NickPham01/ES100/FinalReport/FinalImages/FR_B_straight.pdf

Audio Precision | 03/22/19 18:35:58

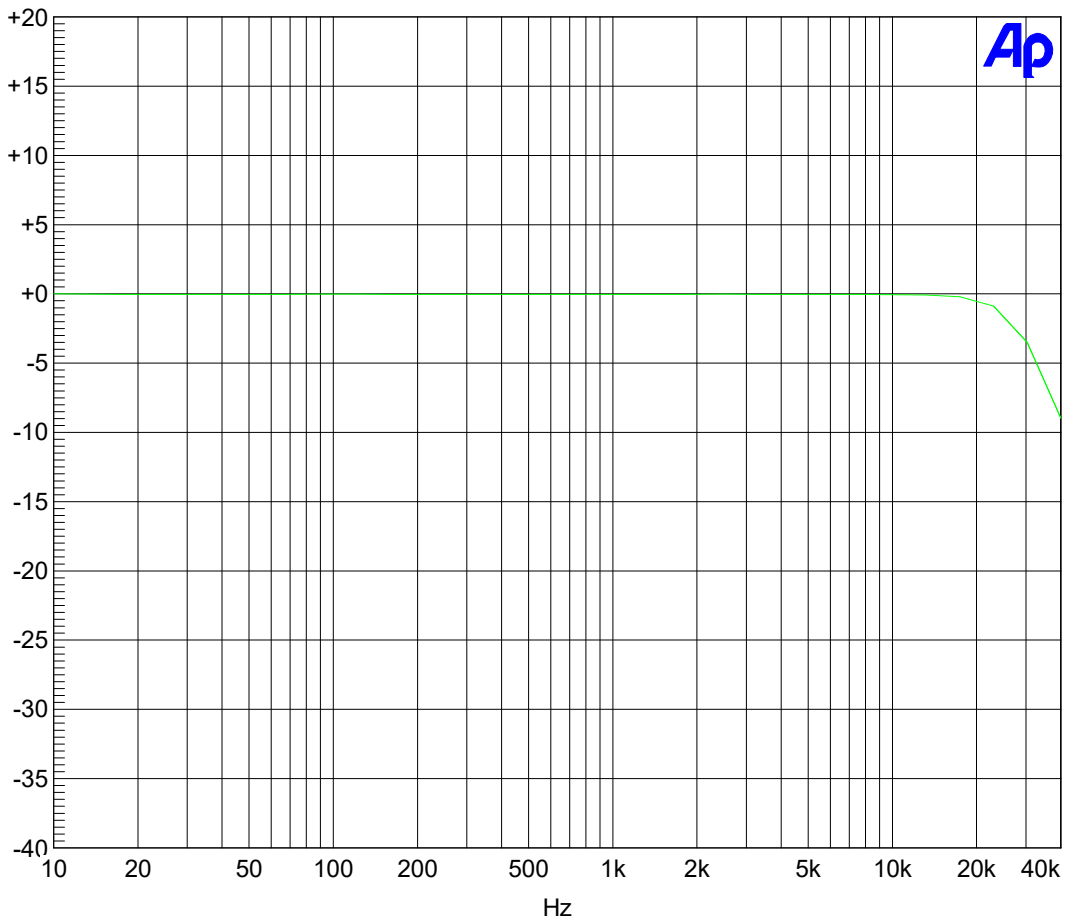
[picture p63: figure]

Pham THD_A.at1

Sweep Trace Color | Line Style Thick Data | Axis Comment
1 | 1 | Green Solid | 1 | Anlr.Ampl Left

d
B
u
