NickPham01/ES100/FinalReport/FinalImages/SummingAmpFR_A&B.pdf

Audio Precision | 03/22/19 18:29:06

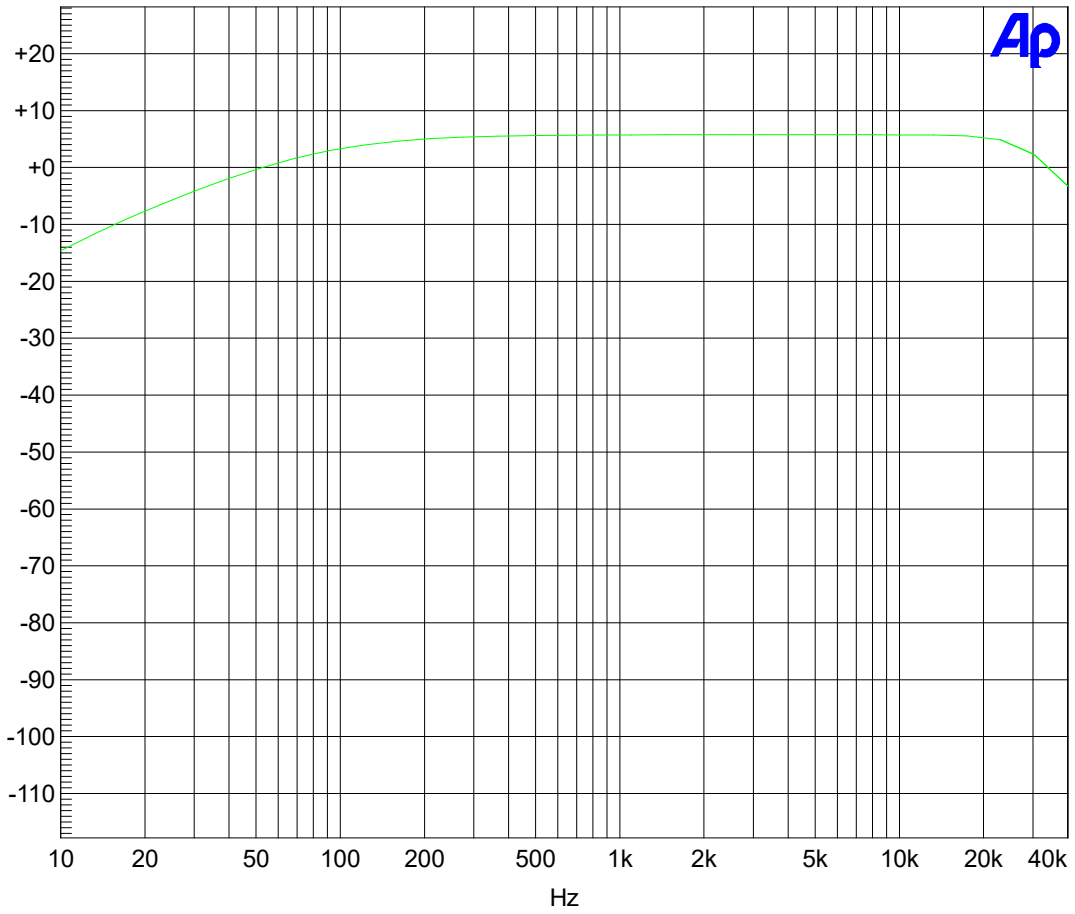
[picture p64: figure]

Pham THD_A.at1

Sweep Trace Color | Line Style Thick Data | Axis Comment
1 | 1 | Green Solid | 1 | Anlr.Ampl Left

d
B
u
