NickPham01/ES100/FinalReport/FinalImages/THDN_B_straight.pdf

Summing Amplifier THD+N | 03/22/19 17:54:46

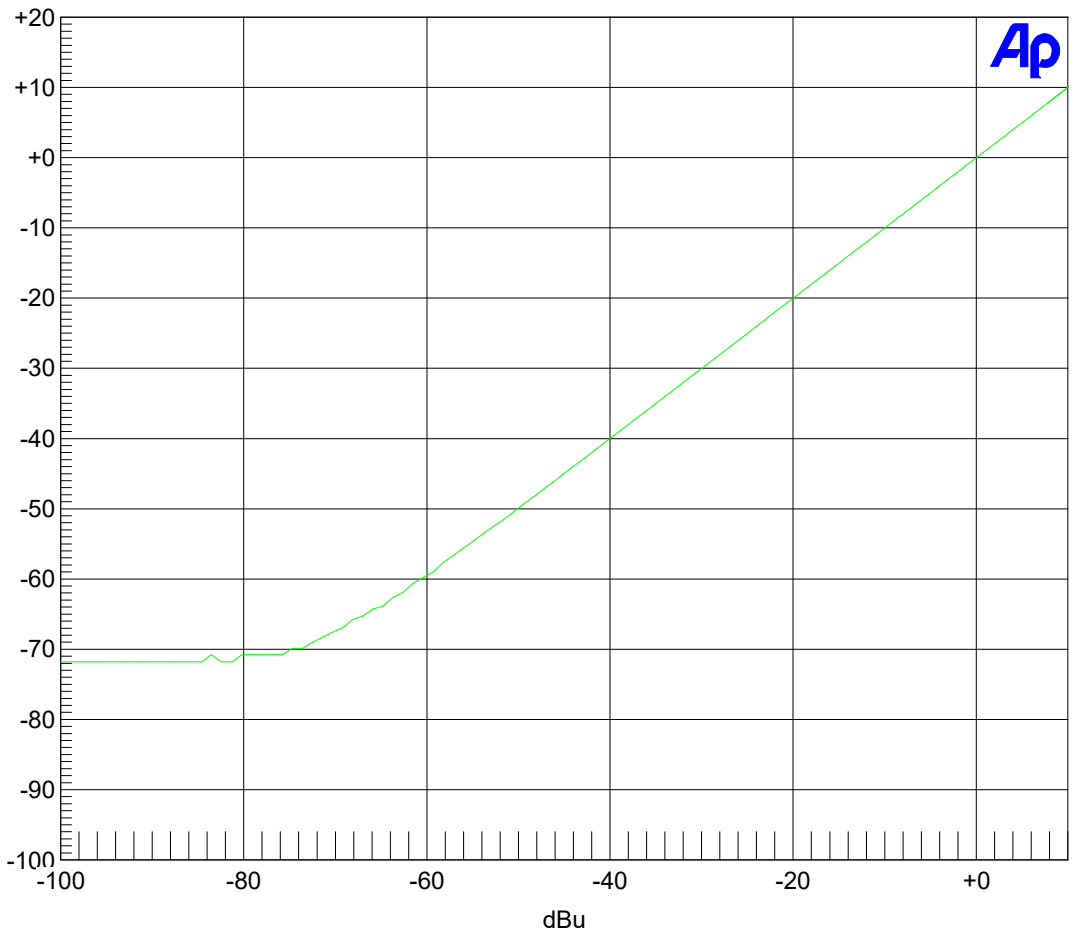
[picture p66: figure]
dBu

Pham THD_A.at1

Sweep Trace Color | Line Style Thick Data | Axis Comment
1 | 1 | Green Solid | 1 | Anlr.Level A Left

d
B
u
