NickPham01/ES100/FinalReport/titlepage.tex

\begin{titlepage}
	\begin{center}
		\vspace*{0.5in}
		\huge
		\textbf{Hot Swappable Guitar Effects Pedal Auditioning System}\\
		\vspace*{1in}
		\Large
		\textbf{Nicholas Pham} \\
		S.B. Candidate in Electrical Engineering \\
		\vspace*{0.5in}
		\textbf{Advisors: Jim MacAurthur, Scott Kuindersma}

		\vfill

		A senior design project submitted in partial fulfillment of the reqirements for the degree of Bachelor of Science at Harvard University. \\
		\vspace*{0.1in}

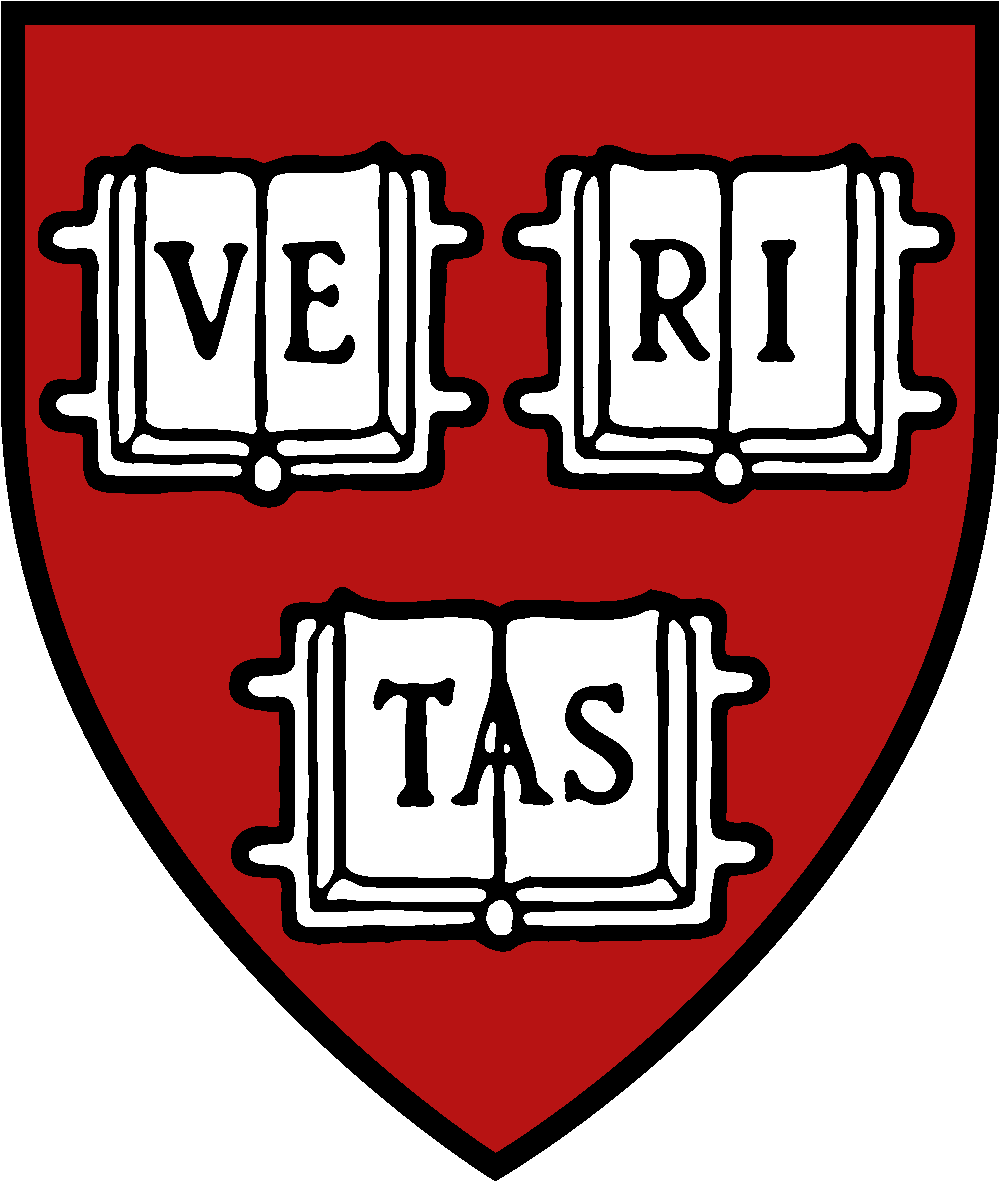
[picture p67: FinalReport/FinalImages/Harvard_shield-University.png]
		\\
		
		\vspace*{0.1in}
	    Harvard University School of Engineering and Applied Science \\
	    Cambridge, Massachusetts \\
	    April 5, 2019
	\end{center}
\end{titlepage}
