NickPham01/ES100/FinalPresentationReport/presentationLatex.pdf

r = % Reduction = tStandard − tSolution

tStandard

wk =

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
riwi = 65%

σ = 8.0%

Let
n = noise floor
m = maximum signal level

max signal = 18Vpp = 18.3 dBu
ndirect = −96.4 dBu (σ = 0.30 for n = 20) nsum = −72.2 dBu (σ = 0.11 for n = 20)

1

SNR =

m(V )
n(V )

= m(dBu) − n (dBu)

SNRdirect = 114.7 dBu
SNRsum = 90.5 dBu

2
