NickPham01/ES100/DesignReview/BlackPedalConnections.png

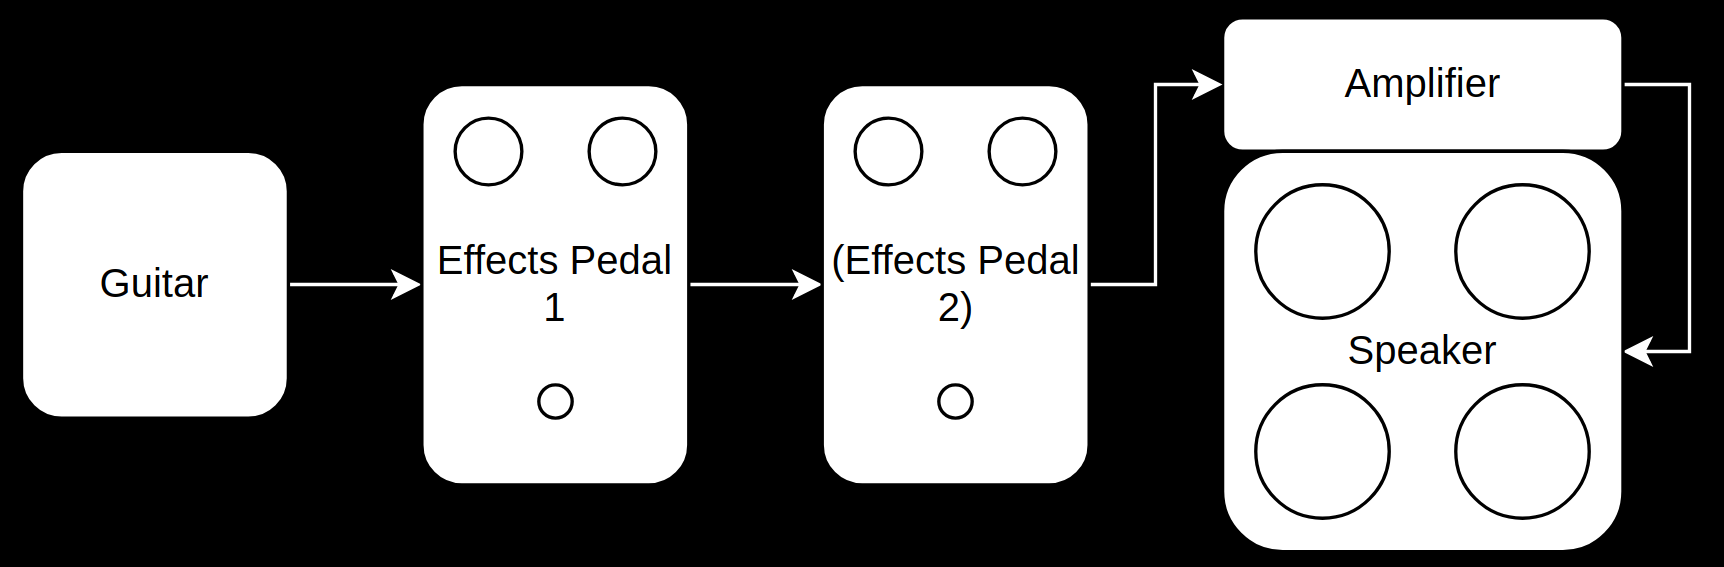
DesignReview/BlackPedalConnections.png
