NickPham01/ES100/DesignReview/GuitarPedalConnections.png

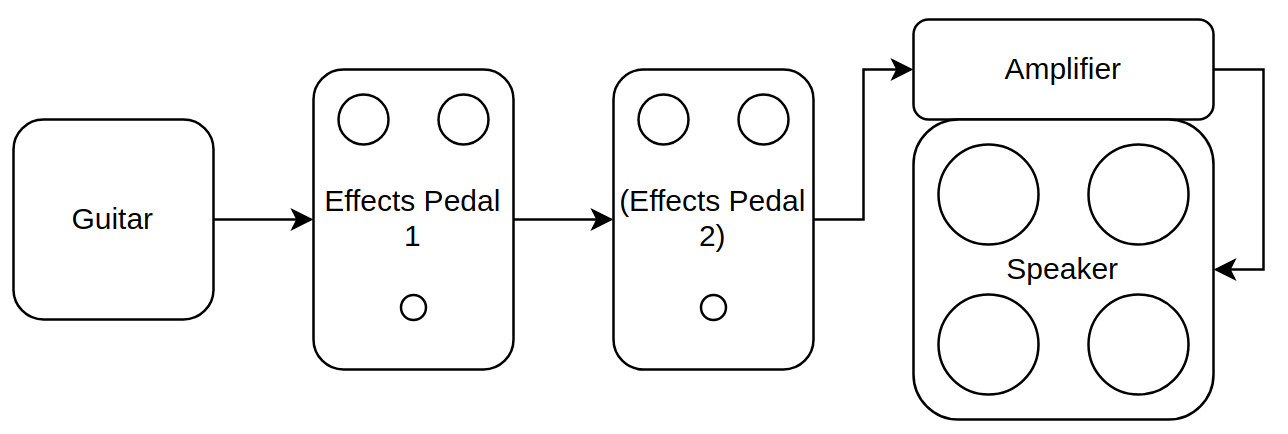
DesignReview/GuitarPedalConnections.png
