NickPham01/ES100/DesignReview/ReceiverAsm.PNG

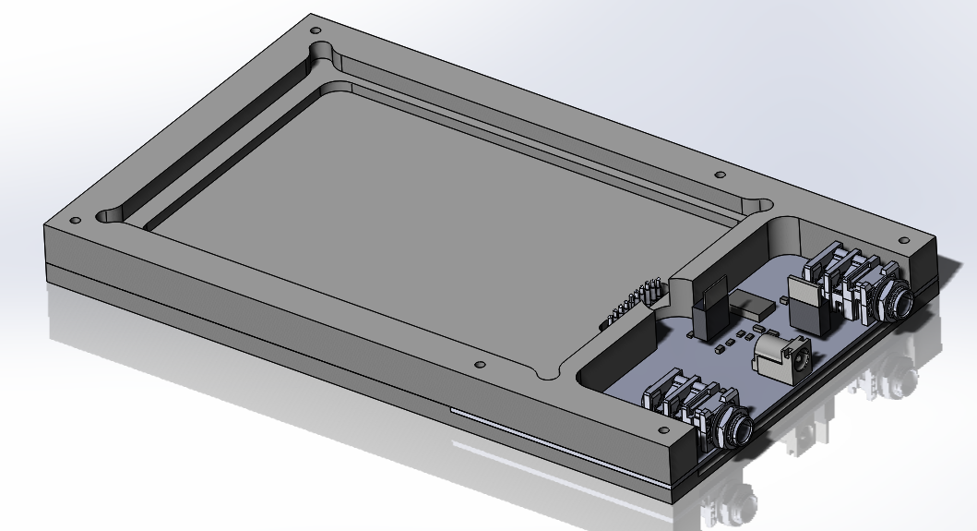
DesignReview/ReceiverAsm.PNG
