NickPham01/ES100/DesignReview/ReceiverPlateWPedal.PNG

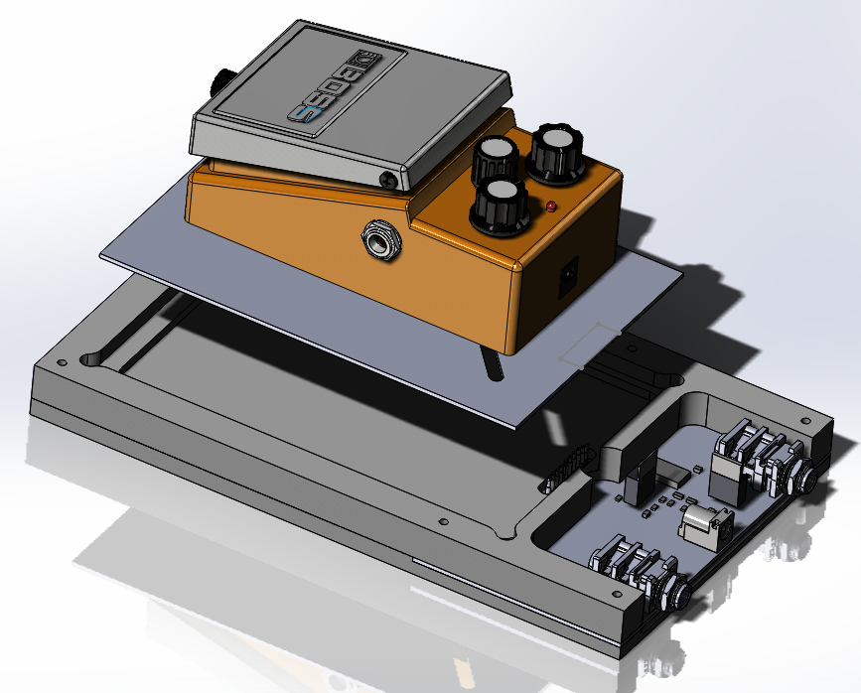
DesignReview/ReceiverPlateWPedal.PNG
