NickPham01/ES100/DesignReview/SystemDiagram.png

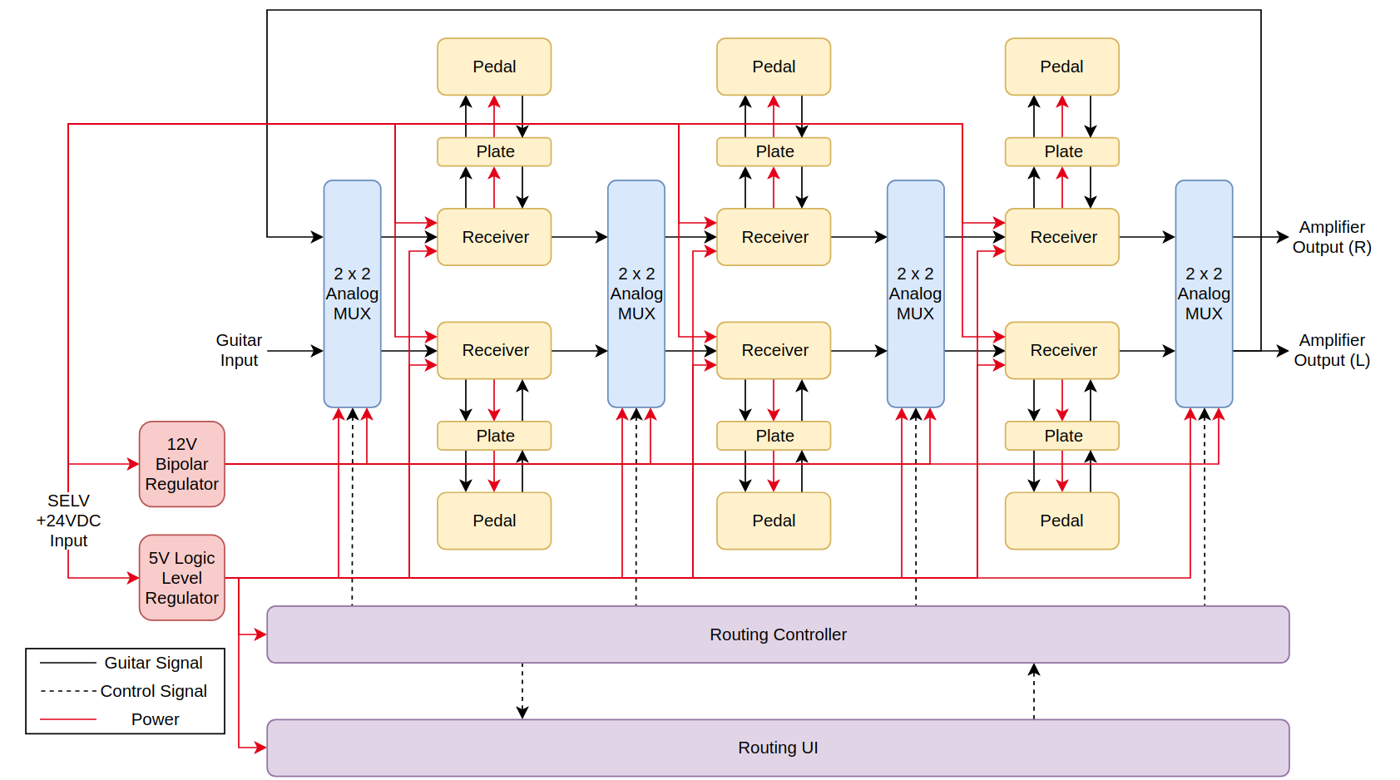
DesignReview/SystemDiagram.png
