NickPham01/ES100/DesignReview/Timeline.png

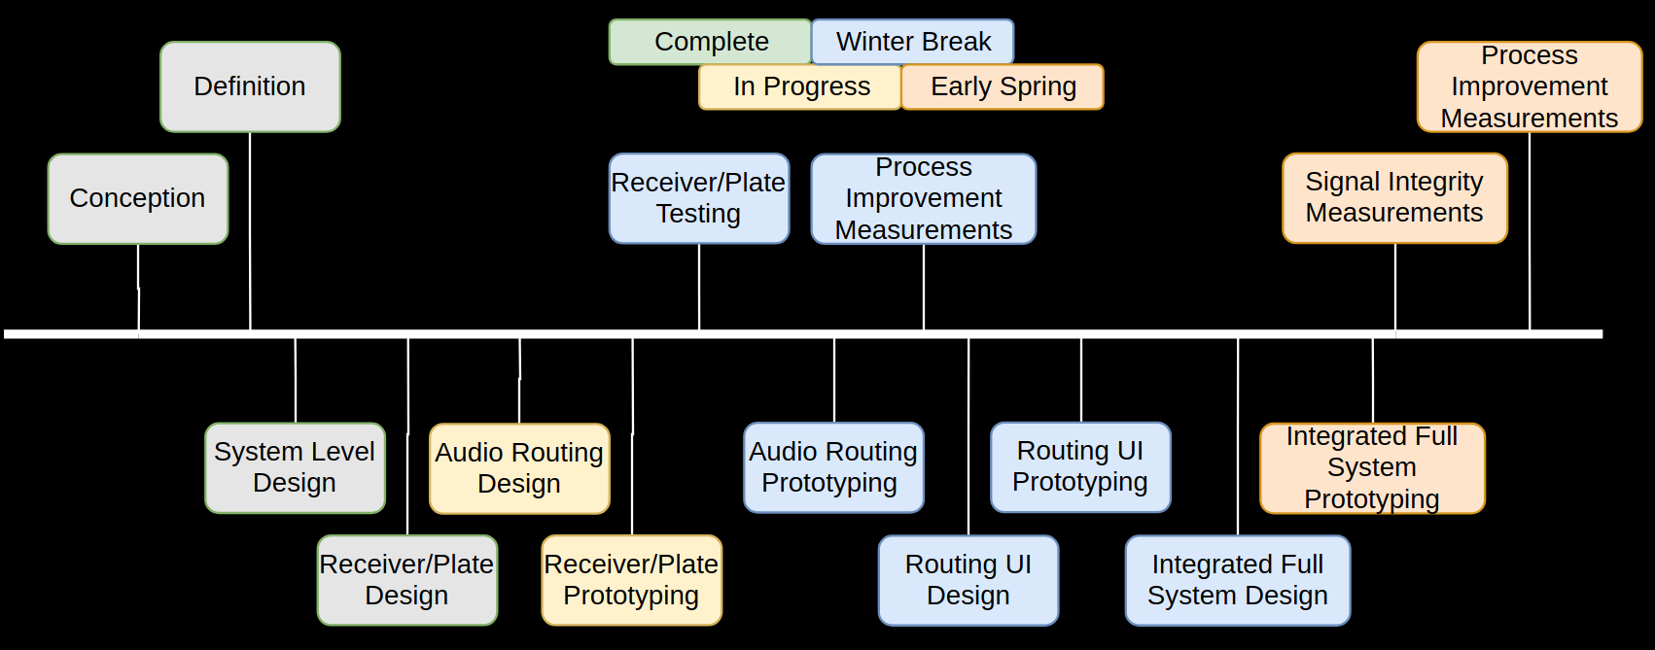
DesignReview/Timeline.png
