NickPham01/ES100/FinalPresentationReport/average_savings_formula.png

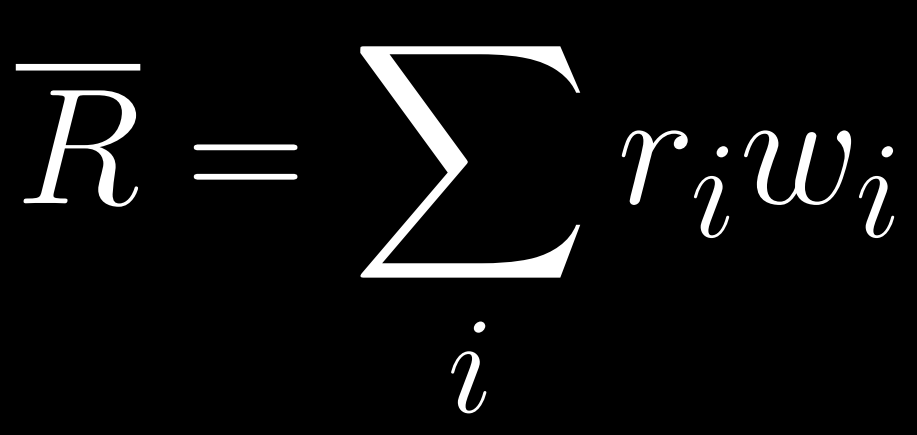
FinalPresentationReport/average_savings_formula.png
