NickPham01/ES100/FinalPresentationReport/DirectFrequencyResponse_black.jpg

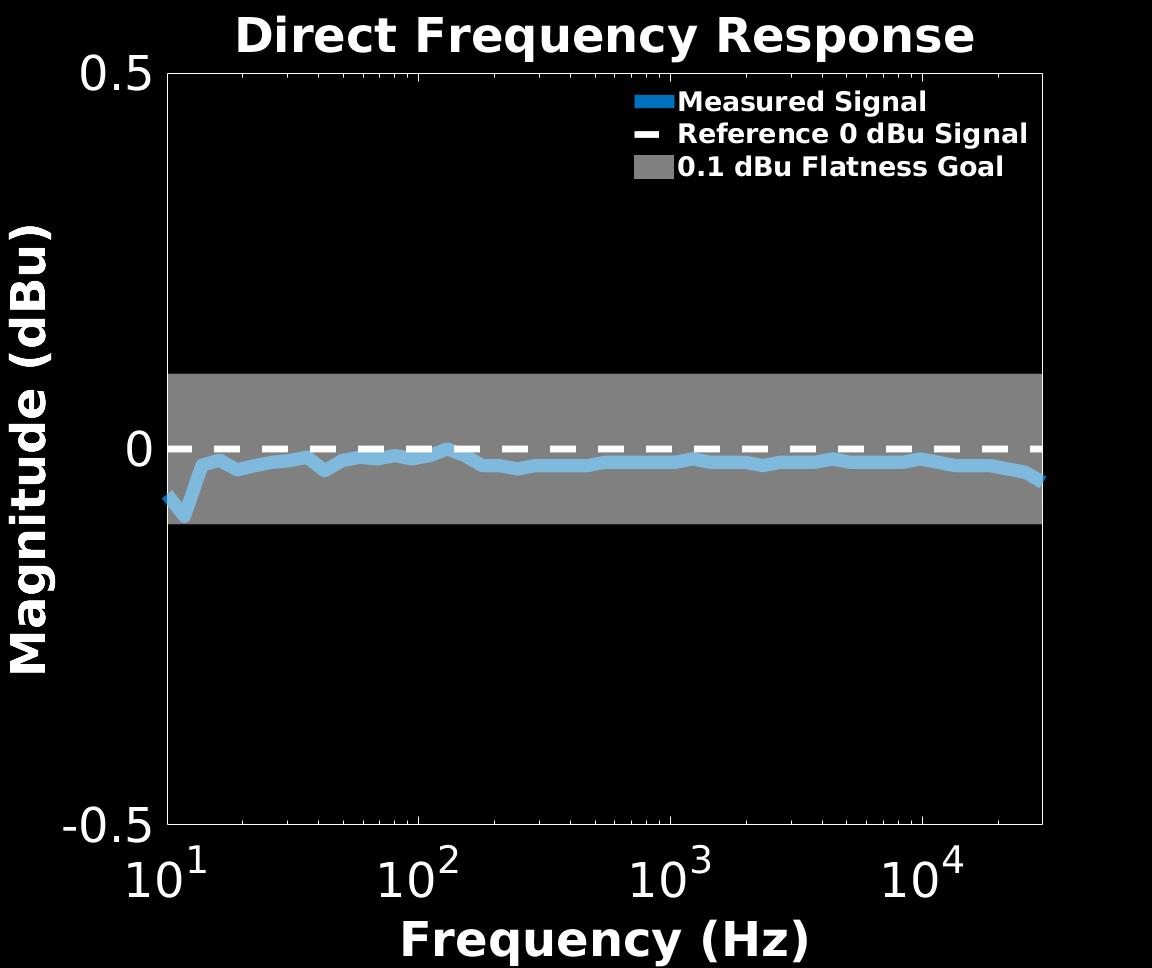
FinalPresentationReport/DirectFrequencyResponse_black.jpg
