NickPham01/ES100/FinalPresentationReport/inverse_variance_weights_formula.png

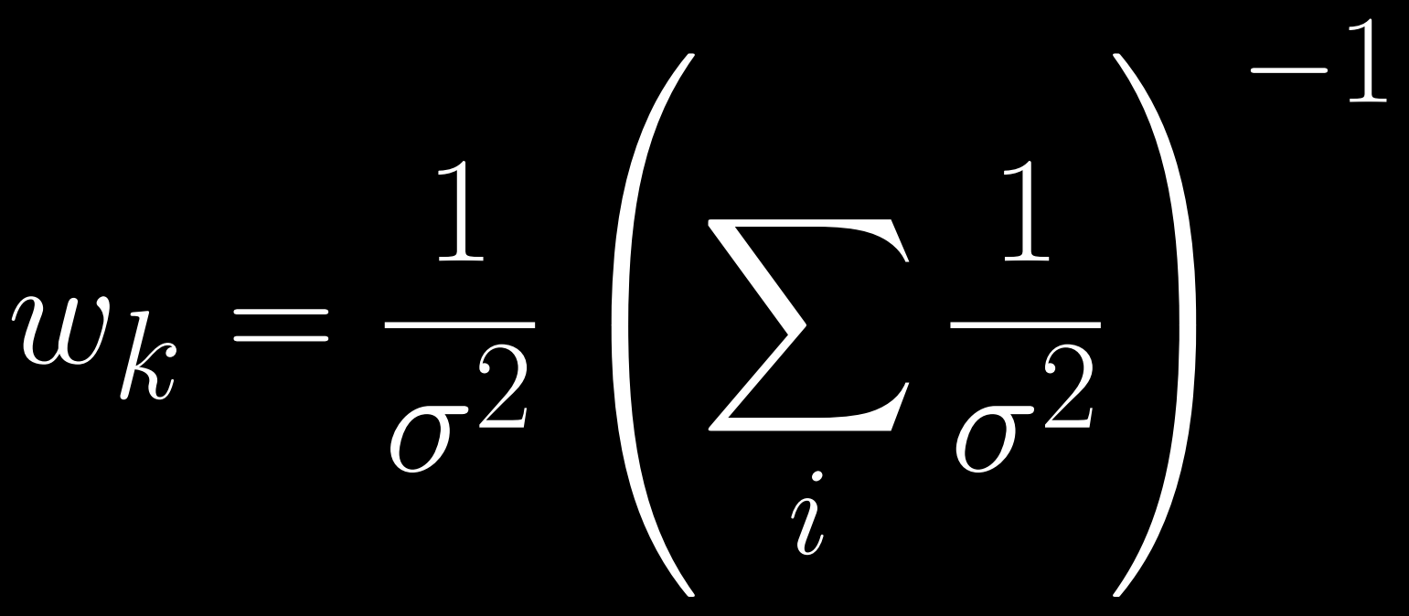
FinalPresentationReport/inverse_variance_weights_formula.png
