NickPham01/ES100/FinalPresentationReport/PedalAdaptorPlateBlock.png

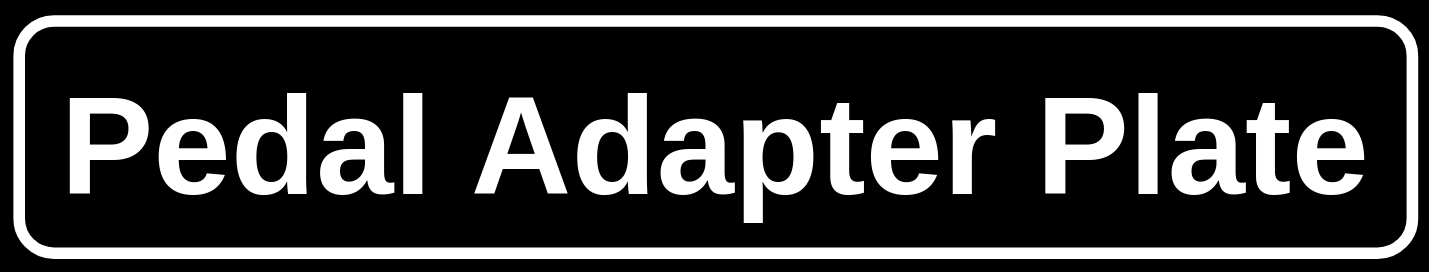
FinalPresentationReport/PedalAdaptorPlateBlock.png
