NickPham01/ES100/FinalPresentationReport/percent_reduction_formula.png

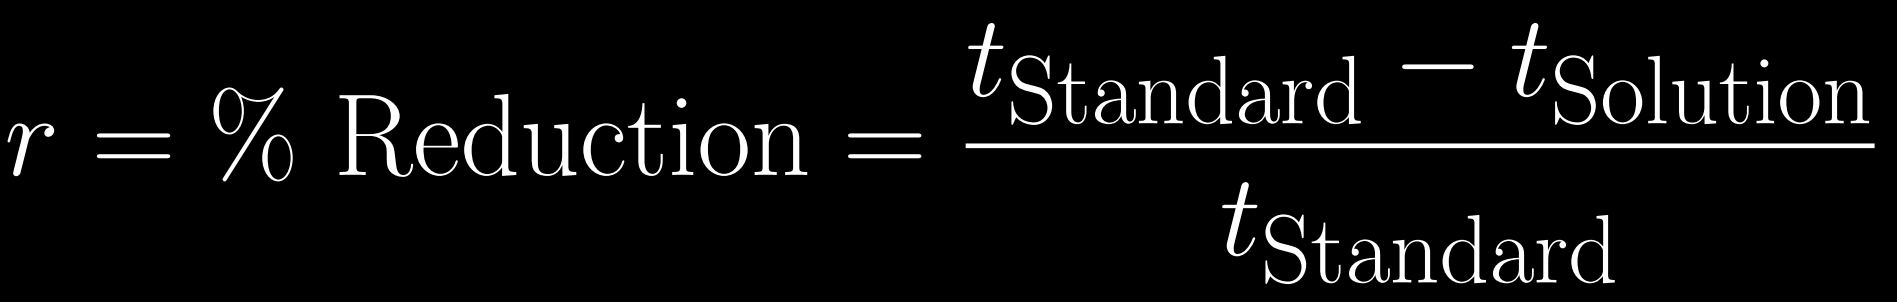
FinalPresentationReport/percent_reduction_formula.png
