NickPham01/ES100/FinalPresentationReport/PlateSizeCompatibilityPlot_black.jpg

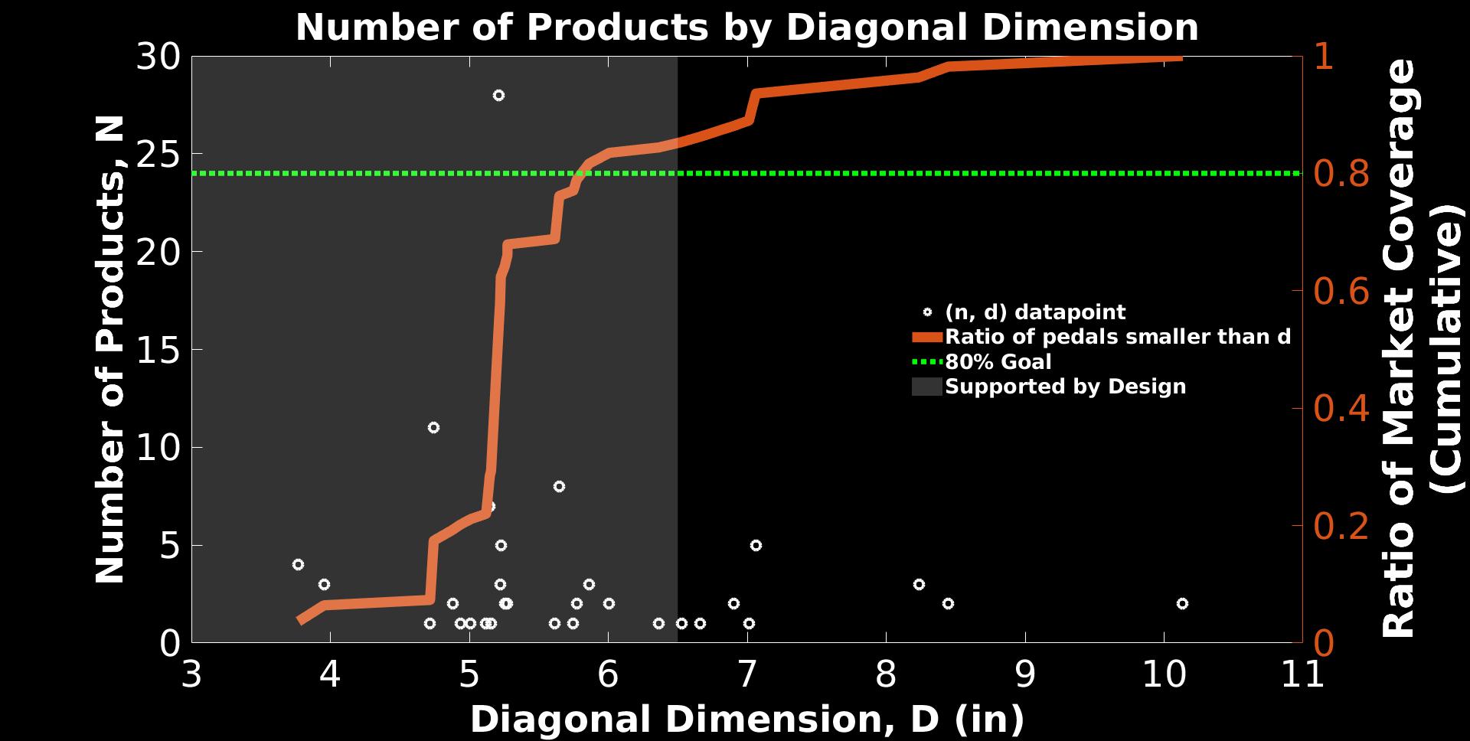
FinalPresentationReport/PlateSizeCompatibilityPlot_black.jpg
