NickPham01/ES100/FinalPresentationReport/SNR_calc_definition.png

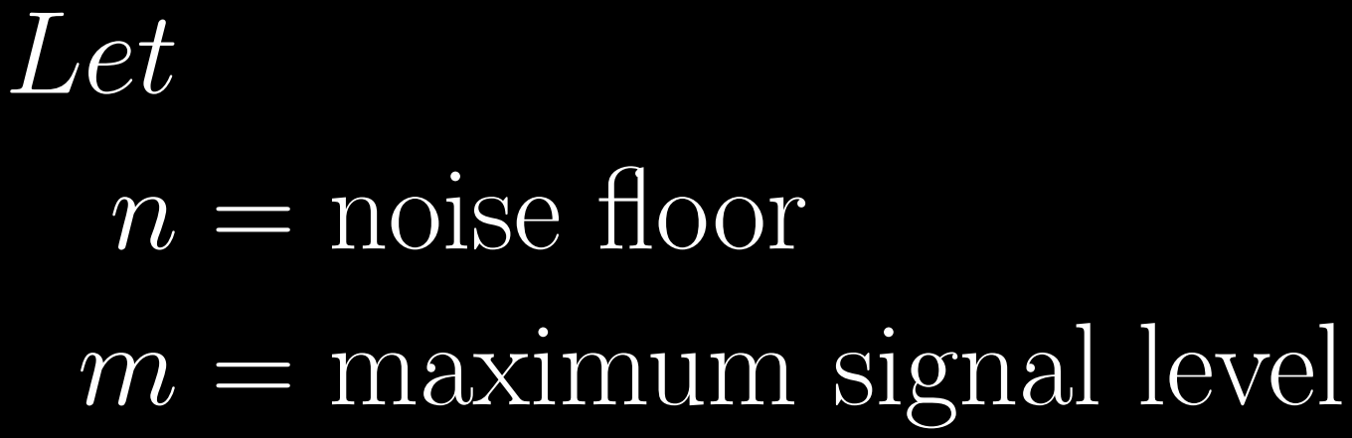
FinalPresentationReport/SNR_calc_definition.png
