NickPham01/ES100/FinalPresentationReport/SNR_calc_numbers.png

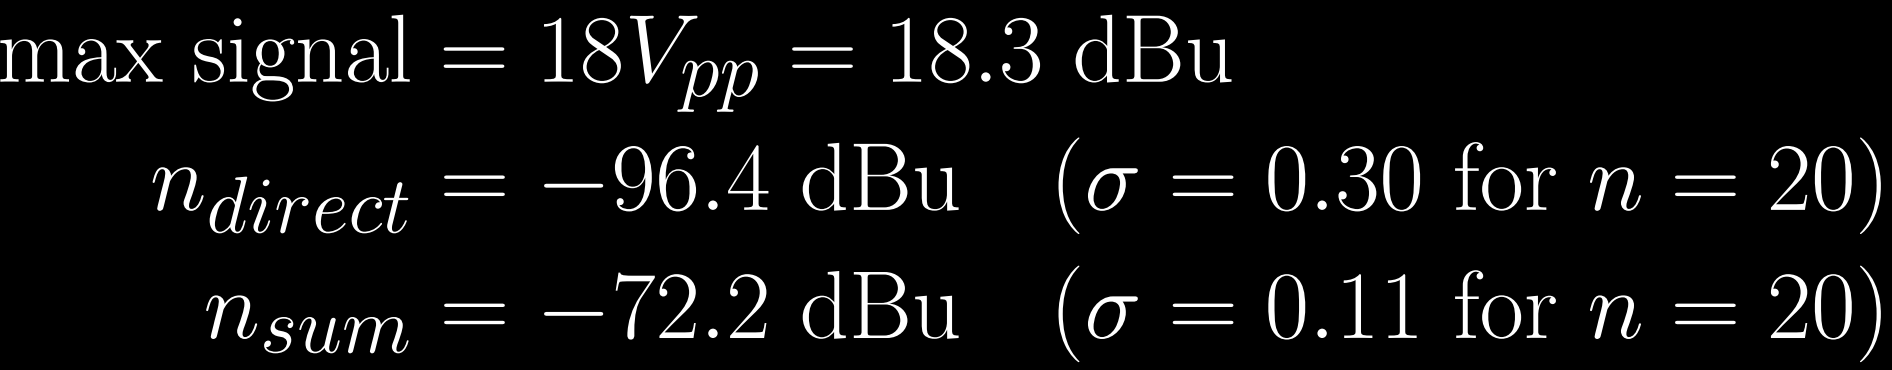
FinalPresentationReport/SNR_calc_numbers.png
