NickPham01/ES100/FinalPresentationReport/stats_formulas.png

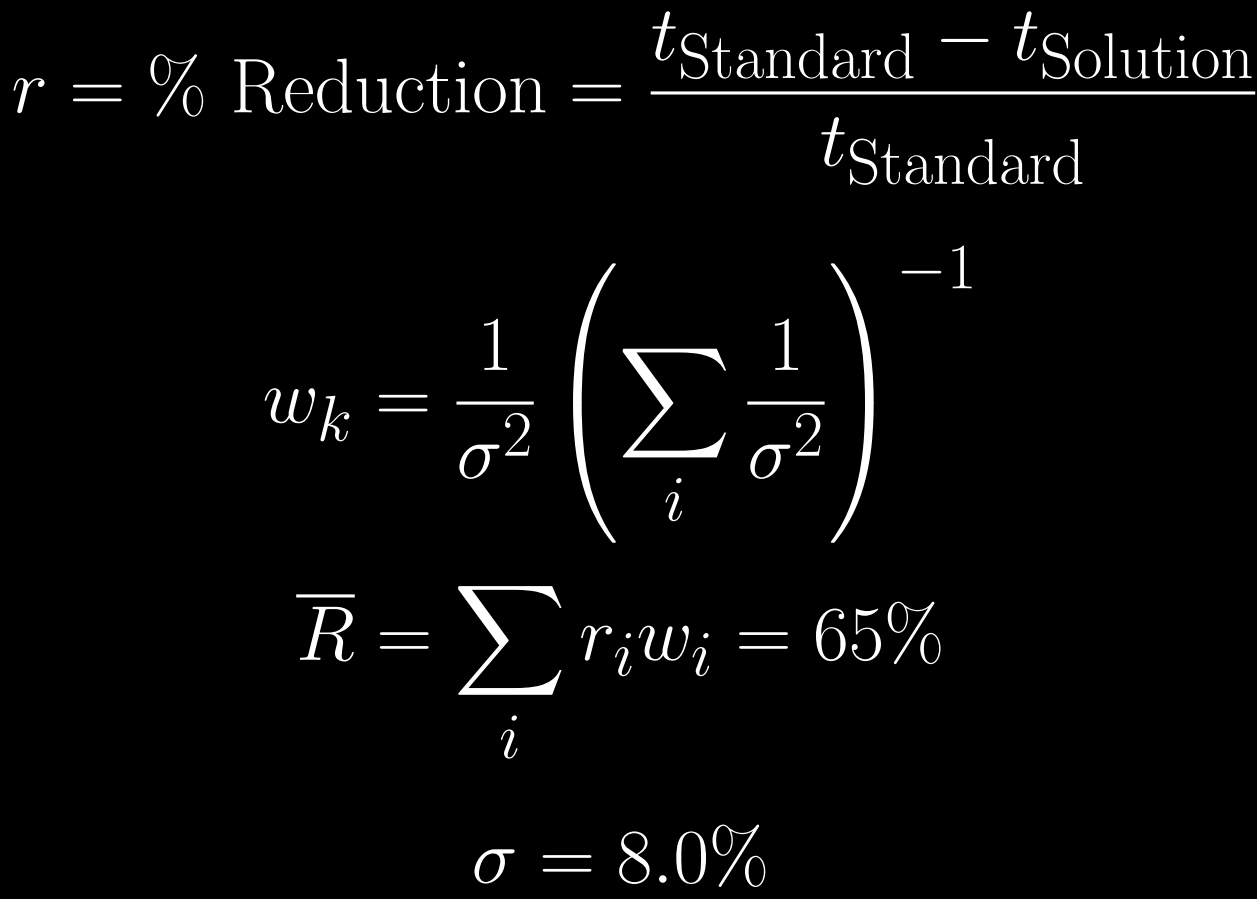
FinalPresentationReport/stats_formulas.png
