NickPham01/ES100/FinalPresentationReport/SwapTimebyParticipant_black.jpg

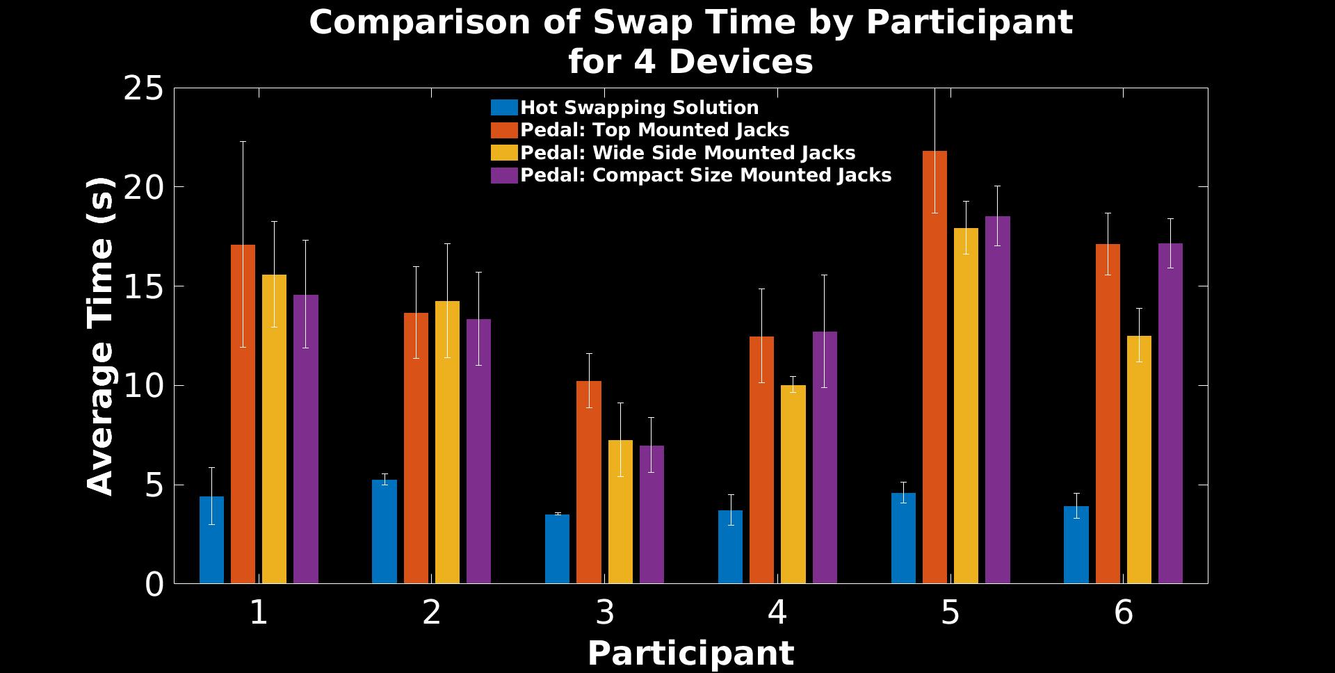
FinalPresentationReport/SwapTimebyParticipant_black.jpg
