NickPham01/ES100/FinalReport/FinalImages/ModuleBlock_black.png

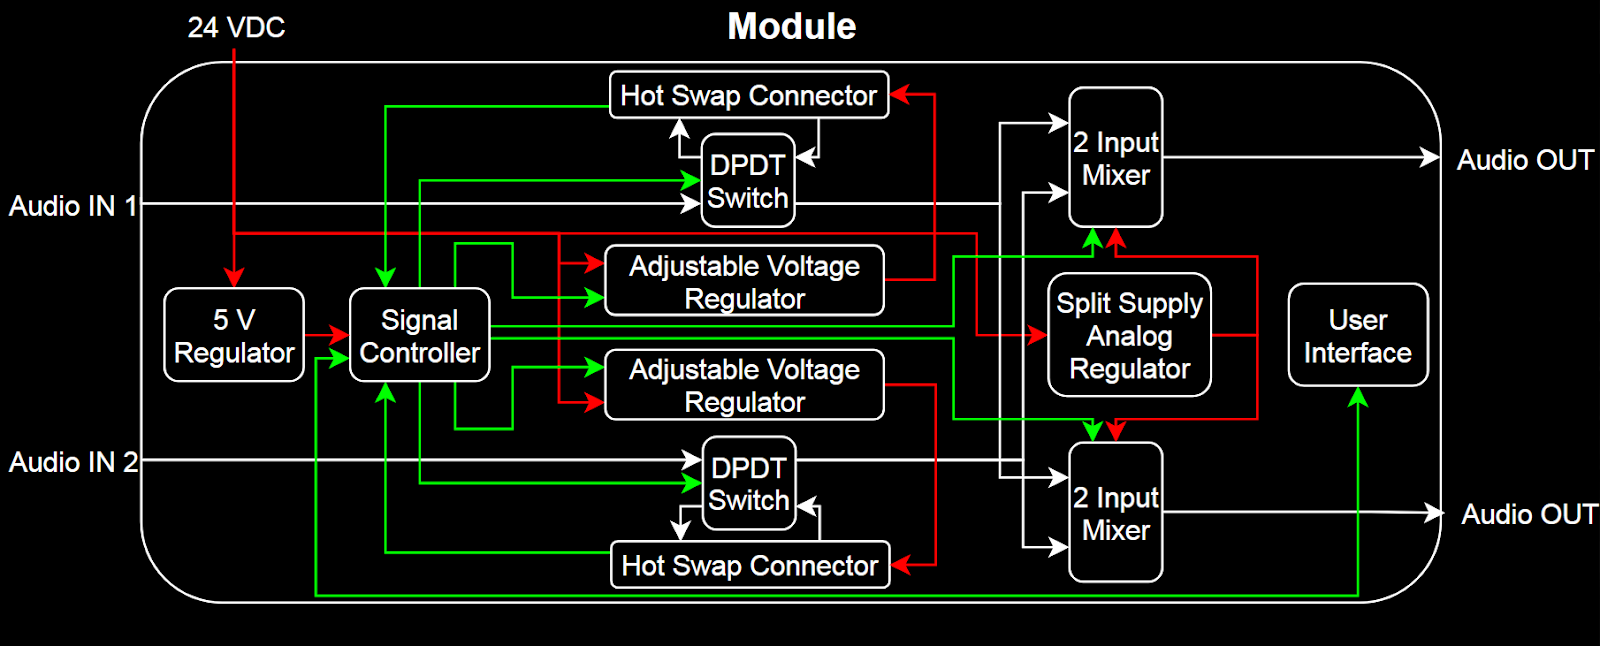
FinalReport/FinalImages/ModuleBlock_black.png
