NickPham01/ES100/FinalReport/FinalImages/ModuleBlock_inv.png

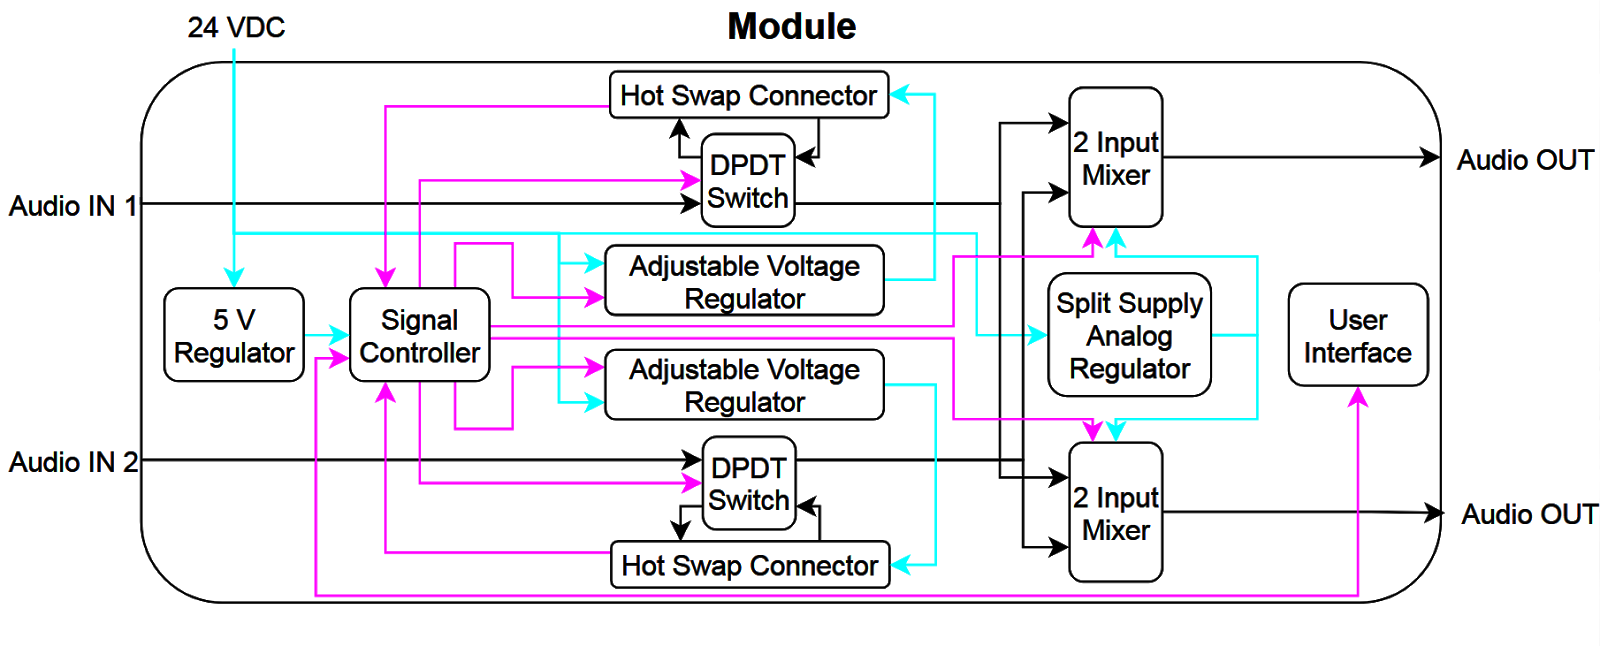
FinalReport/FinalImages/ModuleBlock_inv.png
