NickPham01/ES100/FinalReport/FinalImages/ModuleBlock_white.jpg

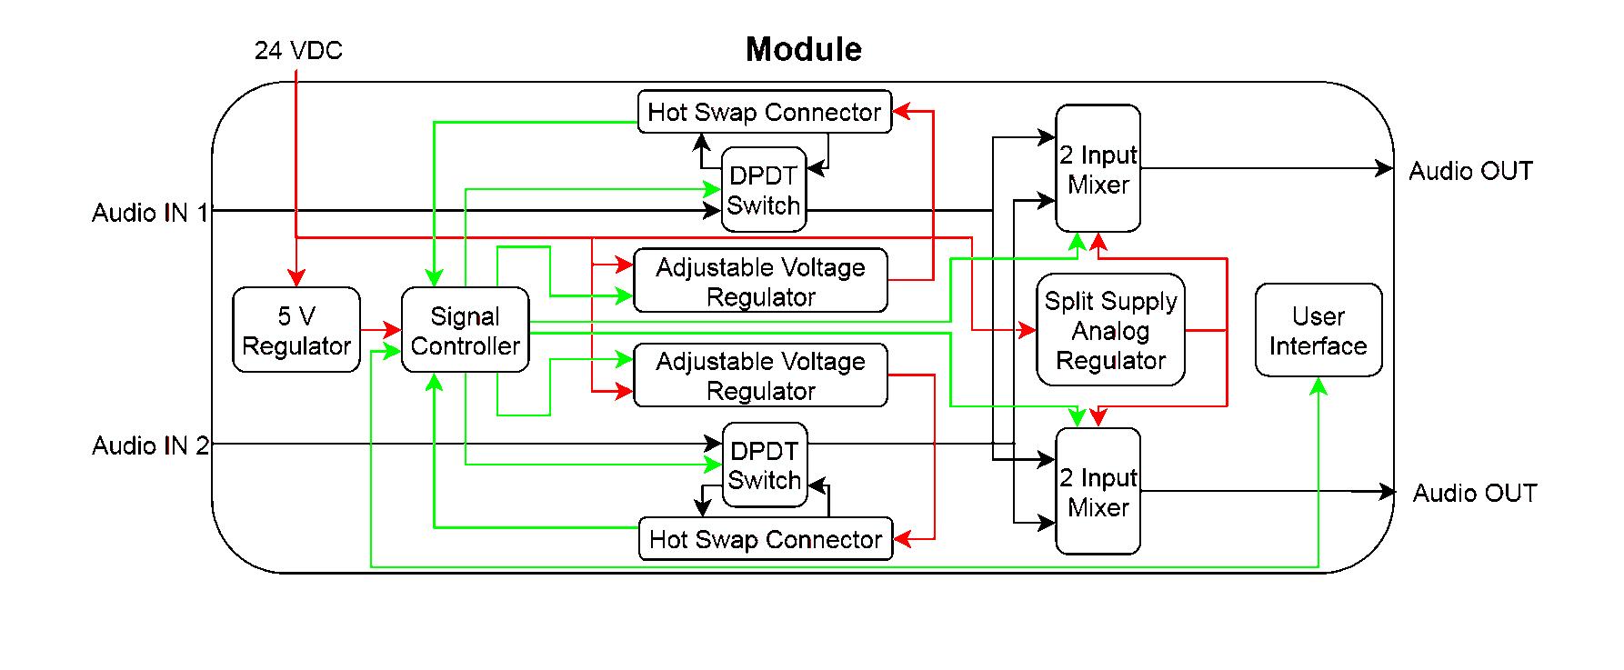
FinalReport/FinalImages/ModuleBlock_white.jpg
