NickPham01/ES100/FinalReport/FinalImages/PedalCompatibilityPlot.jpg

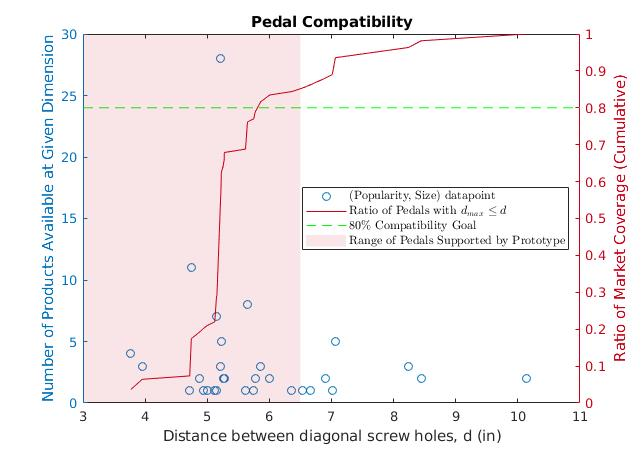
FinalReport/FinalImages/PedalCompatibilityPlot.jpg
