NickPham01/ES100/FinalReport/FinalImages/SNR_bargraph.png

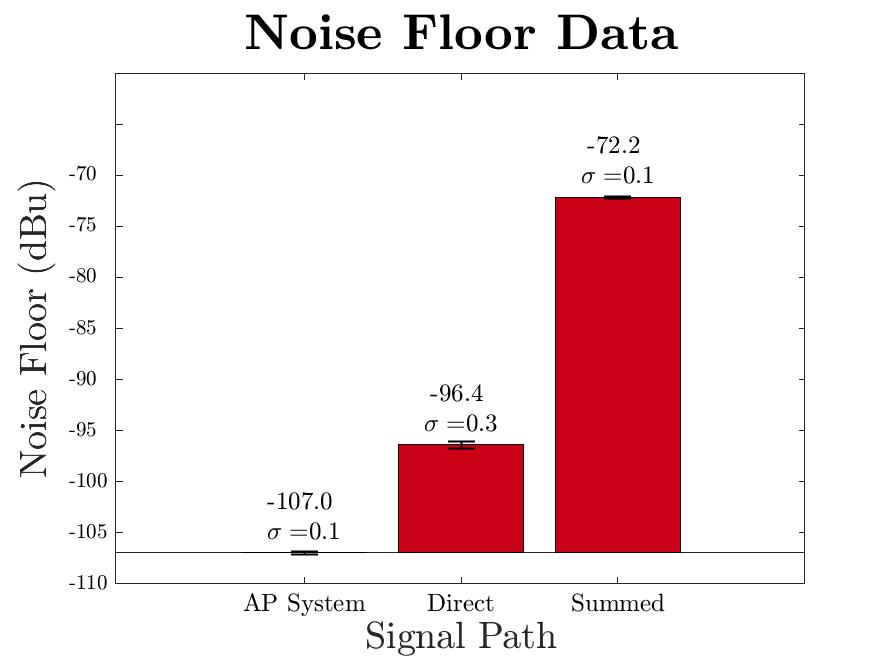
FinalReport/FinalImages/SNR_bargraph.png
