NickPham01/ES100/FinalReport/FinalImages/SwapTime_data.png

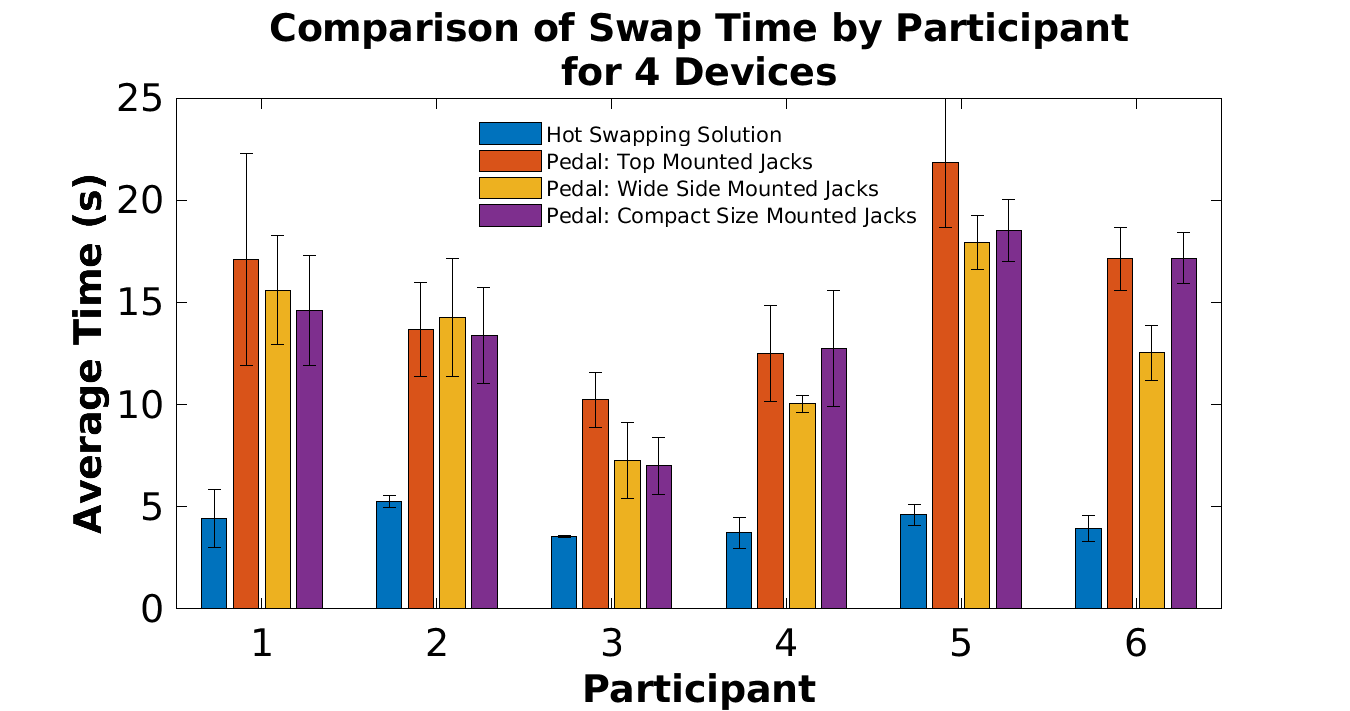
FinalReport/FinalImages/SwapTime_data.png
