NickPham01/ES100/FinalReport/FinalImages/switch2sum.png

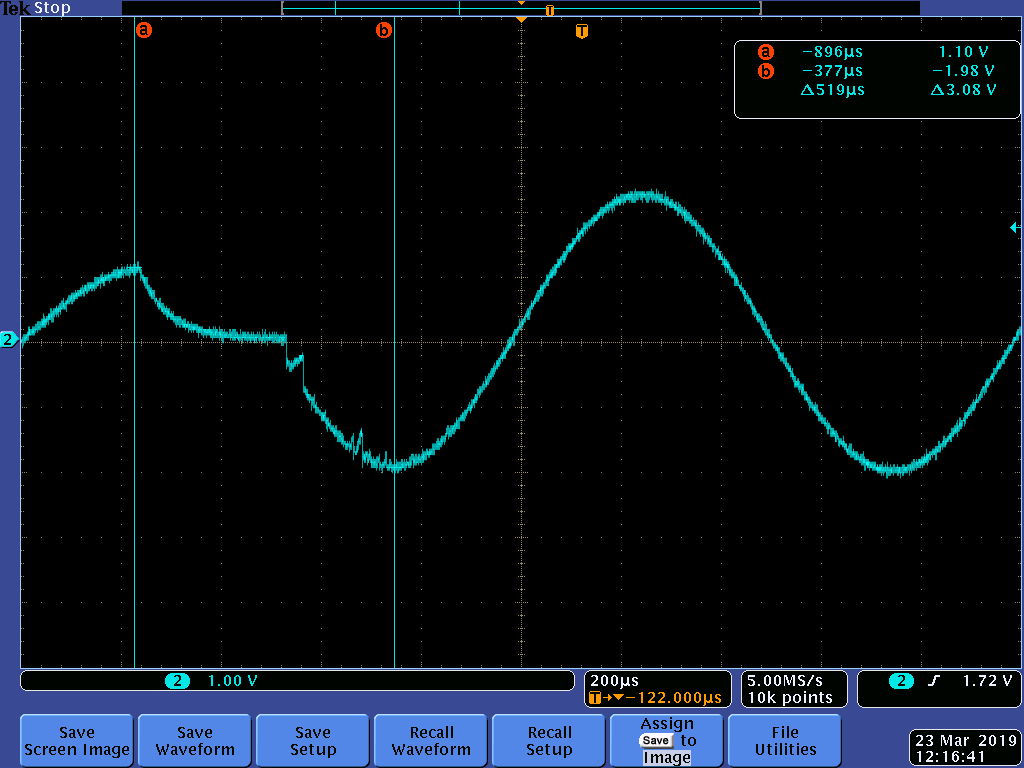
FinalReport/FinalImages/switch2sum.png
