NickPham01/ES100/FinalReport/FinalImages/Switch_bargraph.png

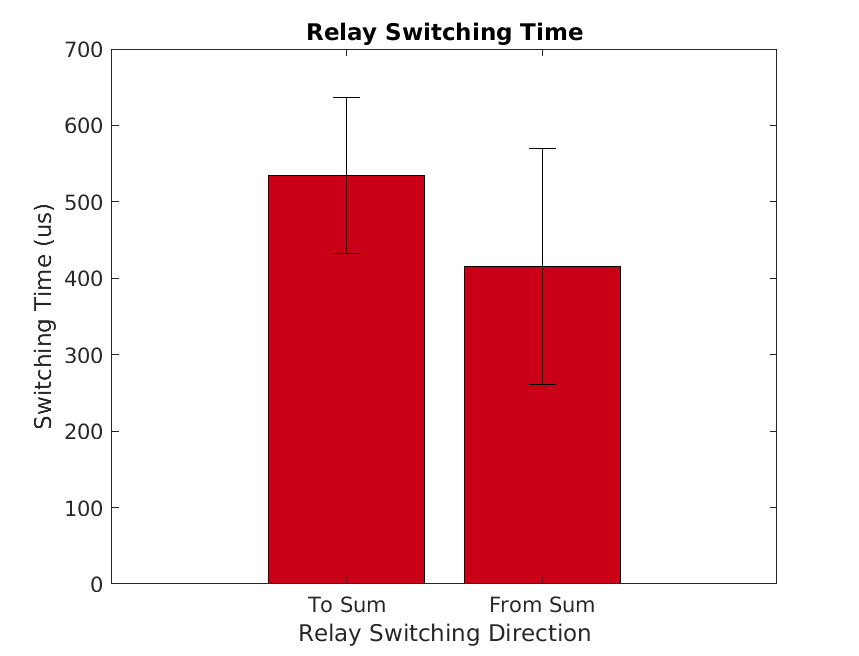
FinalReport/FinalImages/Switch_bargraph.png
