NickPham01/ES100/FinalReport/FinalImages/SystemBlock_black.png

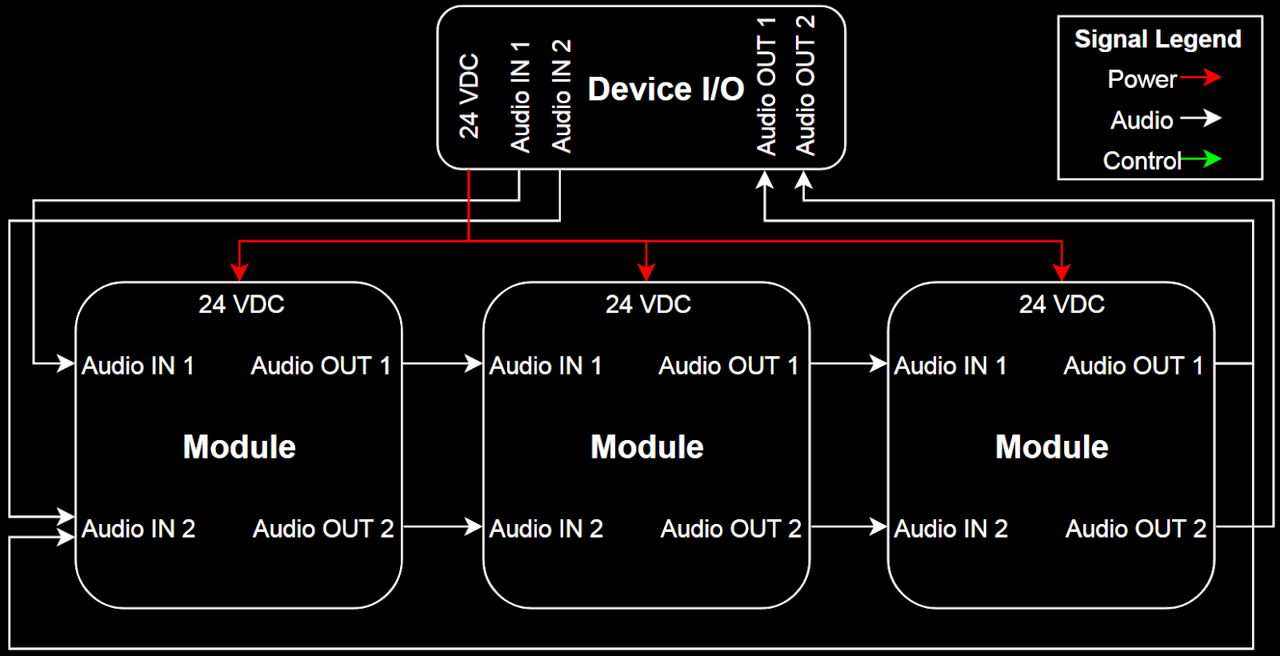
FinalReport/FinalImages/SystemBlock_black.png
