NickPham01/ES100/FinalReport/FinalImages/SystemBlock_inv.png

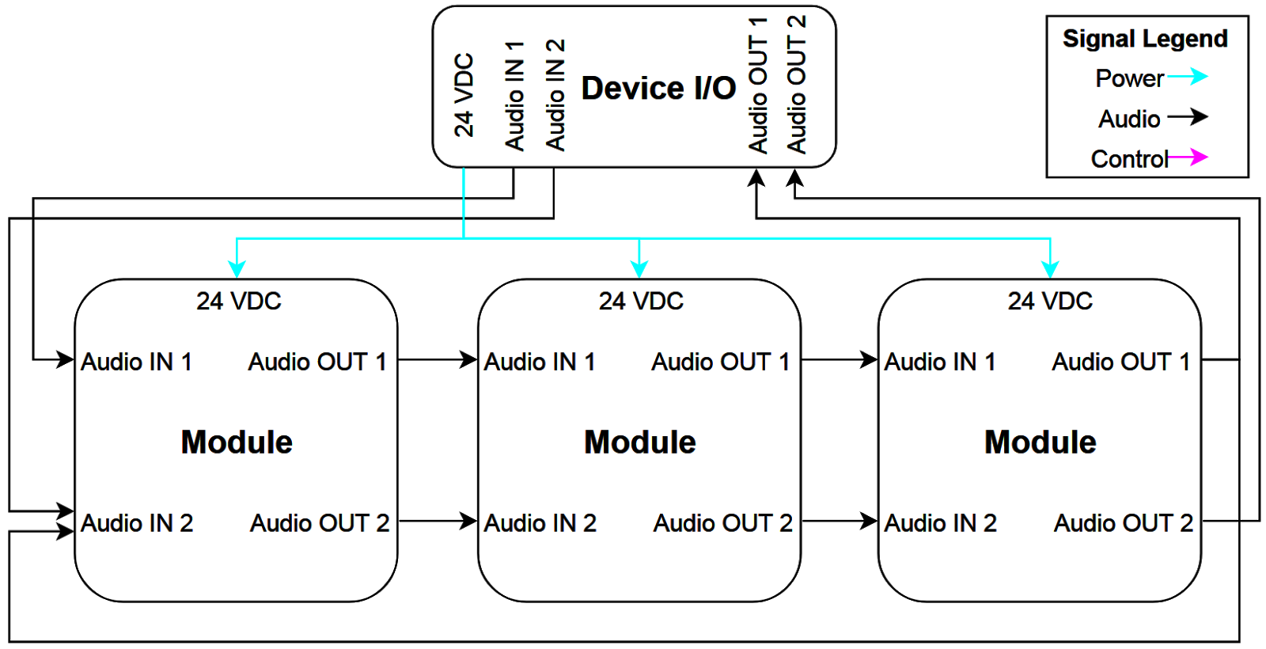
FinalReport/FinalImages/SystemBlock_inv.png
