NickPham01/ES100/FinalReport/FinalImages/SystemBlock_white.jpg

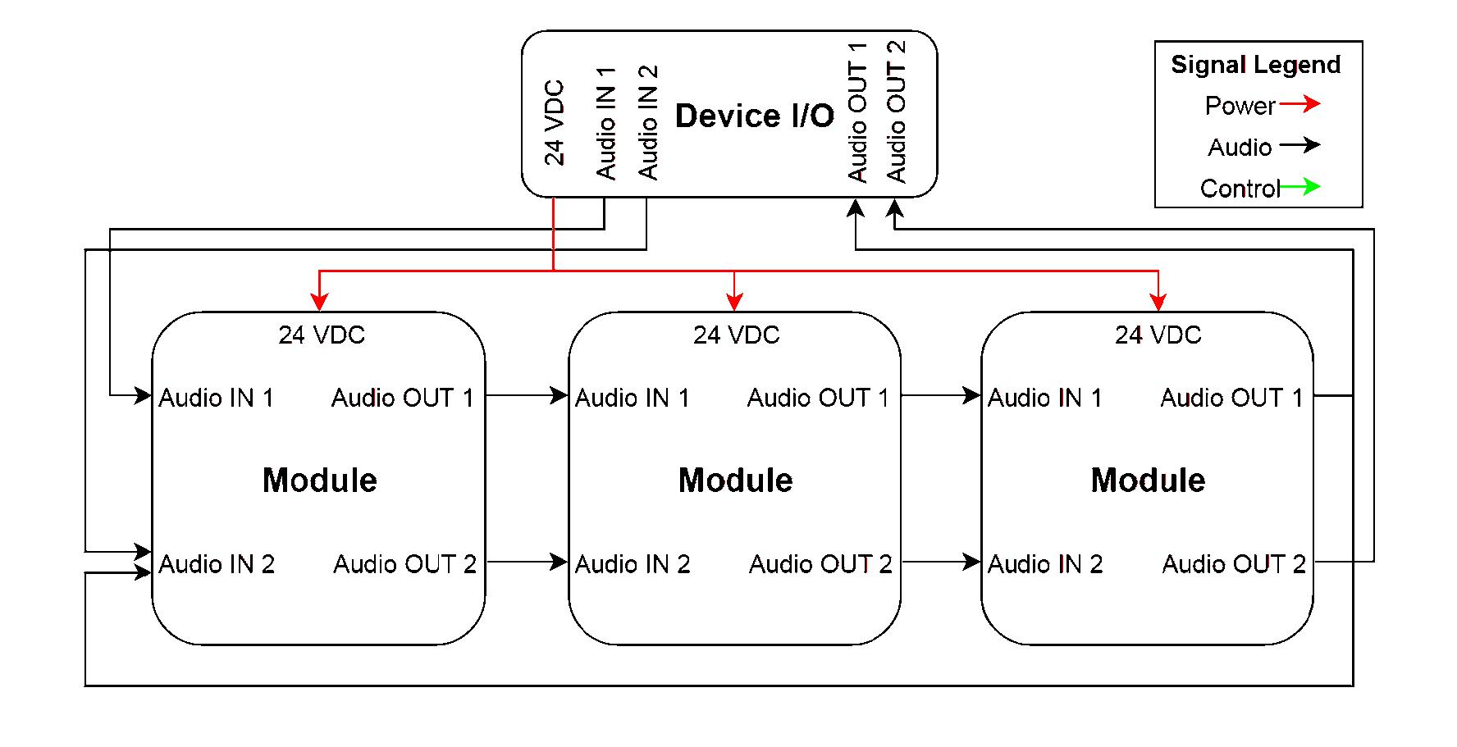
FinalReport/FinalImages/SystemBlock_white.jpg
