NickPham01/ES100/FinalReport/PR2Images/2_1mmPwrJack.jpg

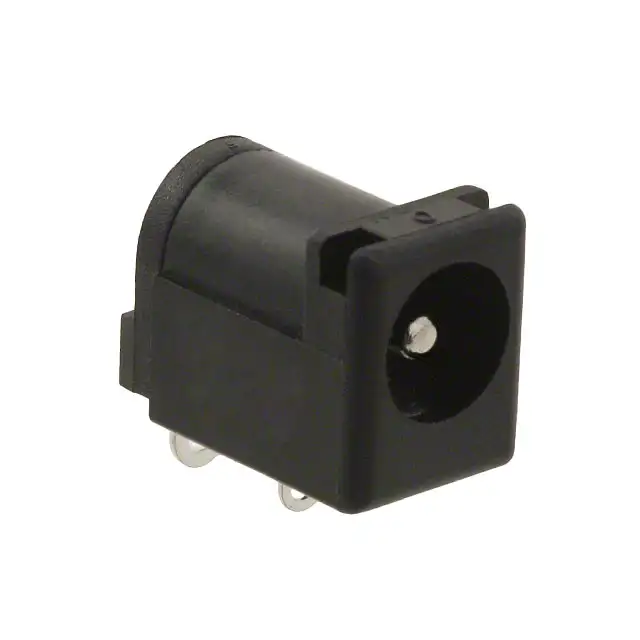
FinalReport/PR2Images/2_1mmPwrJack.jpg
