NickPham01/ES100/FinalReport/PR2Images/0914_3D_PCB_footprint.PNG

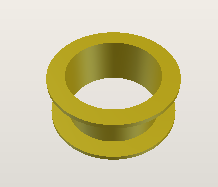
FinalReport/PR2Images/0914_3D_PCB_footprint.PNG
