NickPham01/ES100/FinalReport/PR2Images/CornerBracket3rdAngle.png

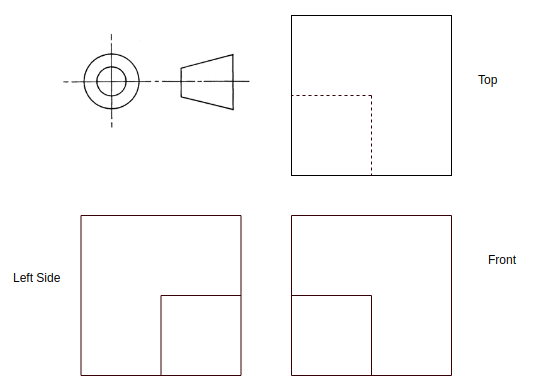
FinalReport/PR2Images/CornerBracket3rdAngle.png
