NickPham01/ES100/FinalReport/PR2Images/GuitarPickupPotModel.PNG

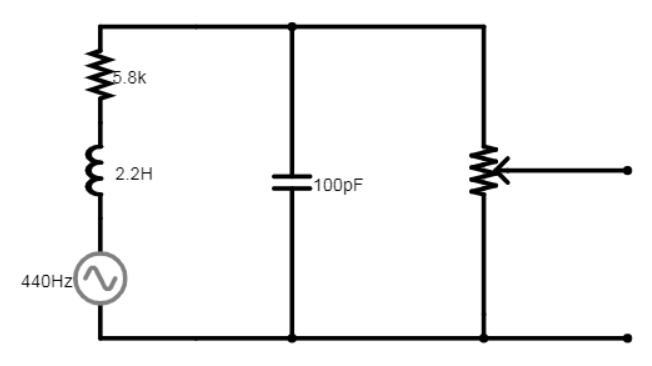
FinalReport/PR2Images/GuitarPickupPotModel.PNG
