NickPham01/ES100/FinalReport/PR2Images/PedalDimensionsPlot.png

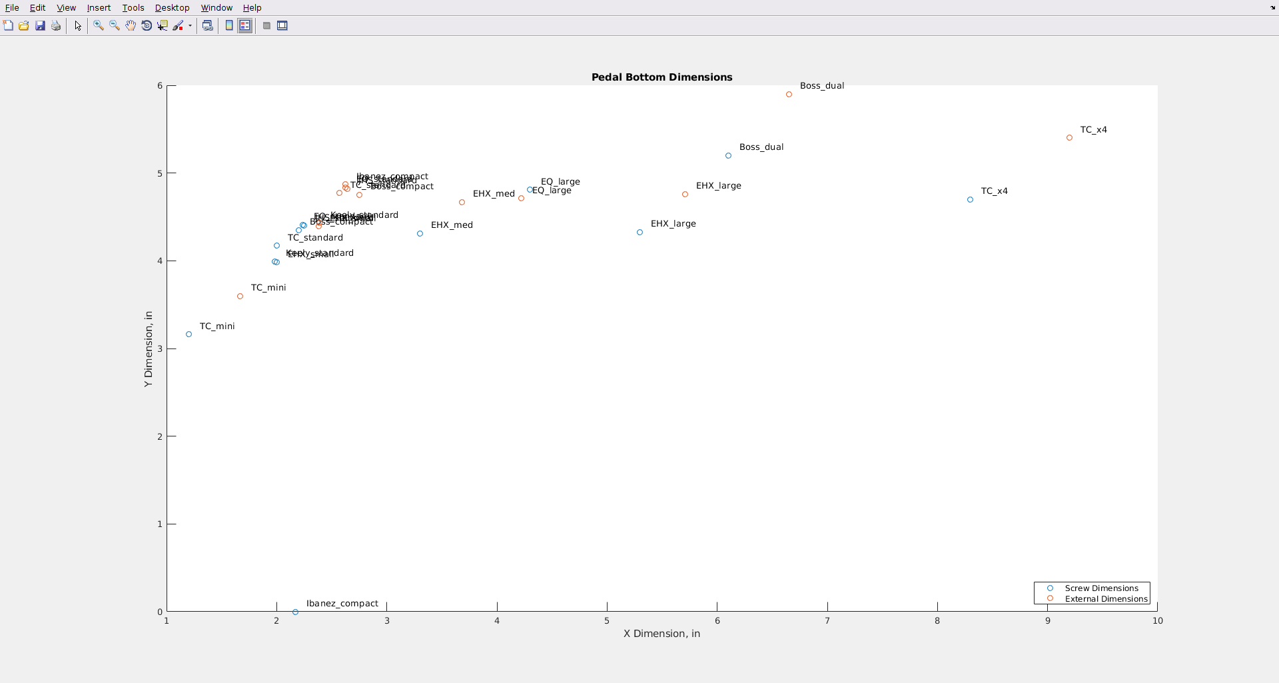
FinalReport/PR2Images/PedalDimensionsPlot.png
