NickPham01/ES100/FinalReport/PR2Images/PlatePCBstart.PNG

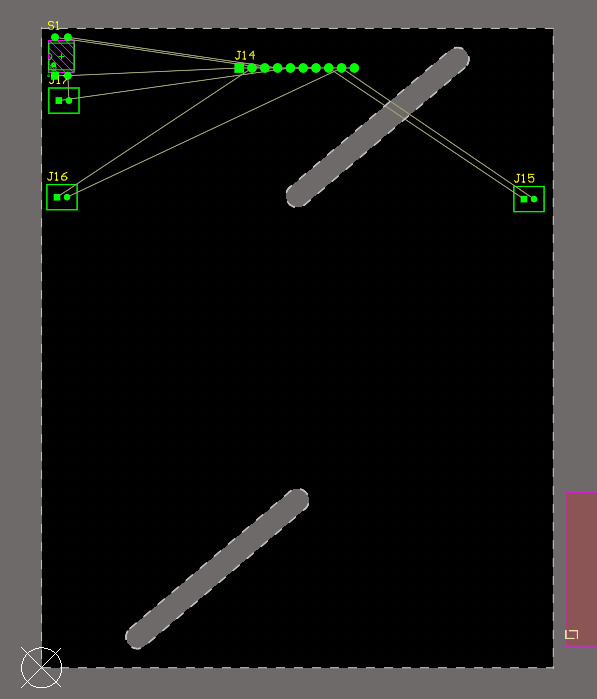
FinalReport/PR2Images/PlatePCBstart.PNG
