NickPham01/ES100/FinalReport/PR2Images/PlateSchematic.PNG

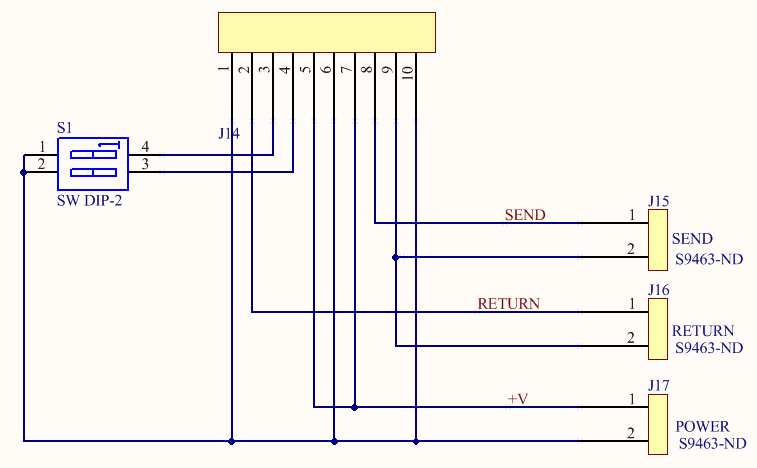
FinalReport/PR2Images/PlateSchematic.PNG
