NickPham01/ES100/FinalReport/PR2Images/PogoPinsAsm.PNG

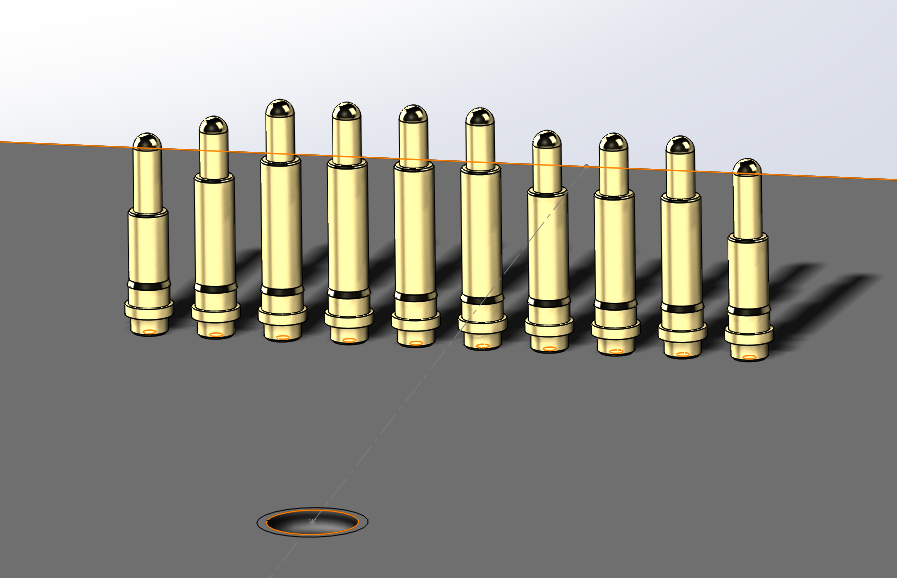
FinalReport/PR2Images/PogoPinsAsm.PNG
