NickPham01/ES100/FinalReport/PR2Images/ReceiverBlockDiagram.PNG

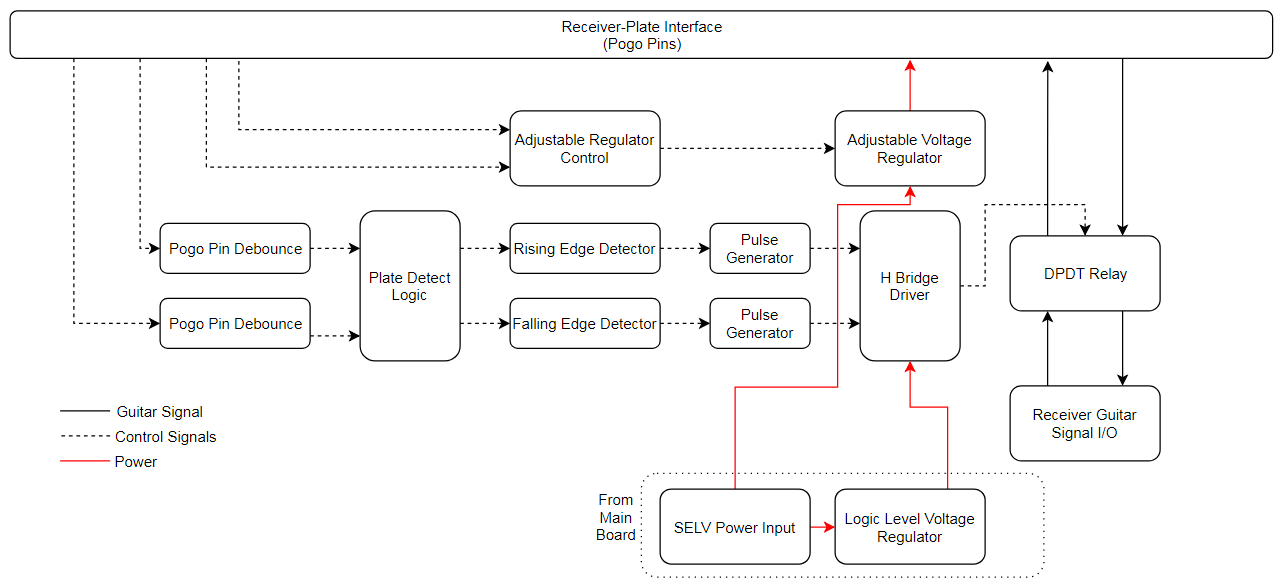
FinalReport/PR2Images/ReceiverBlockDiagram.PNG
