NickPham01/ES100/FinalReport/PR2Images/RevAScheme.png

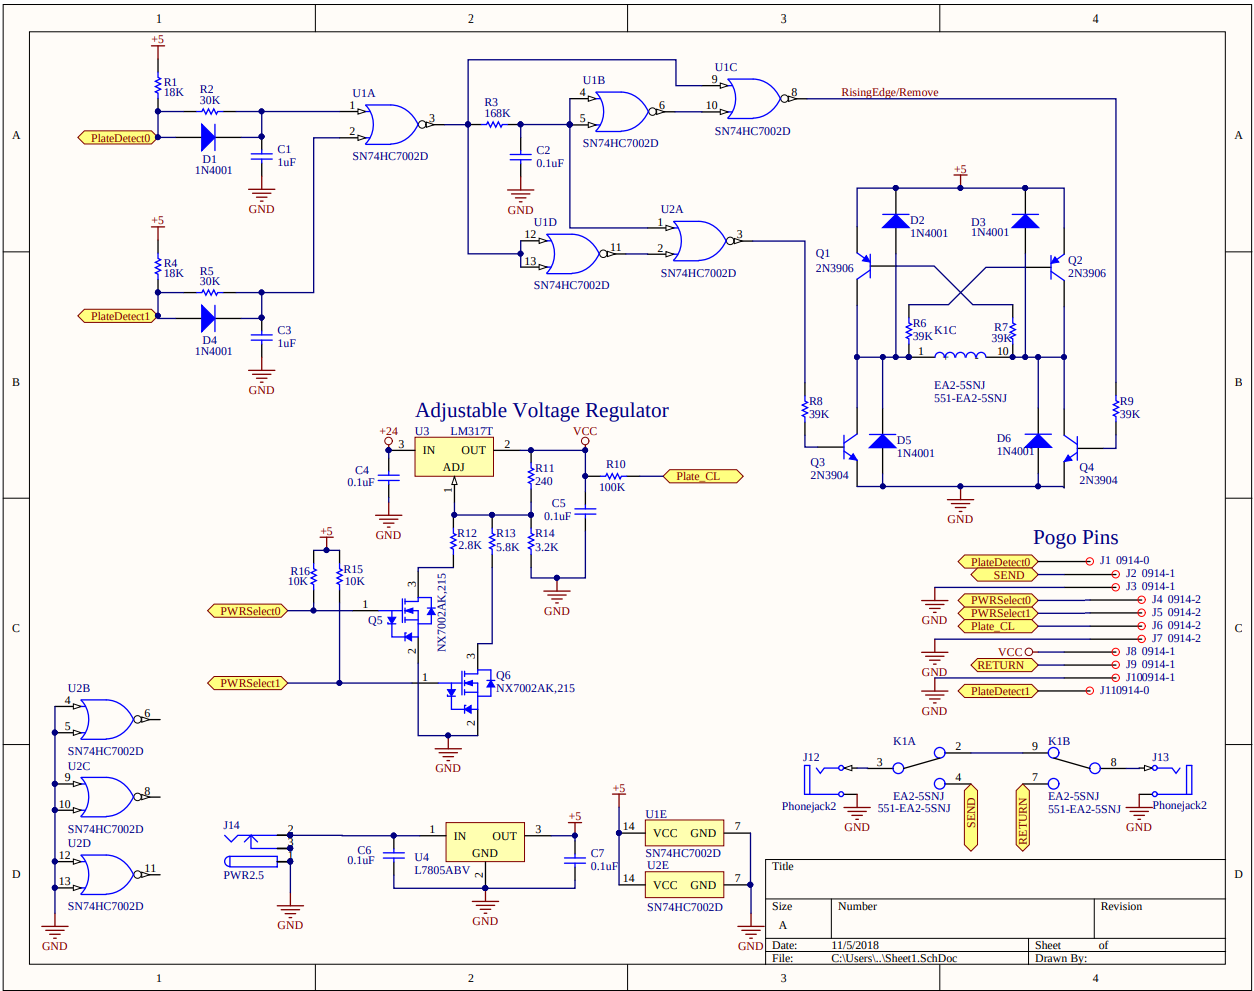
FinalReport/PR2Images/RevAScheme.png
