NickPham01/ES100/FinalReport/PR2Images/RevBSchematic.png

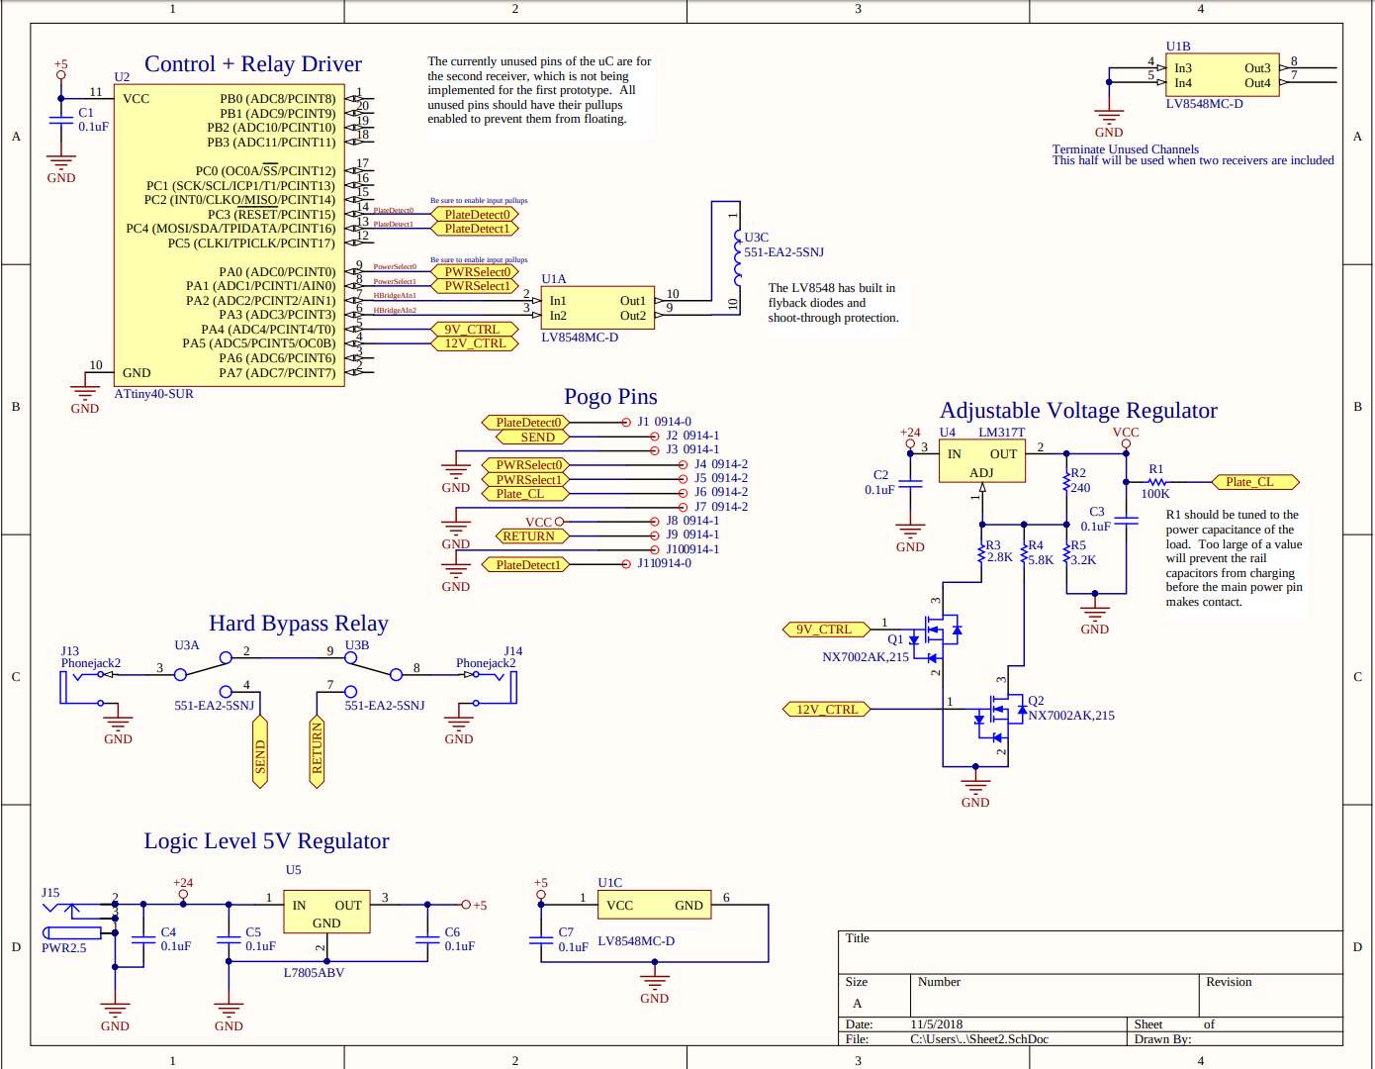
FinalReport/PR2Images/RevBSchematic.png
