NickPham01/ES100/FinalReport/PR2Images/SOIC10_footprint.PNG

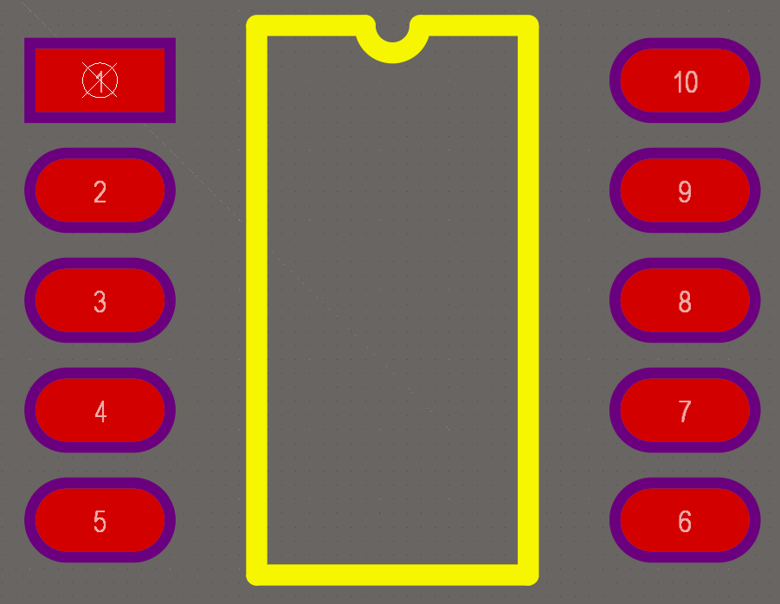
FinalReport/PR2Images/SOIC10_footprint.PNG
