NickPham01/ES100/FinalReport/PR2Images/SpringLoadedPogoPins_MM.jpg

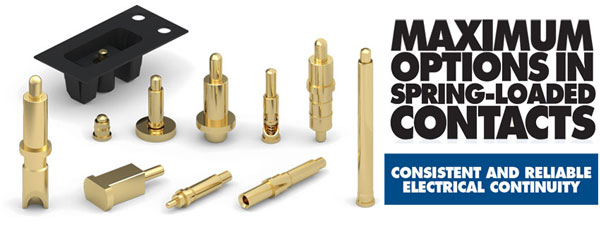
FinalReport/PR2Images/SpringLoadedPogoPins_MM.jpg
