NickPham01/ES100/FinalReport/PR4Images/HBridgeDriversRouting.PNG

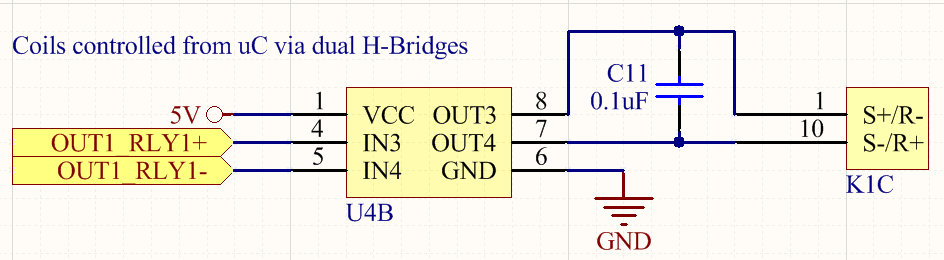
FinalReport/PR4Images/HBridgeDriversRouting.PNG
