NickPham01/ES100/FinalReport/PR4Images/MainSchem.PNG

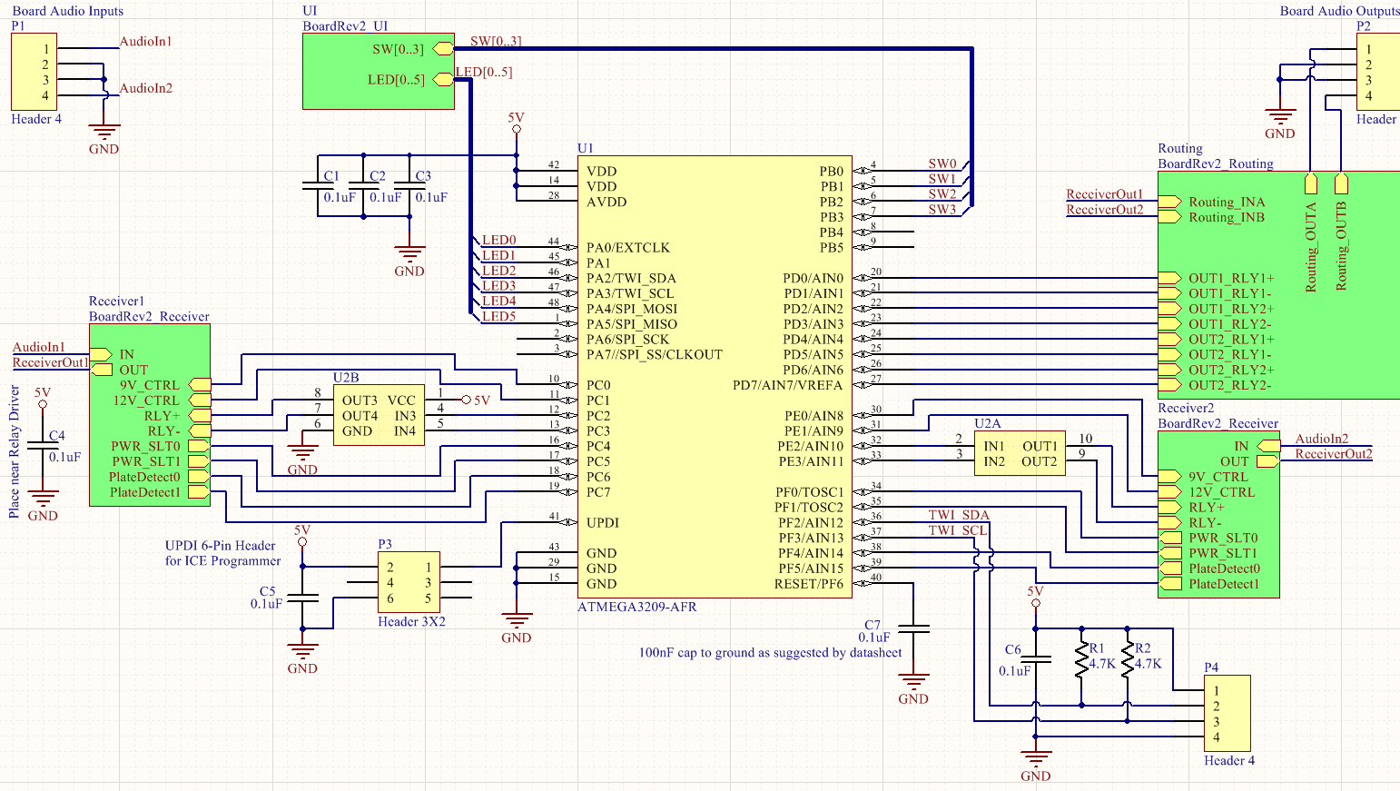
FinalReport/PR4Images/MainSchem.PNG
