NickPham01/ES100/FinalReport/PR5Images/MainBoard3D.png

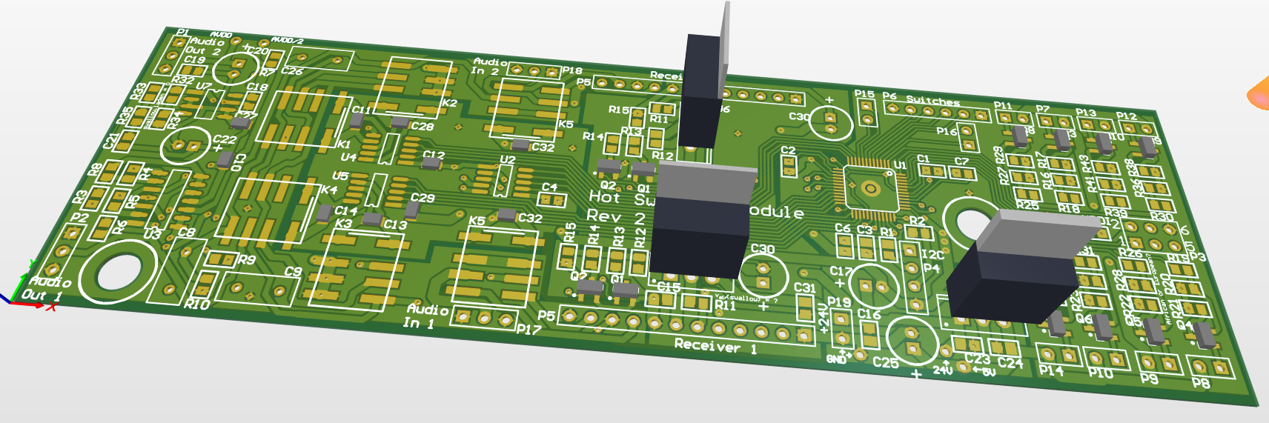
FinalReport/PR5Images/MainBoard3D.png
