NickPham01/ES100/FinalReport/PR5Images/OffBoard_UImain_PCB_3D.png

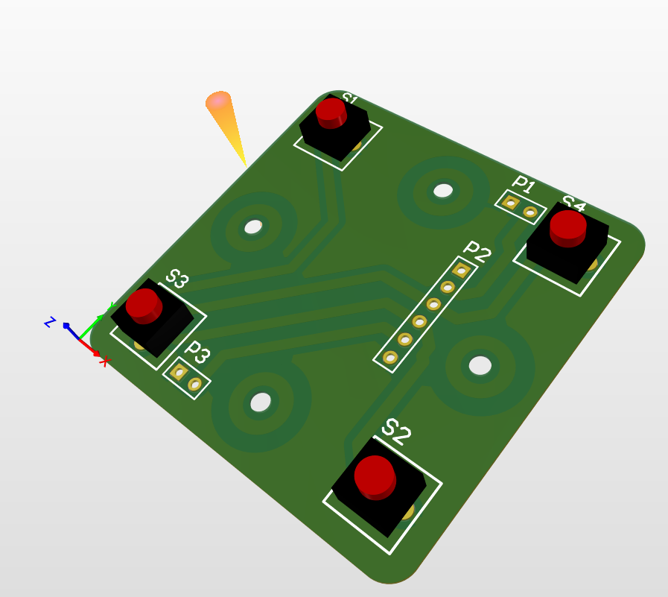
FinalReport/PR5Images/OffBoard_UImain_PCB_3D.png
