NickPham01/ES100/FinalReport/PR5Images/ReceiverBaseAsmCAD.png

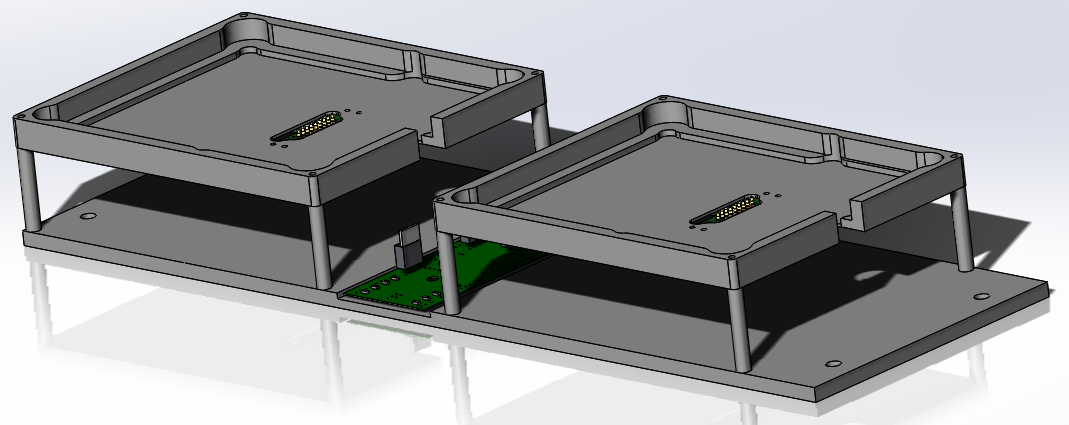
FinalReport/PR5Images/ReceiverBaseAsmCAD.png
