NickPham01/ES100/FinalReport/PR5Images/ReceiverBodyCAD.png

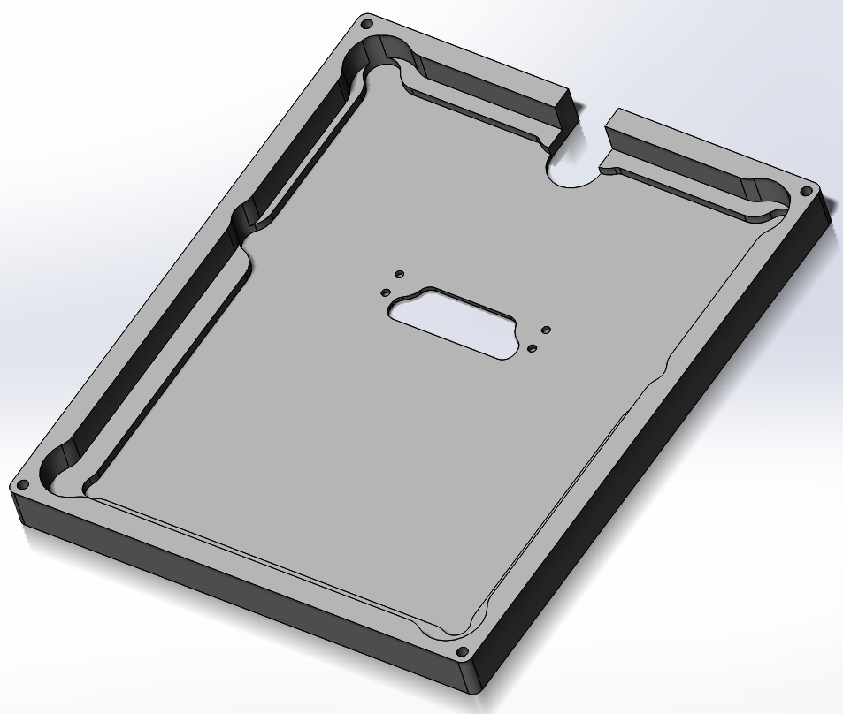
FinalReport/PR5Images/ReceiverBodyCAD.png
