NickPham01/ES100/FinalReport/PR5Images/UISWBoard.png

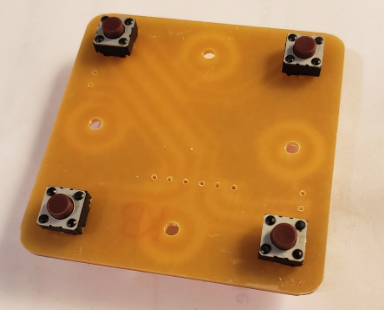
FinalReport/PR5Images/UISWBoard.png
