NickPham01/ES100/FirstPrototypeImages/PCB_3Dmodel.PNG

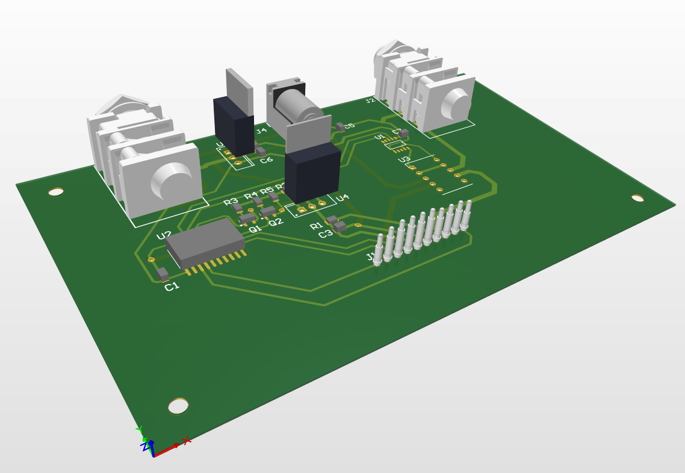
FirstPrototypeImages/PCB_3Dmodel.PNG
