NickPham01/ES100/FirstPrototypeImages/PCB_3Dmodel_20181127.PNG

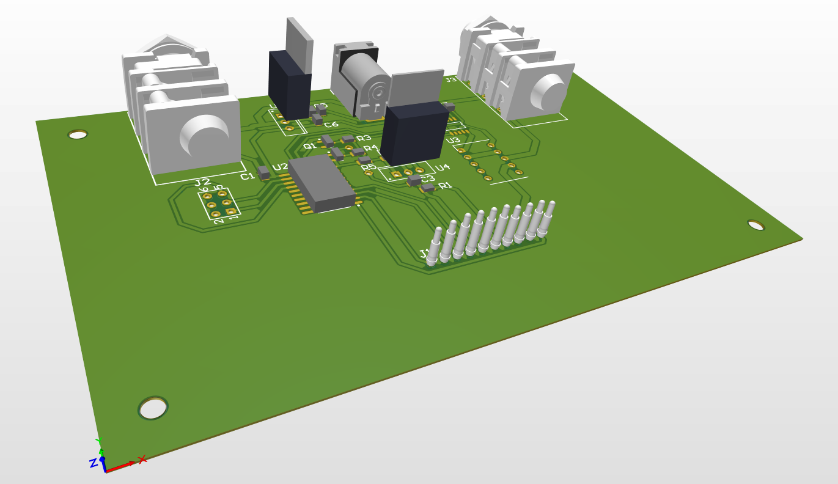
FirstPrototypeImages/PCB_3Dmodel_20181127.PNG
