NickPham01/ES100/FirstPrototypeImages/ReceiverSchematic_20181127.PNG

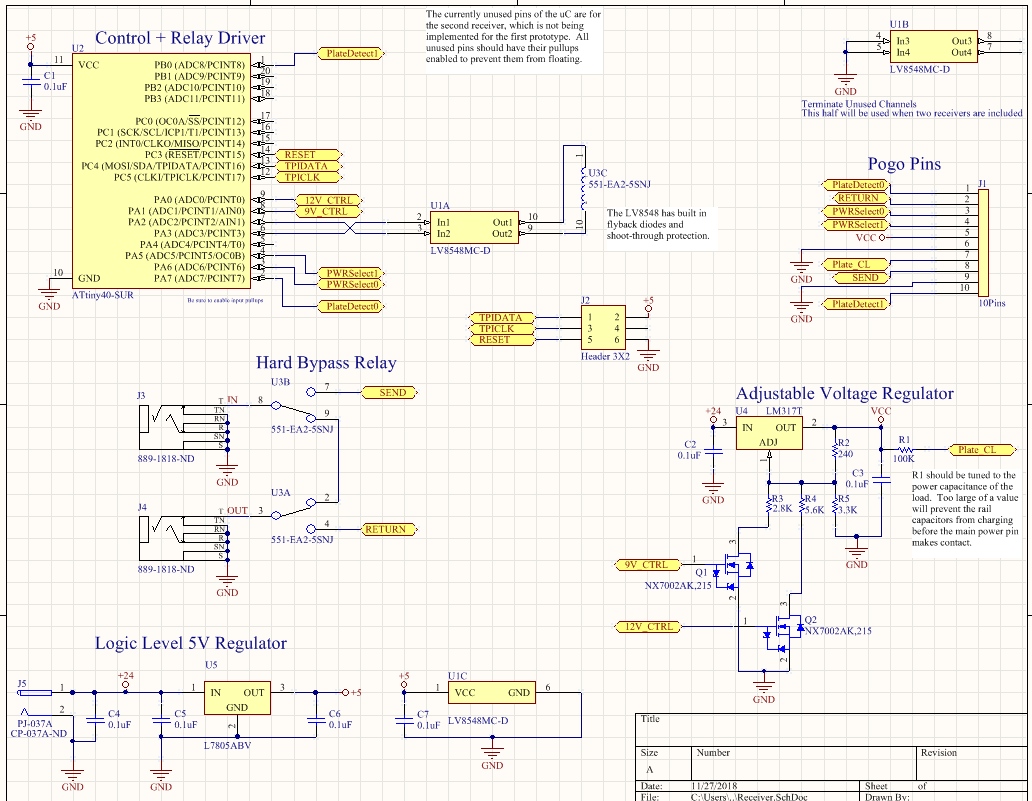
FirstPrototypeImages/ReceiverSchematic_20181127.PNG
