NickPham01/ES100/SectionPresentation11142018/PlatePCB.PNG

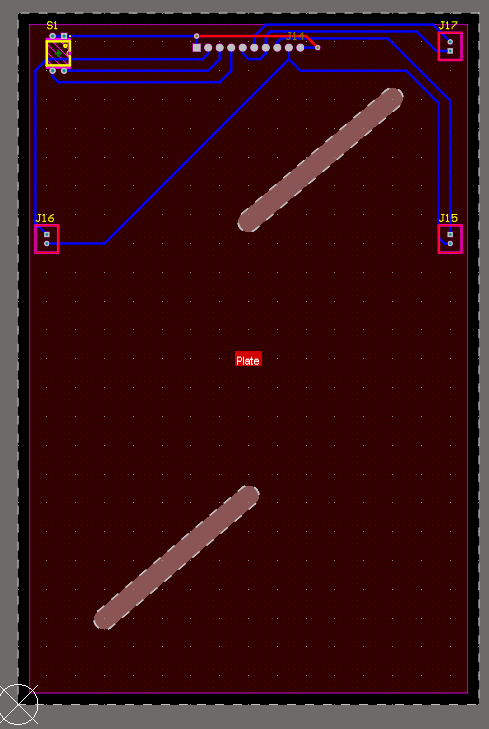
SectionPresentation11142018/PlatePCB.PNG
