NickPham01/ES100/SectionPresentation11142018/PlateSchem.PNG

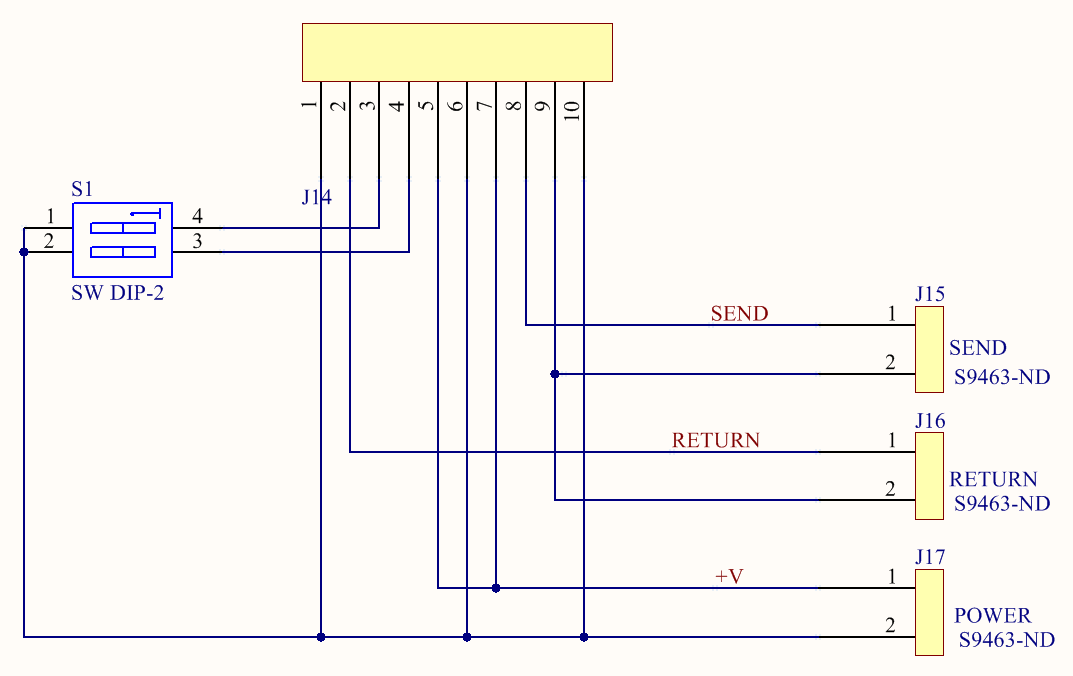
SectionPresentation11142018/PlateSchem.PNG
