NickPham01/ES100/SectionPresentation11142018/ReceiverPCB.PNG

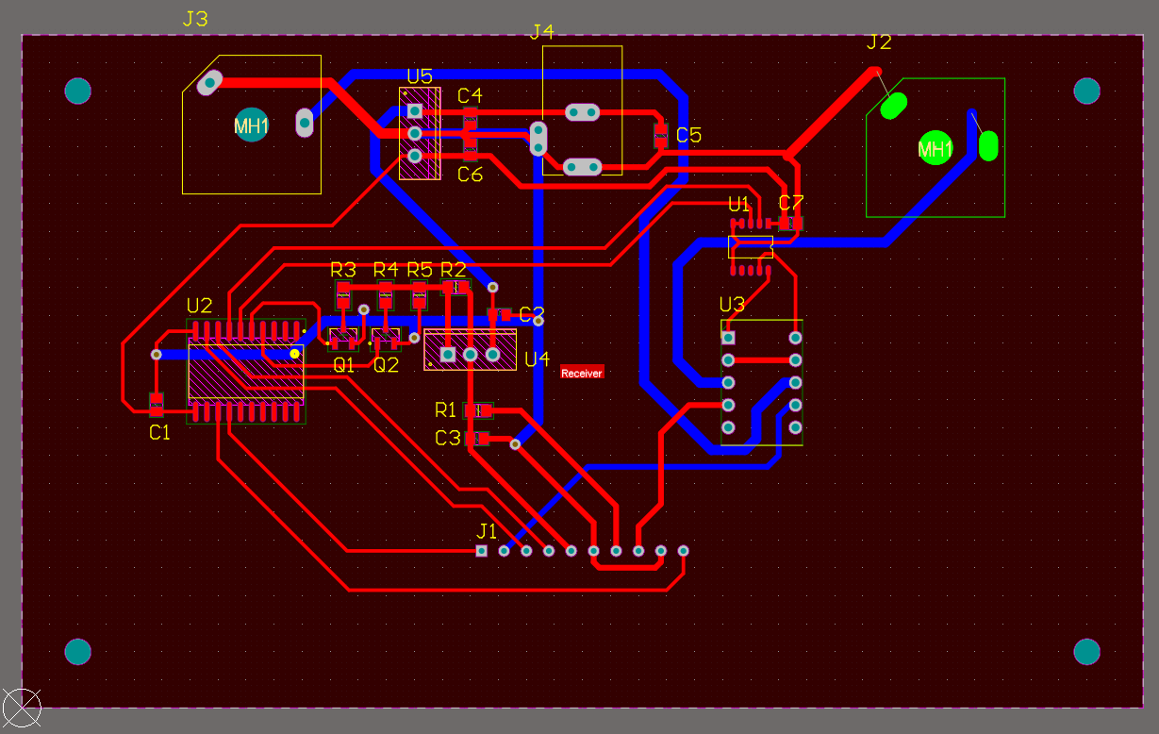
SectionPresentation11142018/ReceiverPCB.PNG
