NickPham01/ES100/SectionPresentation11142018/ReceiverSchem.PNG

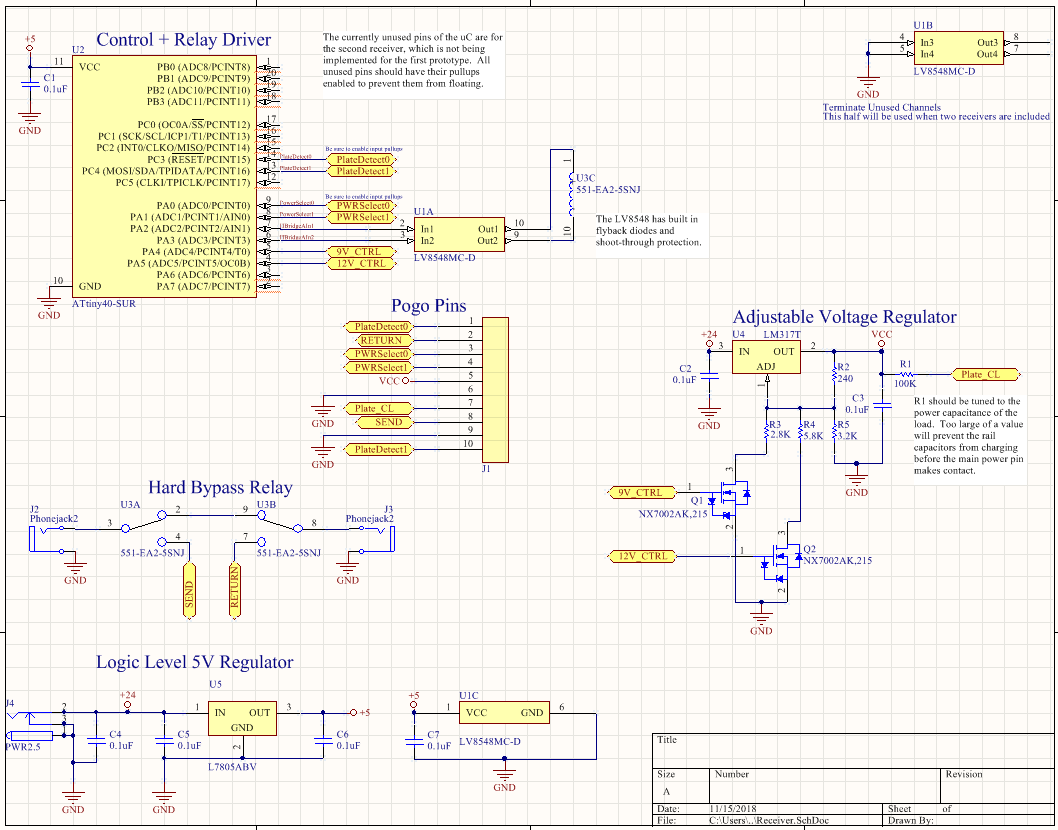
SectionPresentation11142018/ReceiverSchem.PNG
