NickPham01/ES100/StatsHW/html/StatsHW_01.png

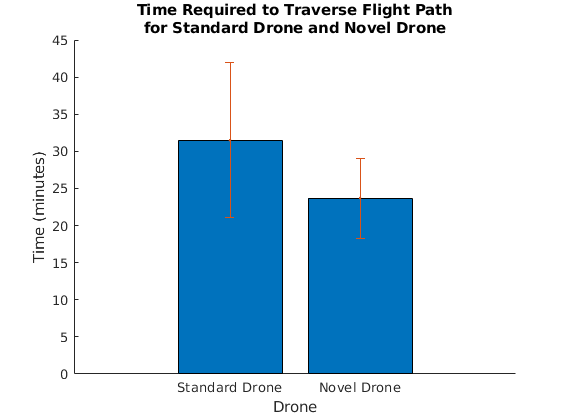
StatsHW/html/StatsHW_01.png
