NickPham01/ES100/ThesisRepresentativeImage.jpg

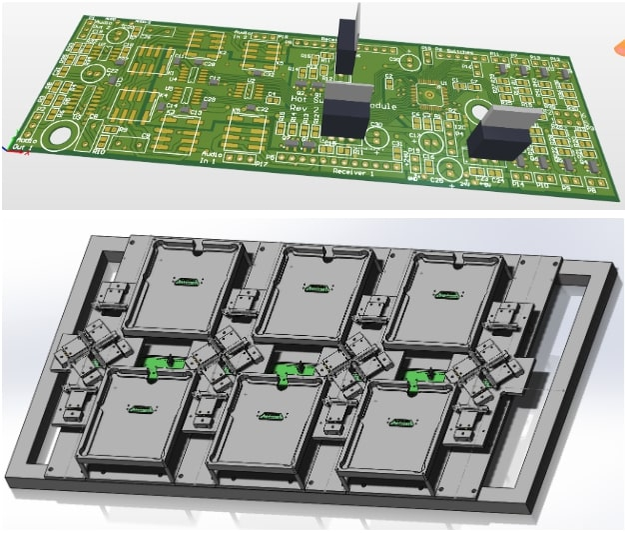
ThesisRepresentativeImage.jpg
