NickPham01/ES100/Update02042019/BoardV2_blockdiagram_wModuleHighlight.PNG

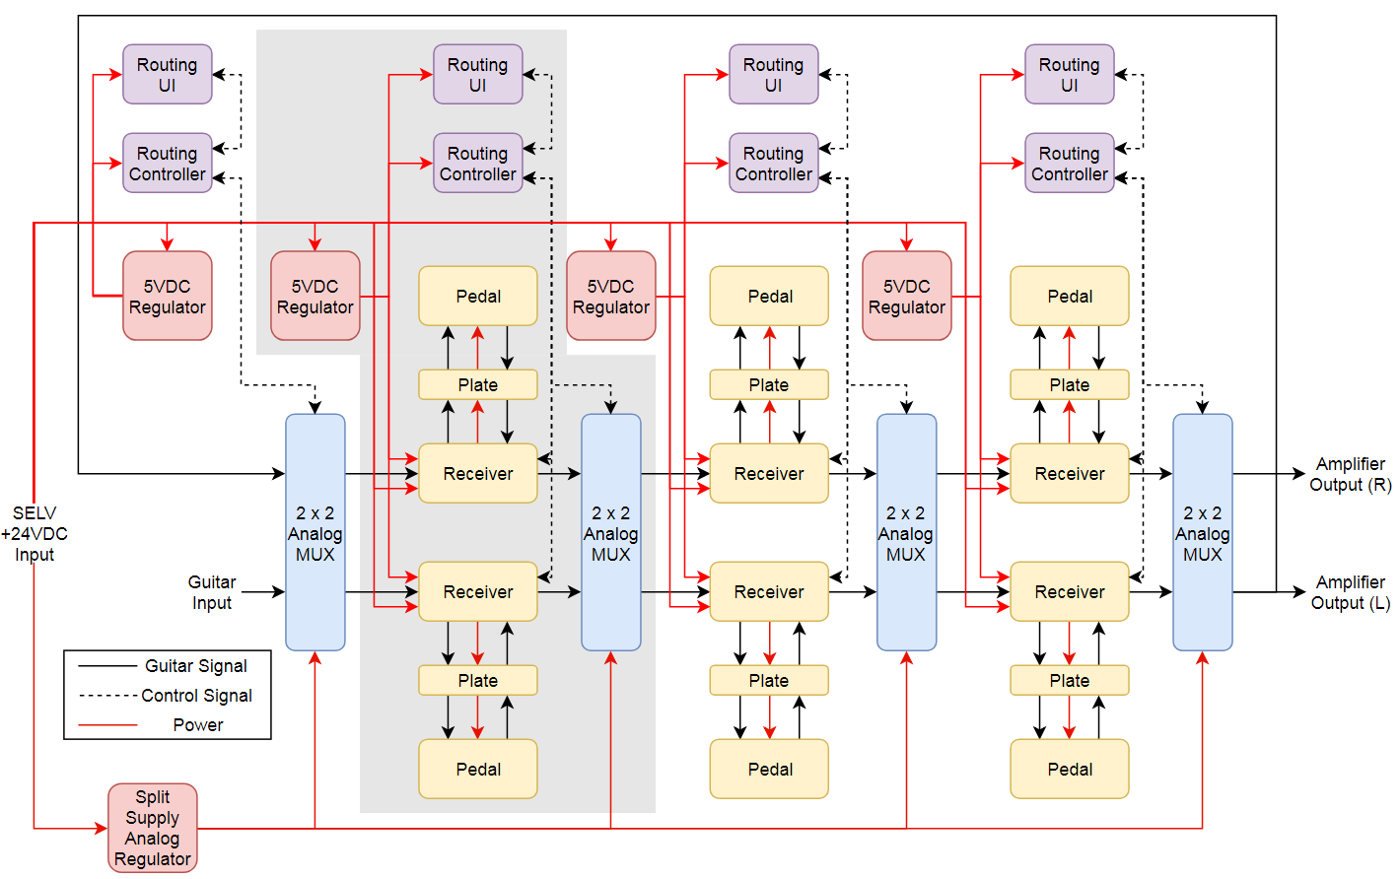
Update02042019/BoardV2_blockdiagram_wModuleHighlight.PNG
