NickPham01/ES100/Update02042019/BoardV2_preliminary layout.PNG

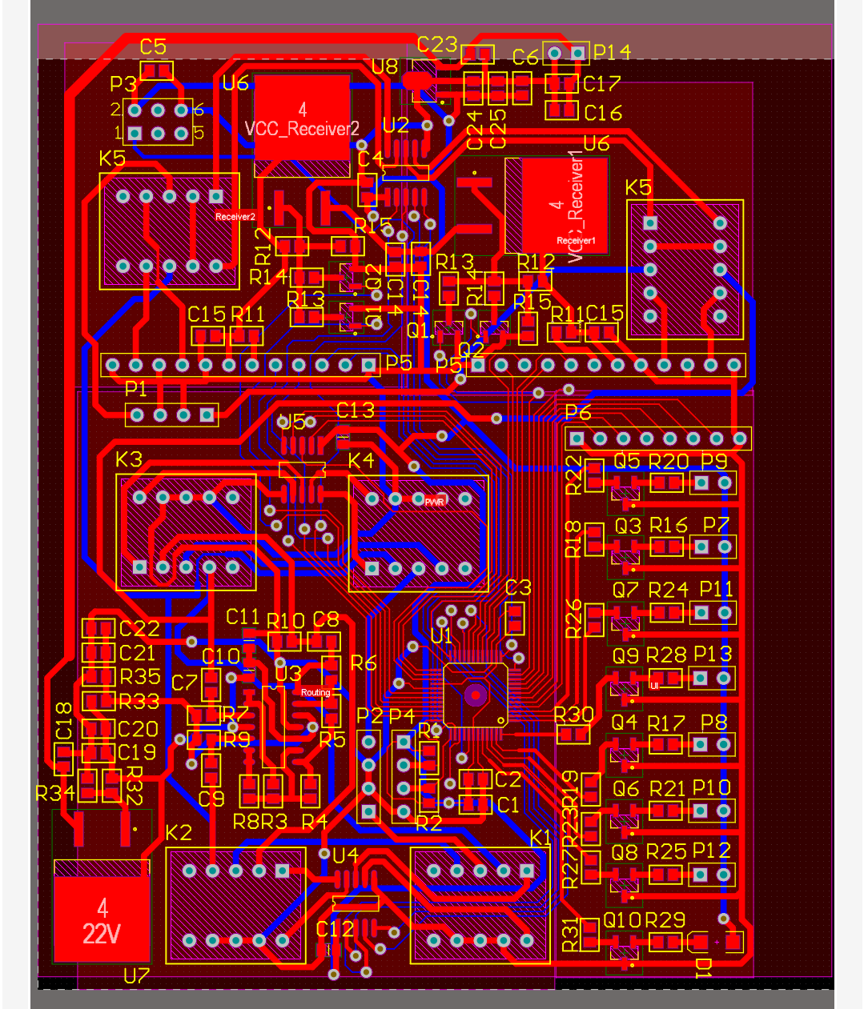
Update02042019/BoardV2_preliminary layout.PNG
