NickPham01/ES100/Update02042019/PlateFBD.PNG

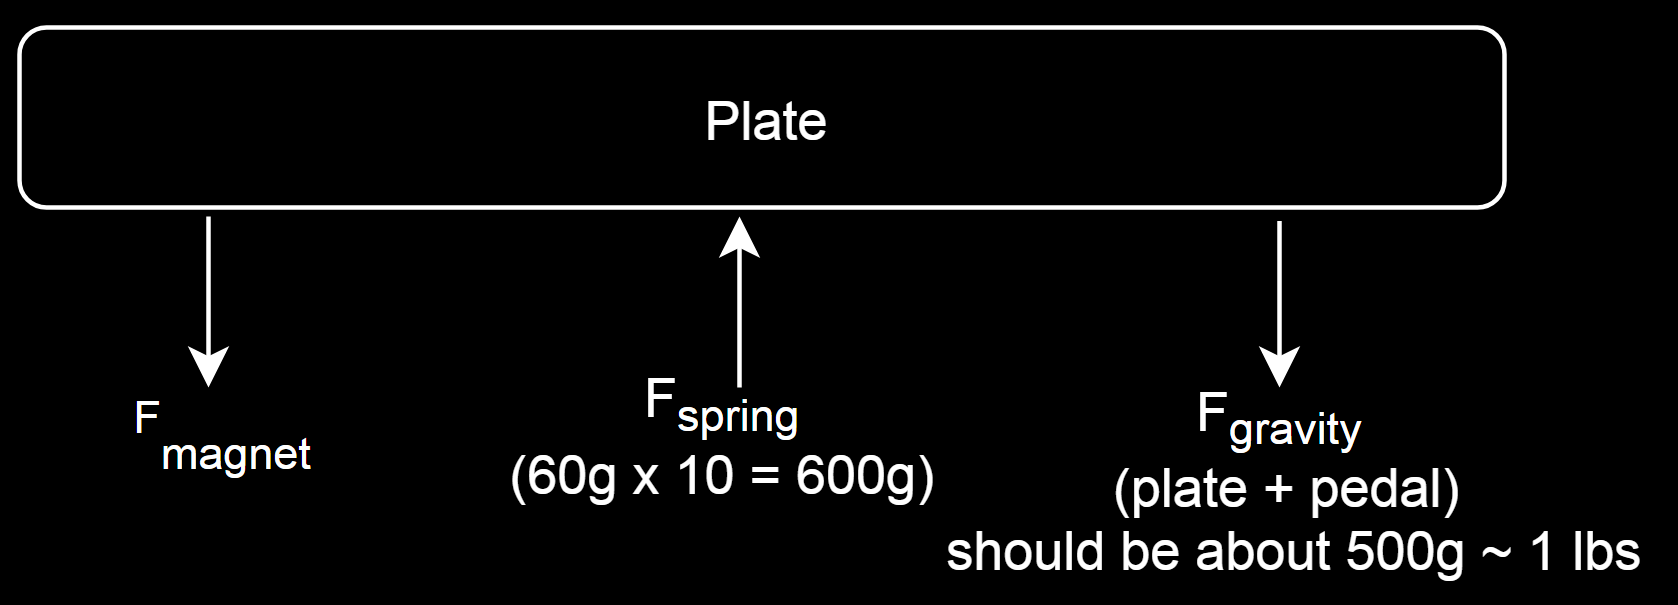
Update02042019/PlateFBD.PNG
