NickPham01/ES100/Update02042019/RoutingSchematic.PNG

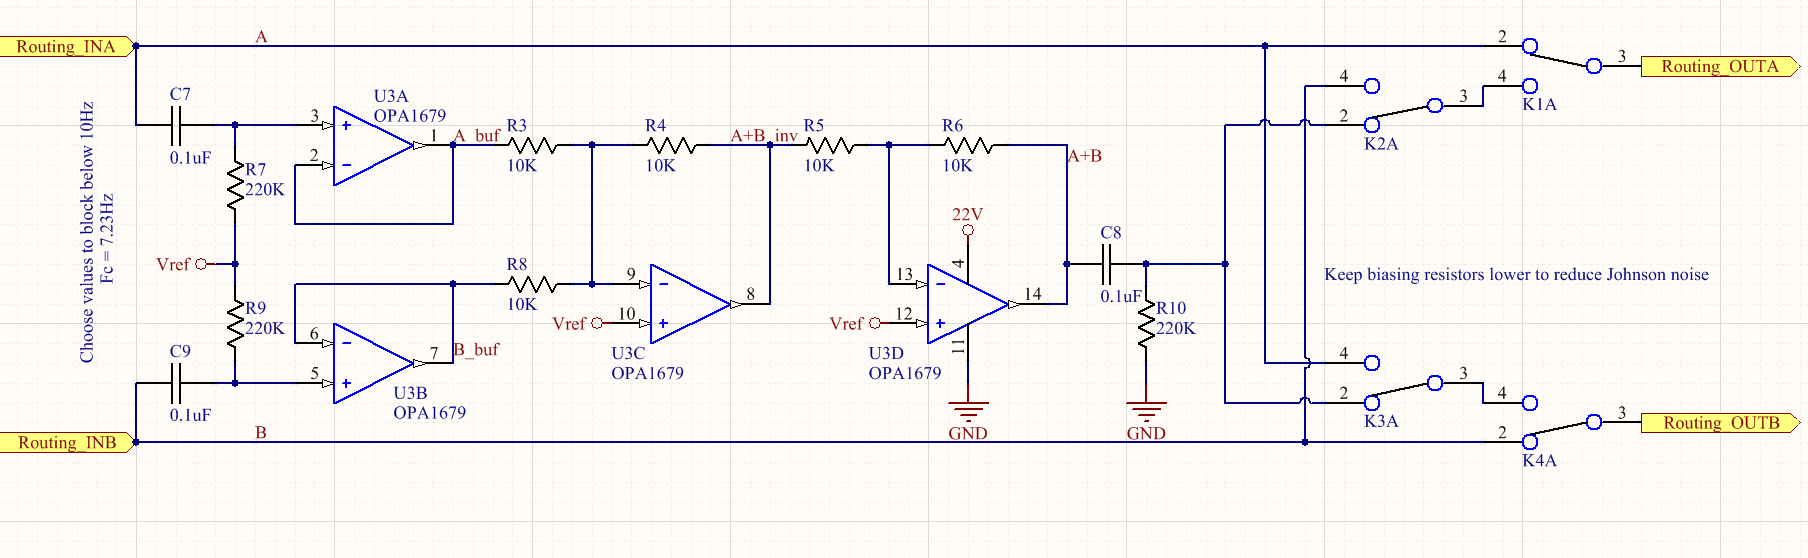
Update02042019/RoutingSchematic.PNG
