NickPham01/ES100/Update02042019/UpdatedSchedule.PNG

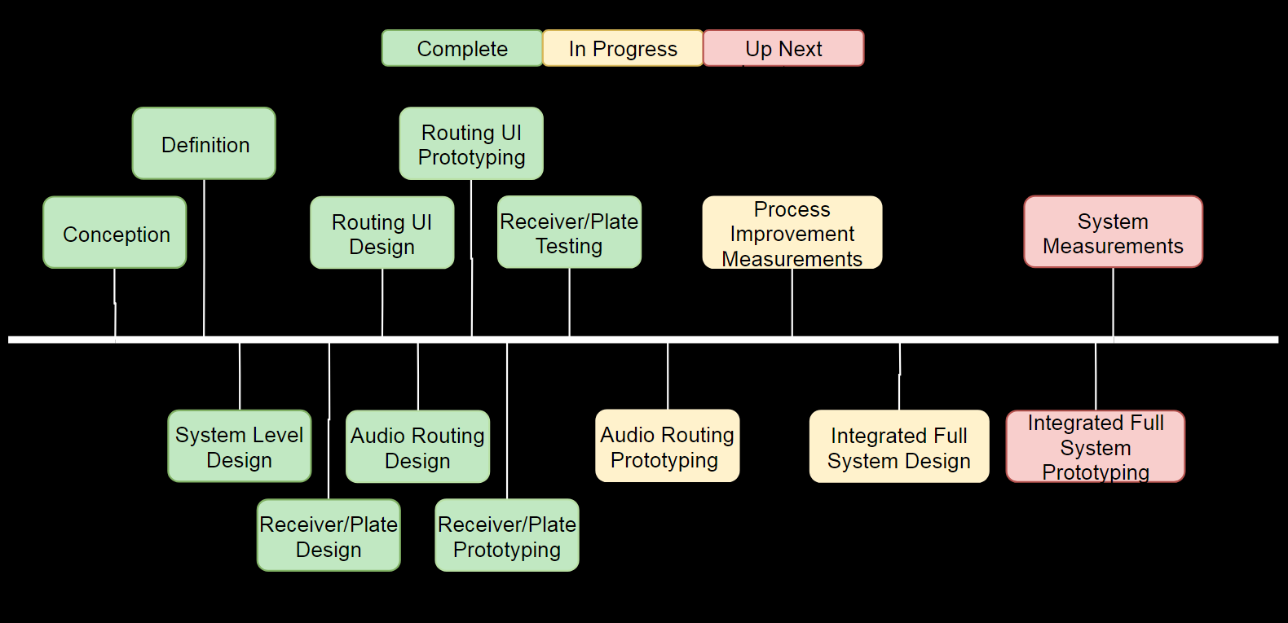
Update02042019/UpdatedSchedule.PNG
