NickPham01/ES100/Popular Guitar Pedals_ Characteristics.xlsx

Sheet: OnlineOfferings
Company | Product | Enclosure Size | Dimensions | Power Supply | Power Location | I/O | I/O Location
TC Electronic | Ditto Looper | 1590a |  | 9V 100ma standard | Right | Mono | Sides
TC Electronic | Hall of Fame Reverb |  | 72 x 122 x 50 mm – 2.8 x 4.8 x 2.0” |  | Top | Stereo | Sides
MXR | Carbon Copy
Note: It may be better to look at the most popular guitar pedal company in addition to the most popular effects (and see where these overlap)
One company will usually make pedals in only one or a handful of sizes
Company | Company Rank Reverb 2016/2017 | Size Name | Number of Products in Size | Example
Boss | 1 | "Compact" | 52 | DS-1
Boss | 1 | "Dual" | 4 | RC-30
Boss | 1 | "Trriple" | 3 | DD-500
EHX | 2 | "Medium" | 35 | B9
EHX | 2 | "Small" | 49 | Canyon
EHX | 2 | "Large" | 36 | POG2
TC | 3 | "Folded" | 26 | 3rd Dimension Chorus
TC | 3 | "Mini" | 13 | Ditto Looper
TC | 3 | "Standard" | 24 | Corona Chorus
TC | 3 | "x4" | 4 | Ditto x4 Looper
TC | 3 | "x2" | 2 | Ditto x2 Looper
MXR | 4 | "Standard" | 51 | Carbon Copy
MXR | 4 | "Large" | 20 | 10 Band EQ
Digitech | 2018-05-06 | "DOD Standard" | 10 | Phasor 201
Digitech | 2018-05-06 | "Folded" | 12 | Luxe

Sheet: DimensionData
Company | Category | Example_Name | X_external | Y_external | X_screw | Y_screw | Z_Jack | Y_Jack
Name |  | Name | inch, horizontal, L | inch, vertical, H | inch, horizontal, L | inch, horizontal, H | inch from bottom | inch from top
Boss | Boss_dual | RC30 | 6.65 | 5.9 | 6.1 | 5.2
Boss | Boss_compact | V0-1 | 2.75 | 4.75 | 2.2 | 4.35 | 1.15 | -2
TC | TC_mini | Polytune2 | 1.67 | 3.6 | 1.2 | 3.16 | 0.65 | -2.35
TC | TC_x4 | FlashbackX4 | 9.2 | 5.4 | 4.7 | 8.3 | 0.55 | TOP
TC | TC_standard | Flashback | 2.57 | 4.77 | 2 | 4.17 | 0.62 | -2.4, -3.1
Ibanez | Ibanez_compact | TS9 | 2.625 | 4.87 | 2.17 | NO LOWER | 1.275 | -2.15
Keely | Keely_standard | SuperPhatMod | 2.39 | 4.43 | 2.98 | 3.99 | 0.63 | -2.3
JHS | JHS_standard | PulpNPeel | 2.64 | 4.82 | 2.25 | 4.4 | 0.97 | -3.2
EarthQuaker | EQ_standard | DispatchMaster | 2.625 | 4.835 | 2.235 | 4.41 | 0.7 | TOP
EarthQuaker | EQ_large | AvalancheRun | 4.22 | 4.71 | 4.81 | 4.3 | 0.74 | TOP+SIDE
EHX | EHX_med | C9 | 3.68 | 4.6685 | 3.3 | 4.31 | 0.525 | -2.3, -3.02
EHX | EHX_small | HolyGrailNano | 2.38 | 4.39 | 2 | 3.98 | 0.4 | -2.2
EHX | EHX_large | StereoHazari | 5.71 | 4.76 | 5.3 | 4.325 | 0.62 | -2.37, -3.14

Sheet: GuitarCenterStock
Company | Product | Pedal Type
Seymour Duncan | Vapor Trail
Seymour Duncan | Palladium
Seymour Duncan | 805 Overdrive
Seymour Duncan | Andromeda
BBE | Soul Vibe
J Rockett | Blue Note
J Rockett | Archer
Tech 21 | FlyRig
Ampeg | SCR DI
MXR | Prime Distortion
MXR | Dyna Comp
MXR | Reverb
MXR | 10 Band EQ
MXR | Bass Overdrive
MXR | Phase 90
MXR | EVH Phase 90
MXR | Carbon Copy Deluxe
MXR | 5150 Overdrive
MXR | Super Badass Distortion
MXR | Analog Chrous
MXR | Custom Badass '78 Distortion
MXR | Il Diavolo Overdrive
MXR | Carbon Copy
MXR | Univibe
MXR | Bass Envelope Filter
MXR | Mini Phase 95
MXR | Mini Sugar Drive
Ampeg | Classic Analog Bass Preamp
Tech 21 | Sansamp
Korg | Pitchblack Tuner
Fulltone | Fulldrive 2
Fulltone | Fulldrive 3
ProCo | Rat
Fulltone | Supatone
Fulltone | Octafuzz
Fulltone | Plimsoul
Danelectro | Texas Trouble
Danelectro | CEO
Danelectro | Money Laundry
Fulltone | 2B
Digitech | Trio+
Digitech | Polara
Digitech | Obscura
Digitech | Whammy Ricochet
Digitech | Freqout
Digitech | JamMan Express
Digitech | Whammy
Boss | DD-500
Boss | RV-500
Boss | MD-500
Boss | RE-20
Boss | RC-30
Eventide | H9
Way Huge | Swollen Pickle
Way Huge | Green Rhino
Egnater | Goldsmith
Line6 | M5
Fender | Marine Layer Reverb
Fender | Mirror Image Delay
Fender | Pugilist Distortion
Voodoo Lab | Sparkle Drive Mod
EHX | Superego
EHX | Pitchfork
EHX | Nano Small Stone
EHX | Neo Clone
EHX | Oceans 11
EHX | Bassballs
EHX | Soul Food
EHX | Holy Grail Nano
EHX | Canyon
EHX | Nano Bass Big Muff Pi
EHX | Memory Toy
EHX | Big Muff Pi with Tone Wicker
EHX | Freeze
EHX | Holy Grail Max
EHX | Micro POG
EHX | Bass Big Muff
EHX | C9
EHX | Mel9
EHX | Synth9
EHX | Big Muff
EHX | Cathedral
EHX | Stereo Memory Man with Hazarai
EHX | Ravish Sitar
EHX | Bass Microsynth
EHX | Deluxe Bass Big Muff
EHX | 45000 Looper
Ibanez | Analog Delay Mini
Ibanez | Chorus Mini
Ibanez | Tube Screamer Mini
Ibanez | TS9
Maxon | OD808
Ibanez | TS808
Boss | Angry Driver
Boss | SD-1
Boss | VB-2
Boss | BD-2
Boss | CE-2
Boss | DM-2
Boss | RC-1
Boss | RC-3
Boss | OC-3
Boss | HR-2
Boss | DD-3
Boss | DD-7
Boss | CE-5
Boss | CH-1
Boss | NS-2
Boss | PH-3
Boss | RV-6
Boss | BD-2
Boss | VO-1
Boss | OS-2
Boss | MT-2
Boss | DS-1
Boss | SD-1
Boss | AW-3
Boss | AC-3
Boss | CS-3
Boss | TU-3
Boss | BB-1X
EarthQuaker | Pallisades
EarthQuaker | Pyramids
EarthQuaker | Bit Commander
EarthQuaker | Dispatch Master
EarthQuaker | Avalanche Run
EarthQuaker | Spatial Delivery
EarthQuaker | Afterneath
EarthQuaker | Hoof
JHS | Pulp 'N Peel
JHS | Angry Charlie
JHS | VCR
JHS | Morning Glory
Keeley | Super Phat Mod
Keeley | 30ms Automatic Double Tracker
Keeley | Darkside
Keeley | Tone Workstation
Keeley | Mag Echo
TC | Sentry
TC | Corona
TC | Viscous Vibe
TC | Hall of Fame 2
TC | Helix
TC | Flashback
TC | Polytune 2
TC | Body Rez
TC | Flashback X4
TC | Polytune 3
TC | Ditto
TC | Ditto X4
TC | Wiretap
