NickPham01/ES100/PlatePrototype/10PogoPinsPart.SLDASM

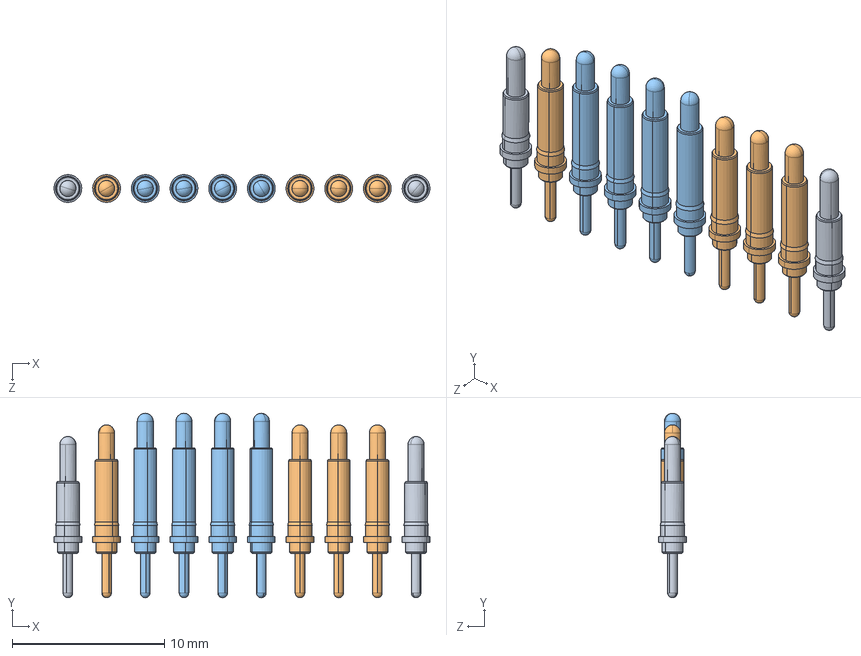
[picture p131: CAD file, 2019-01-25]
PlatePrototype/10PogoPinsPart.SLDASM
24.7 x 12.1 x 1.83 mm
mill-max-0914-0-15-20-77-14-11-0_MillMaxsldprt20180914.27420uGoldoverNickelPage25on.STEP x 2
mill-max-0914-1-15-20-77-14-11-0_MillMaxsldprt20180914.30420uGoldoverNickelPage25on.STEP x 4
mill-max-0914-2-15-20-77-14-11-0_MillMaxsldprt20180914.33420uGoldoverNickelPage25on.STEP x 4
