NickPham01/ES100/PlatePrototype/ReceiverPlate_asm.SLDASM

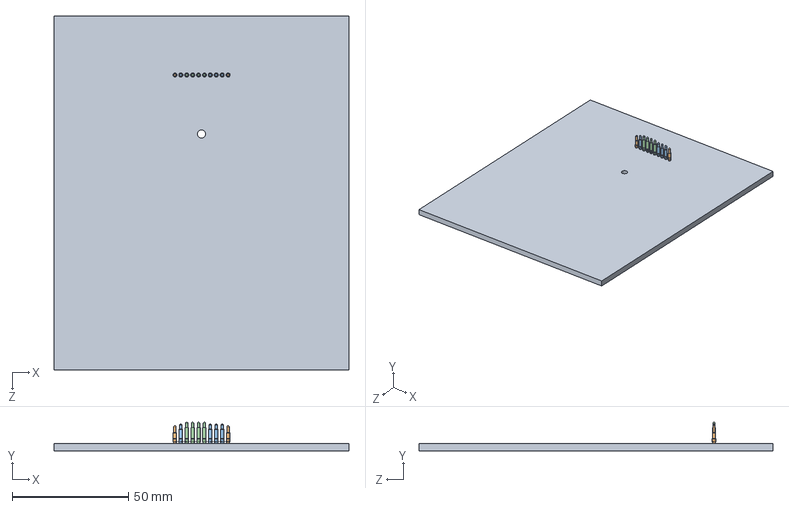
[picture p132: CAD file, 2019-01-25]
PlatePrototype/ReceiverPlate_asm.SLDASM
127.0 x 12.4 x 152.4 mm
ReceiverPCB
mill-max-0914-0-15-20-77-14-11-0 x 2
mill-max-0914-1-15-20-77-14-11-0 x 4
mill-max-0914-2-15-20-77-14-11-0 x 4
