NickPham01/ES100/PlatePrototype/PlatePrototype_small2_asm.SLDASM

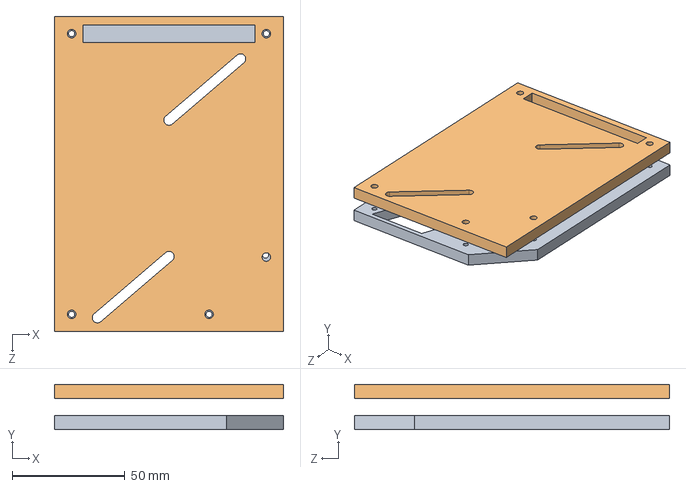
[picture p133: CAD file, 2018-11-03]
PlatePrototype/PlatePrototype_small2_asm.SLDASM
101.6 x 20.0 x 139.7 mm
PlatePrototype_small2bottom
PlatePrototype_small2top
