NickPham01/ES100/PlatePrototype/PedalFootprints/TCx4.SLDPRT

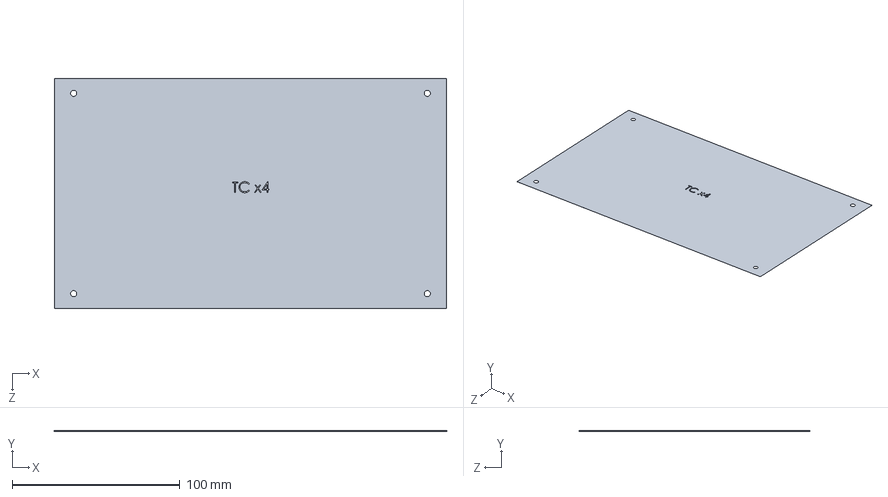
[picture p134: CAD file, 2018-11-03]
PlatePrototype/PedalFootprints/TCx4.SLDPRT
233.7 x 0.00254 x 137.2 mm
