NickPham01/ES100/RC22CS-N.SLDPRT

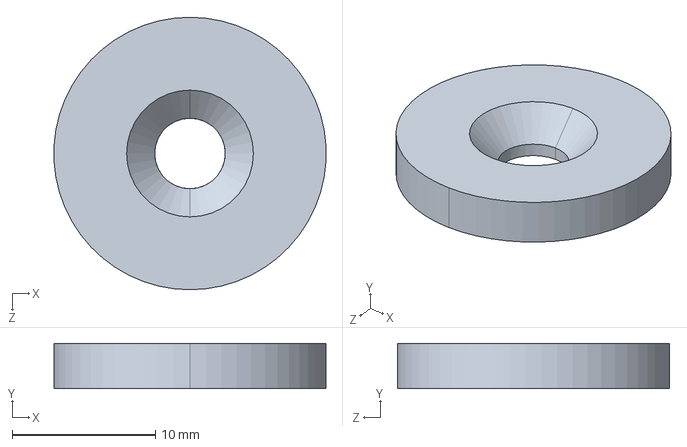
[picture p135: CAD file, 2019-01-25]
RC22CS-N.SLDPRT
19.0 x 3.17 x 19.1 mm
