NickPham01/ES100/PlatePrototype/PedalFootprints/JHSStandard.SLDPRT

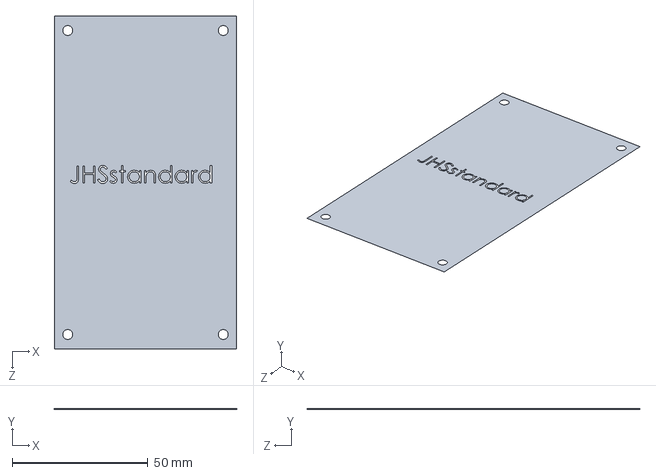
[picture p136: CAD file, 2018-11-03]
PlatePrototype/PedalFootprints/JHSStandard.SLDPRT
67.1 x 0.00254 x 122.4 mm
