NickPham01/ES100/TCMini.SLDPRT

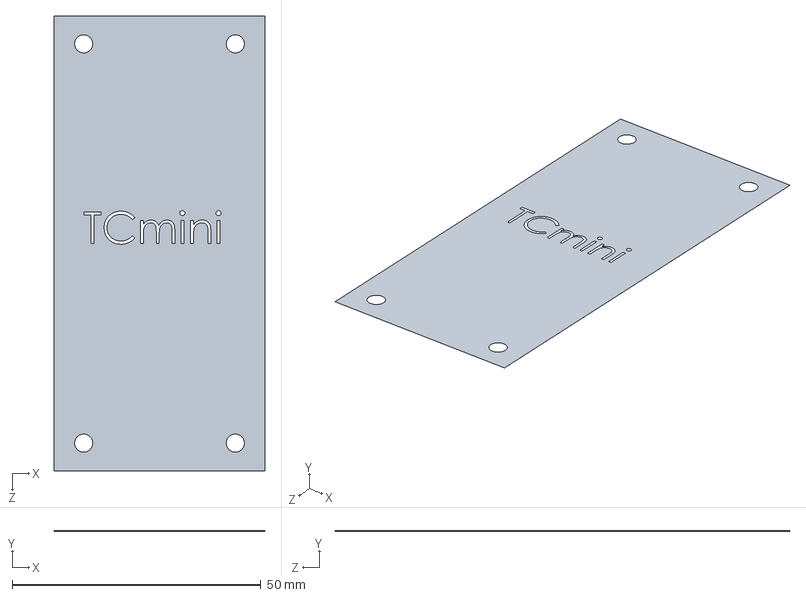
[picture p137: CAD file, 2018-11-03]
TCMini.SLDPRT
42.4 x 0.00254 x 91.4 mm
