NickPham01/ES100/PlatePrototype/PedalFootprints/EHXMed.SLDPRT

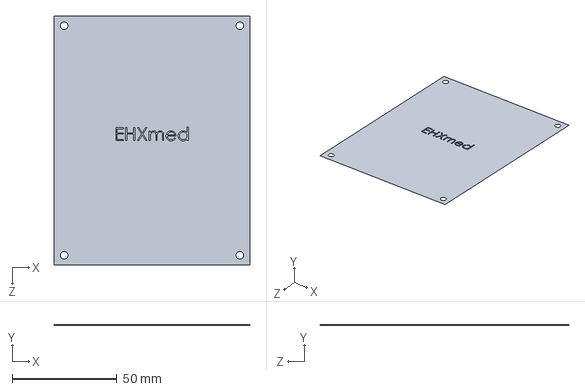
[picture p138: CAD file, 2018-11-03]
PlatePrototype/PedalFootprints/EHXMed.SLDPRT
93.5 x 0.00254 x 118.6 mm
