NickPham01/ES100/PlatePrototype/PlatePrototype_PCBshape_rev01.STEP

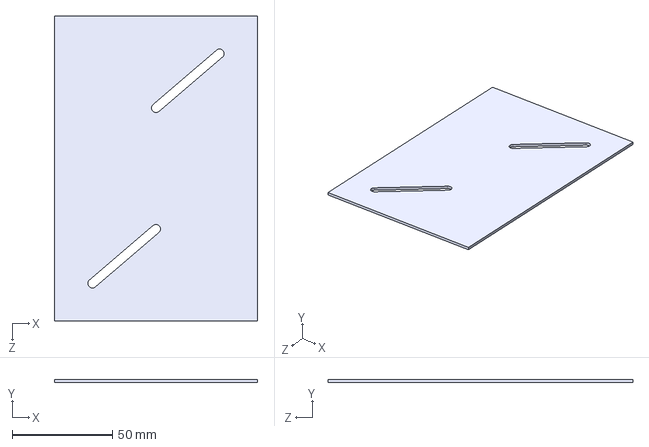
[picture p139: CAD file, 2019-01-25]
PlatePrototype/PlatePrototype_PCBshape_rev01.STEP
101.6 x 1.59 x 152.4 mm
