NickPham01/ES100/TCStandard.SLDPRT

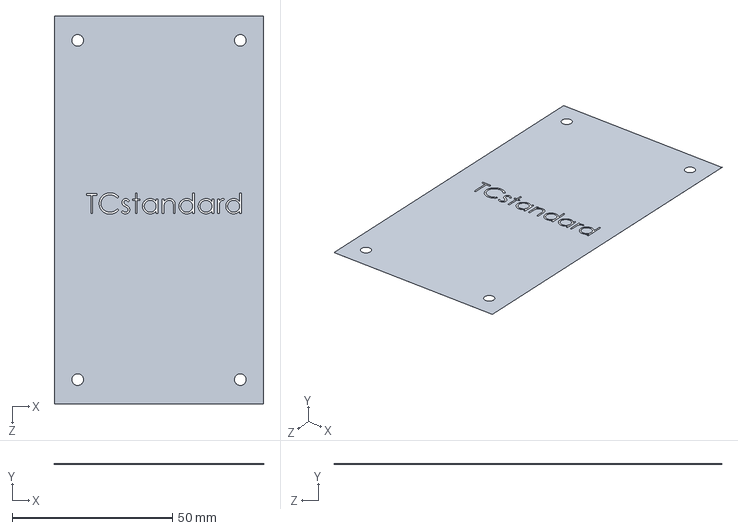
[picture p140: CAD file, 2018-11-03]
TCStandard.SLDPRT
65.3 x 0.00254 x 121.2 mm
