NickPham01/ES100/PlatePrototype/ACJS-MHOM.stp

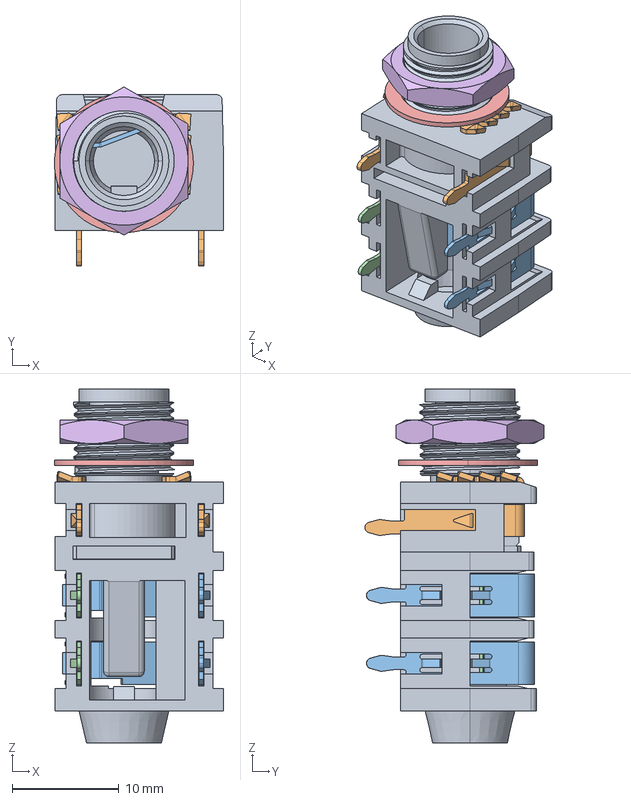
[picture p141: CAD file, 2019-01-25]
PlatePrototype/ACJS-MHOM.stp
15.8 x 16.7 x 33.1 mm
House
DONG x 2
JING x 2
sleeve
PJ-629 FLAT WASHER
PJ-629 BIG NUT
