NickPham01/ES100/PlatePrototype/PedalFootprints/EHXLarge.SLDPRT

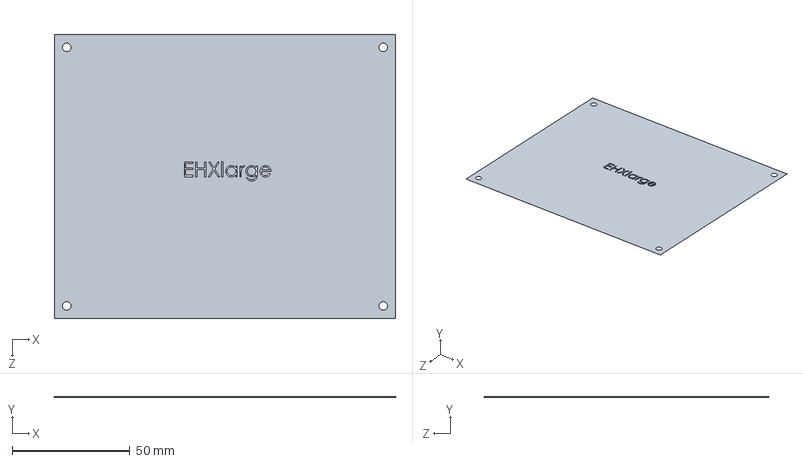
[picture p142: CAD file, 2018-11-03]
PlatePrototype/PedalFootprints/EHXLarge.SLDPRT
145.0 x 0.00254 x 120.9 mm
