NickPham01/ES100/PlatePrototype/PedalFootprints/BossDual.SLDPRT

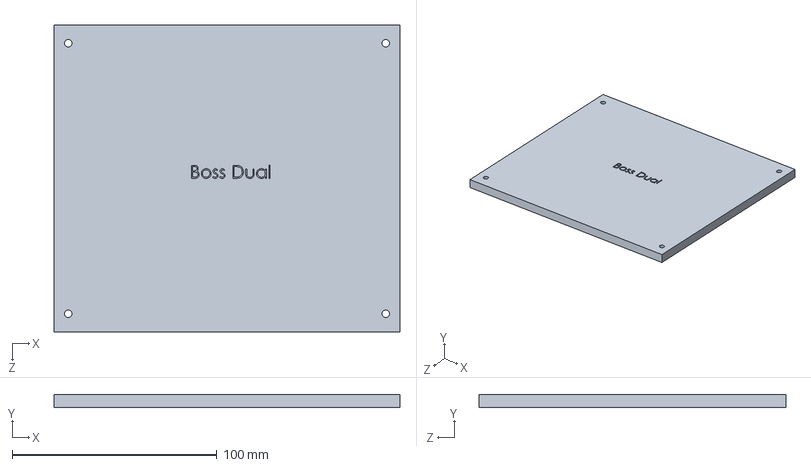
[picture p143: CAD file, 2018-11-03]
PlatePrototype/PedalFootprints/BossDual.SLDPRT
168.9 x 6.35 x 149.9 mm
