NickPham01/ES100/PlatePrototype/ReceiverBottomWall.SLDPRT

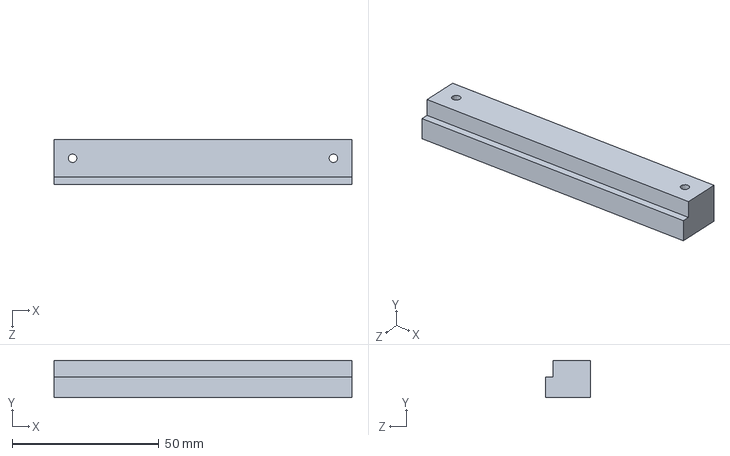
[picture p144: CAD file, 2019-01-25]
PlatePrototype/ReceiverBottomWall.SLDPRT
101.6 x 12.7 x 15.2 mm
