NickPham01/ES100/PlatePrototype/PedalFootprints/KeeleyStandard.SLDPRT

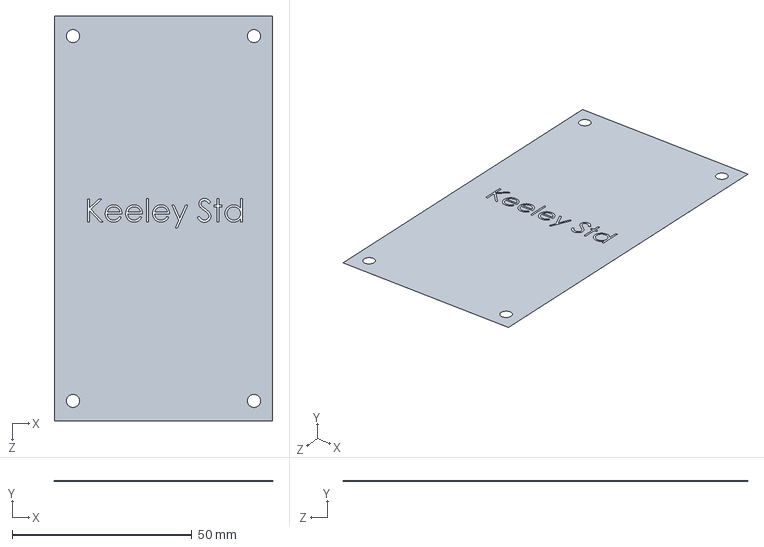
[picture p145: CAD file, 2018-11-03]
PlatePrototype/PedalFootprints/KeeleyStandard.SLDPRT
60.7 x 0.00254 x 112.5 mm
