NickPham01/ES100/PlatePrototype/ReceiverPCBPlateSeat.SLDPRT

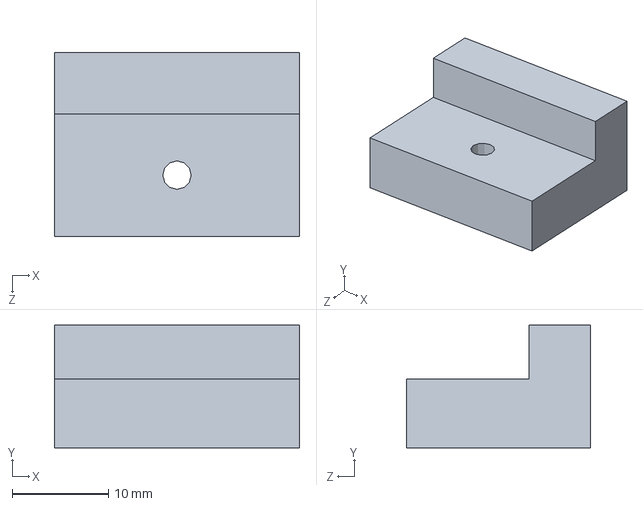
[picture p146: CAD file, 2019-01-25]
PlatePrototype/ReceiverPCBPlateSeat.SLDPRT
25.4 x 12.7 x 19.1 mm
