NickPham01/ES100/PlatePrototype/PedalFootprints/BossCompact.SLDPRT

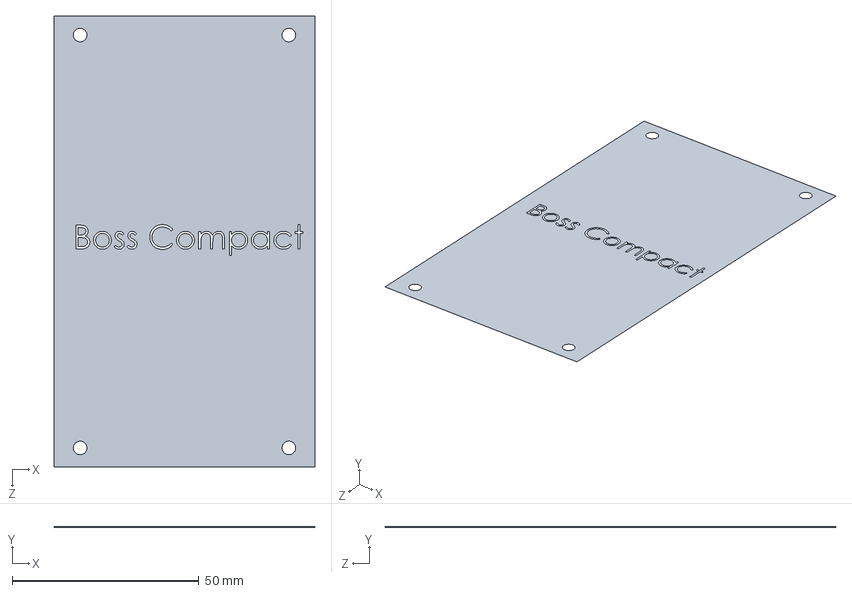
[picture p147: CAD file, 2018-11-03]
PlatePrototype/PedalFootprints/BossCompact.SLDPRT
69.8 x 0.00254 x 120.7 mm
