NickPham01/ES100/PlatePrototype/RecieverBase.SLDPRT

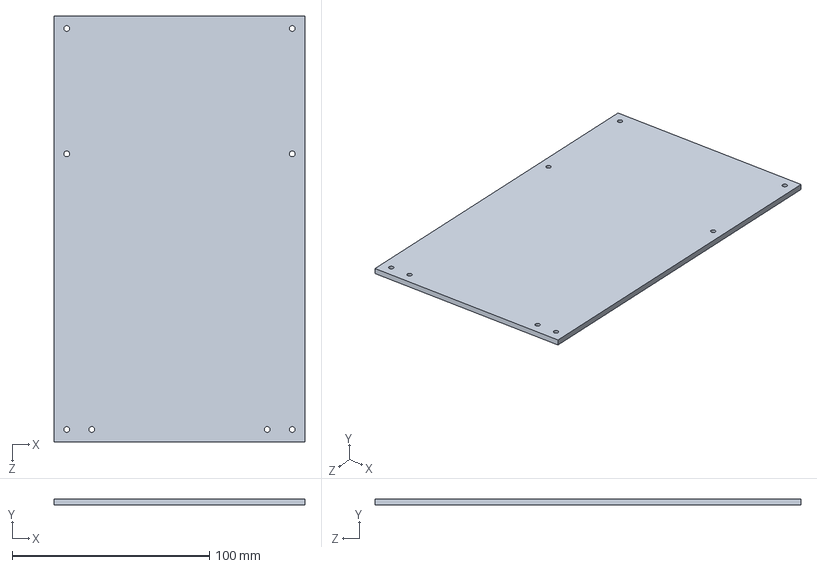
[picture p148: CAD file, 2019-01-25]
PlatePrototype/RecieverBase.SLDPRT
127.0 x 3.17 x 215.9 mm
