NickPham01/ES100/PlatePrototype/ReceiverPCB_rev01.STEP

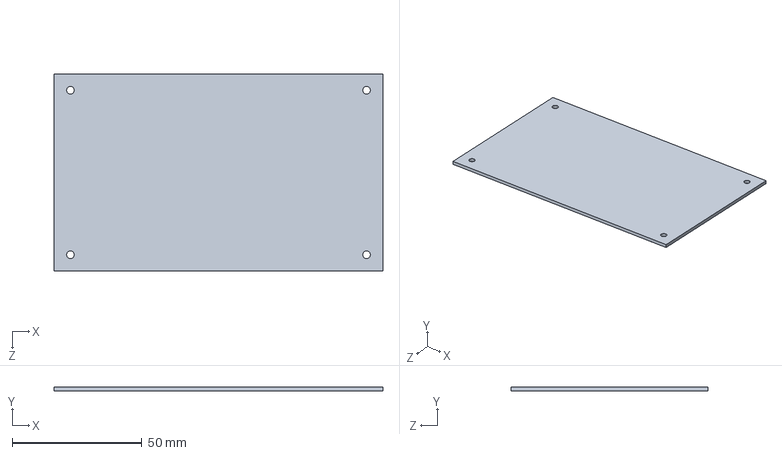
[picture p149: CAD file, 2019-01-25]
PlatePrototype/ReceiverPCB_rev01.STEP
127.0 x 1.59 x 76.2 mm
