NickPham01/ES100/PlatePrototype/ReceiverSideWalls.SLDPRT

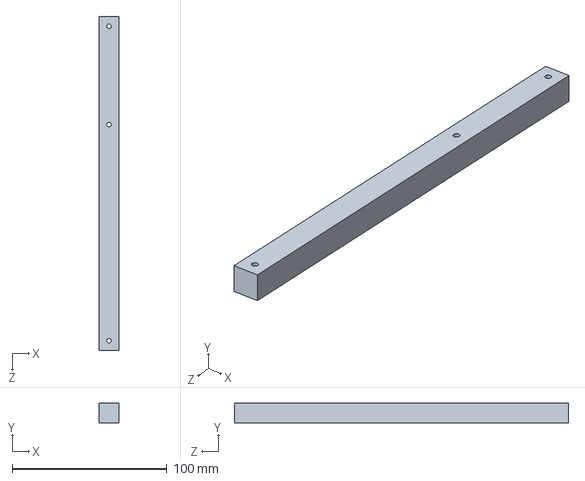
[picture p150: CAD file, 2019-01-25]
PlatePrototype/ReceiverSideWalls.SLDPRT
12.7 x 12.7 x 215.9 mm
