NickPham01/ES100/PlatePrototype/PedalFootprints/EHXSmall.SLDPRT

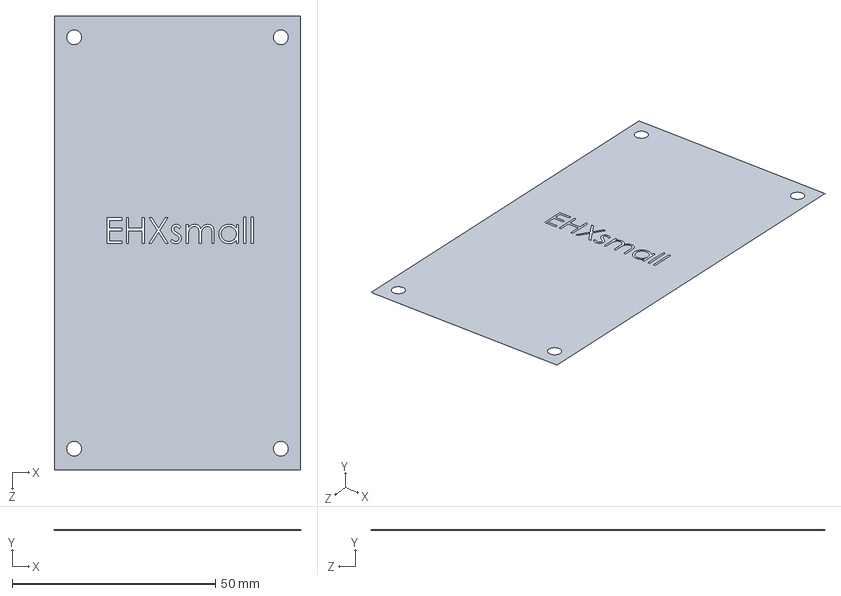
[picture p151: CAD file, 2018-11-03]
PlatePrototype/PedalFootprints/EHXSmall.SLDPRT
60.5 x 0.00254 x 111.5 mm
