NickPham01/ES100/PlatePrototype/mill-max-0914-0-15-20-77-14-11-0.SLDPRT

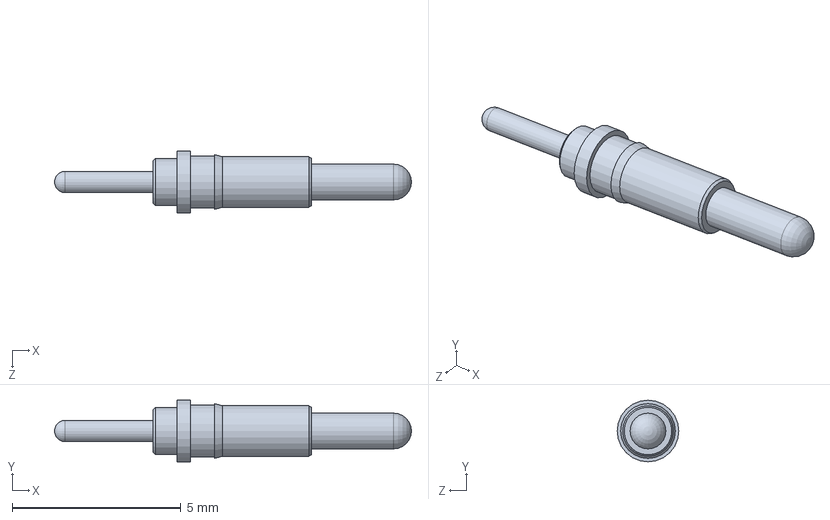
[picture p152: CAD file, 2018-11-06]
PlatePrototype/mill-max-0914-0-15-20-77-14-11-0.SLDPRT
10.6 x 1.83 x 1.83 mm
