NickPham01/ES100/PlatePrototype/mill-max-0914-2-15-20-77-14-11-0.SLDPRT

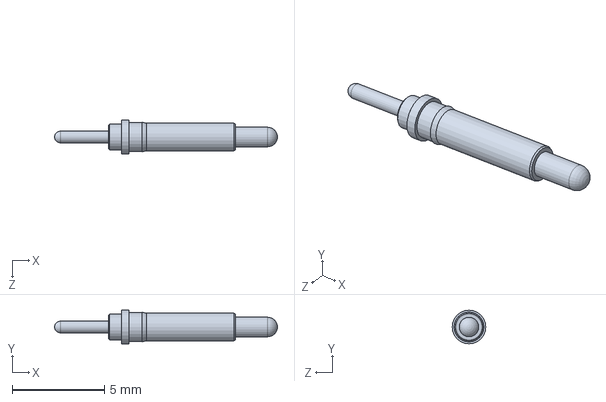
[picture p153: CAD file, 2018-11-06]
PlatePrototype/mill-max-0914-2-15-20-77-14-11-0.SLDPRT
12.1 x 1.83 x 1.83 mm
