NickPham01/ES100/PlatePrototype/mill-max-0914-1-15-20-77-14-11-0.SLDPRT

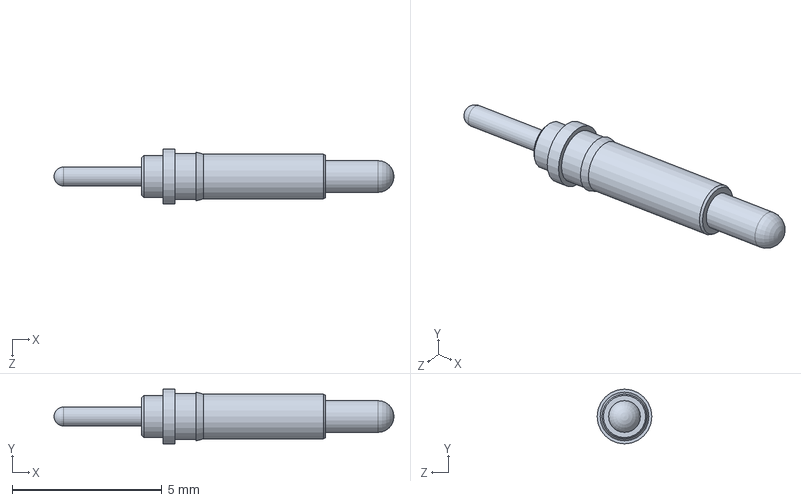
[picture p154: CAD file, 2018-11-06]
PlatePrototype/mill-max-0914-1-15-20-77-14-11-0.SLDPRT
11.4 x 1.83 x 1.83 mm
