NickPham01/ES100/PlatePrototype/PlatePrototype_small1.SLDPRT

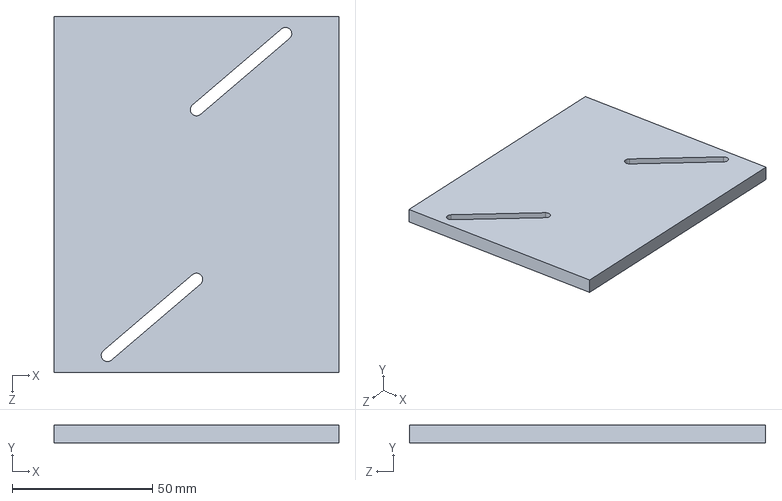
[picture p155: CAD file, 2018-11-03]
PlatePrototype/PlatePrototype_small1.SLDPRT
101.6 x 6.35 x 127.0 mm
