NickPham01/ES100/PlatePrototype/PlatePrototype_small2top.SLDPRT

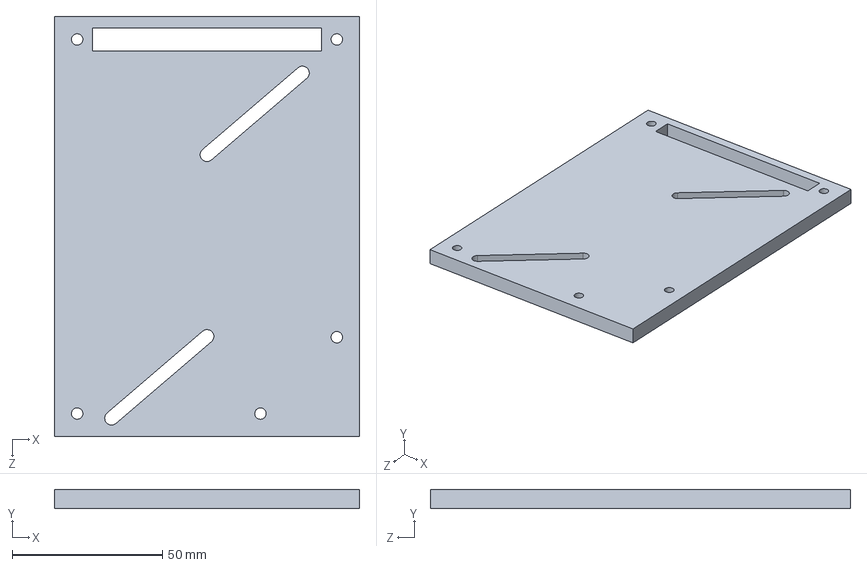
[picture p156: CAD file, 2018-11-03]
PlatePrototype/PlatePrototype_small2top.SLDPRT
101.6 x 6.35 x 139.7 mm
