NickPham01/ES100/PlatePrototype/RecieverMiddle2.SLDPRT

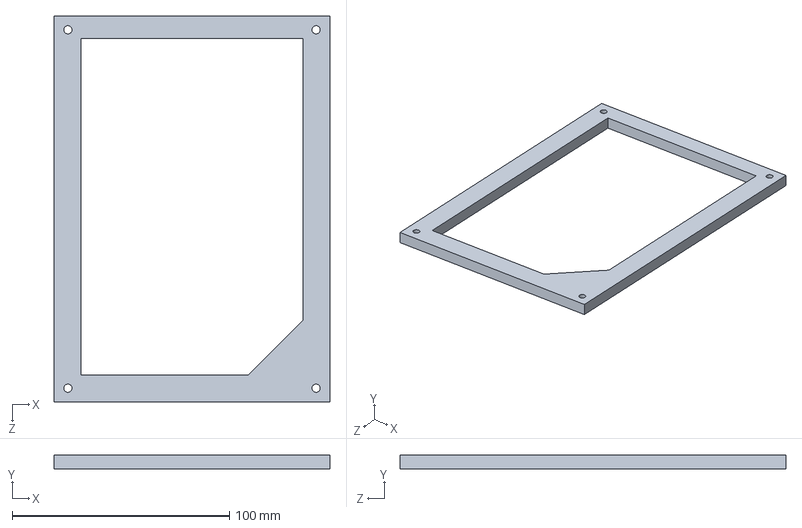
[picture p157: CAD file, 2018-11-03]
PlatePrototype/RecieverMiddle2.SLDPRT
127.0 x 6.35 x 177.8 mm
