NickPham01/ES100/(list of files, cad)

Other CAD files:
PlatePrototype/10PogoPins.STEP
PlatePrototype/PedalFootprints/EQLarge.SLDPRT
PlatePrototype/PedalFootprints/EQStandard.SLDPRT
PlatePrototype/RecieverTop2.SLDPRT
PlatePrototype/10PogoPins.SLDASM
PlatePrototype/PedalFootprints/BossCompact.DXF
PlatePrototype/PedalFootprints/BossDual.DXF
PlatePrototype/PedalFootprints/EHXLarge.DXF
PlatePrototype/PedalFootprints/EHXMed.DXF
PlatePrototype/PedalFootprints/EHXSmall.DXF
PlatePrototype/PedalFootprints/EQStandard.DXF
PlatePrototype/PedalFootprints/JHSStandard.DXF
PlatePrototype/PedalFootprints/KeeleyStandard.DXF
PlatePrototype/PlatePrototype_PCBshape.DXF
PlatePrototype/PlatePrototype_PCBshape.SLDPRT
PlatePrototype/PlatePrototype_PCBshape.STEP
PlatePrototype/PlatePrototype_small1.DXF
PlatePrototype/PlatePrototype_small2bottom.DXF
PlatePrototype/PlatePrototype_small2top.DXF
PlatePrototype/ReceiverPCB.SLDPRT
PlatePrototype/ReceiverPCB_rev01.SLDPRT
PlatePrototype/RecieverMiddle2.DXF
PlatePrototype/RecieverTop2.DXF
