NickPham01/ES100/FinalReport/PR5Images/AssemblyWReceiversUI.png

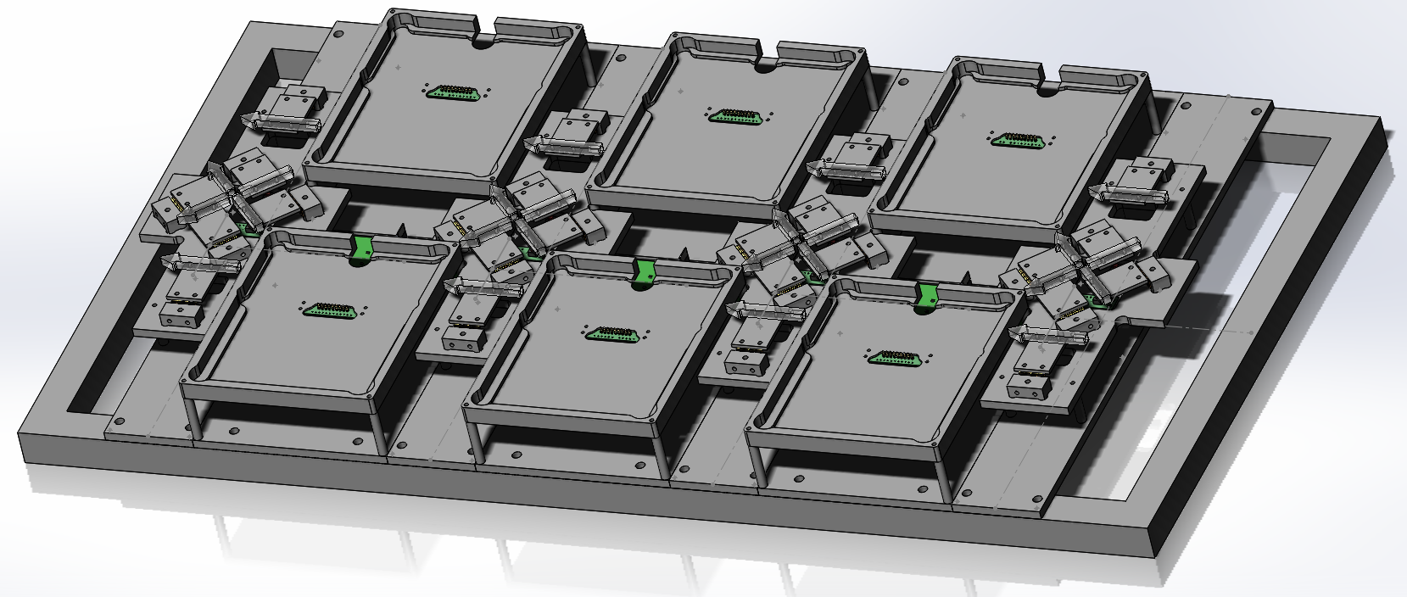
FinalReport/PR5Images/AssemblyWReceiversUI.png
