NickPham01/ES100/PR4/NickPhamAPMeasurements/DeviceActiveChoke.xls

Gen.Ampl | Anlr.Level A
Source 1 | Data 1
dBu | dBu
10.00019335 | 9.994390686
8.900333837 | 8.904415054
7.799807394 | 7.782427162
6.699458906 | 6.68167261
5.599693585 | 5.581838023
4.500398942 | 4.483421464
3.400916538 | 3.390234254
2.300098594 | 2.287977736
1.199677169 | 1.186192924
0.09958507431 | 0.08450566082
-0.9991233609 | -1.015610283
-2.100074687 | -2.126184664
-3.200020972 | -3.21068034
-4.299582068 | -4.328216292
-5.399319655 | -5.425895369
-6.499168921 | -6.52527131
-7.599703288 | -7.627244476
-8.699708079 | -8.717617302
-9.800122228 | -9.818568629
-10.89893969 | -10.92530675
-11.99954504 | -12.0187365
-13.10196922 | -13.12726383
-14.19957712 | -14.22452871
-15.2994534 | -15.3134021
-16.39936399 | -16.41356305
-17.50019312 | -17.51301926
-18.60035842 | -18.62336581
-19.70020769 | -19.7222604
-20.80074205 | -20.81067334
-21.90074684 | -21.91170736
-23.00116099 | -23.0176349
-24.09906411 | -24.11347048
-25.20110278 | -25.21913994
-26.29947355 | -26.31748175
-27.40061589 | -27.41656273
-28.49954371 | -28.51769097
-29.59975685 | -29.6172367
-30.70000995 | -30.71226422
-31.79890088 | -31.81218145
-32.89967232 | -32.92252801
-33.99892221 | -34.01214919
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
