NickPham01/ES100/PR4/NickPhamAPMeasurements/DeviceBypassNoPWr.xls

Gen.Ampl | Anlr.Level A
Source 1 | Data 1
dBu | dBu
10.00019335 | 9.997212154
8.900333837 | 8.904415054
7.799807394 | 7.789704825
6.699458906 | 6.685803829
5.599693585 | 5.586526762
4.500398942 | 4.478097597
3.400916538 | 3.396268218
2.300098594 | 2.294827807
1.199677169 | 1.186192924
0.09958507431 | 0.08450566082
-0.9991233609 | -1.010599675
-2.100074687 | -2.126184664
-3.200020972 | -3.21068034
-4.299582068 | -4.328216292
-5.399319655 | -5.425895369
-6.499168921 | -6.52527131
-7.599703288 | -7.632611105
-8.699708079 | -8.714576556
-9.800122228 | -9.815117053
-10.89893969 | -10.92138624
-11.99954504 | -12.0231851
-13.10196922 | -13.12726383
-14.19957712 | -14.22452871
-15.2994534 | -15.3134021
-16.39936399 | -16.40618963
-17.50019312 | -17.51301926
-18.60035842 | -18.61861033
-19.70020769 | -19.71686376
-20.80074205 | -20.80761439
-21.90074684 | -21.90823508
-23.00116099 | -23.00974939
-24.09906411 | -24.11347048
-25.20110278 | -25.21913994
-26.29947355 | -26.31748175
-27.40061589 | -27.41656273
-28.49954371 | -28.51769097
-29.59975685 | -29.6172367
-30.70000995 | -30.71226422
-31.79890088 | -31.81218145
-32.89967232 | -32.92252801
-33.99892221 | -34.01214919
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
