NickPham01/ES100/PR4/NickPhamAPMeasurements/DeviceBypassNoPWR_FR.xls

Gen.Freq | Anlr.Level A
Source 1 | Data 1
Hz | dBu
30000 | -0.04450608327
25550 | -0.03554693896
21775 | -0.02659702612
18557.5 | -0.02212552557
15810 | -0.01765632576
13472.5 | -0.01765632576
11477.5 | -0.01765632576
9780 | -0.01765632576
8332.5 | -0.01318942433
7100 | -0.01765632576
6050 | -0.01318942433
5155 | -0.01318942433
4392.5 | -0.01318942433
3742.5 | -0.01318942433
3187.5 | -0.01318942433
2717.5 | -0.01318942433
2315 | -0.02212552557
1972 | -0.01765632576
1680.25 | -0.01318942433
1431.5 | -0.01765632576
1219.75 | -0.01318942433
1039.25 | -0.01765632576
885.5 | -0.01318942433
754.5 | -0.01765632576
642.75 | -0.01318942433
547.75 | -0.01765632576
466.75 | -0.01318942433
397.75 | -0.02212552557
338.75 | -0.02212552557
288.75 | -0.01765632576
246 | -0.01765632576
209.5 | -0.02212552557
178.55 | -0.02212552557
152.125 | -0.008724818916
129.625 | 0.0001975132889
110.45 | -0.004262507162
94.1 | -0.01318942433
80.175 | -0.01318942433
68.325 | -0.01318942433
58.2 | -0.008724818916
49.6 | -0.01318942433
42.25 | -0.01989063822
36 | -0.01989063822
30.675 | -0.01765632576
26.125 | -0.01877341014
22.275 | -0.02100801001
18.975 | -0.02771526103
16.175 | -0.01430593434
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
