NickPham01/ES100/PR4/NickPhamAPMeasurements/APSystemTHD_01.csv

Gen.Ampl | Anlr.Level A
Source 1 | Data 1
dBu | dBu
10.00019335 | 10.01130576
8.900333837 | 8.907613688
7.799807394 | 7.800609898
6.699458906 | 6.698185713
5.599693585 | 5.595896655
4.500398942 | 4.49405942
3.400916538 | 3.408323583
2.300098594 | 2.30167248
1.199677169 | 1.201738144
0.09958507431 | 0.0933327852
-0.9991233609 | -1.000587121
-2.100074687 | -2.120490865
-3.200020972 | -3.21068034
-4.299582068 | -4.317214531
-5.399319655 | -5.417571564
-6.499168921 | -6.52527131
-7.599703288 | -7.627244476
-8.699708079 | -8.711536875
-9.800122228 | -9.815117053
-10.89893969 | -10.91355053
-11.99954504 | -12.02763598
-13.10196922 | -13.12221243
-14.19957712 | -14.20734593
-15.2994534 | -15.29392701
-16.39936399 | -16.39882246
-17.50019312 | -17.50047041
-18.60035842 | -18.60435948
-19.70020769 | -19.70608053
-20.80074205 | -20.80149972
-21.90074684 | -21.89435986
-23.00116099 | -22.99793453
-24.09906411 | -24.10452518
-25.20110278 | -25.20390598
-26.29947355 | -26.31171614
-27.40061589 | -27.41001969
-28.49954371 | -28.51769097
-29.59975685 | -29.60880789
-30.70000995 | -30.71226422
-31.79890088 | -31.81218145
-32.89967232 | -32.91019885
-33.99892221 | -34.01214919
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
