NickPham01/ES100/PR4/tekmeasurements/tek0001.csv

Model | MSO3014
Firmware Version | 2.40
Waveform Type | ANALOG
Point Format | Y
Horizontal Units | s
Horizontal Scale | 0.002
Horizontal Delay | 0.003968
Sample Interval | 2e-07
Record Length | 100000
Gating | 0.0% to 100.0%
Probe Attenuation | 10
Vertical Units | V
Vertical Offset | 0
Vertical Scale | 10
Vertical Position | 1.98
Label
TIME | CH1 | CH2
-6.03200e-03 | -14.2 | 14
-6.03180e-03 | -14.2 | 13.6
-6.03160e-03 | -14.2 | 14
-6.03140e-03 | -14.2 | 14
-6.03120e-03 | -14.6 | 14
-6.03100e-03 | -15 | 14.4
-6.03080e-03 | -14.6 | 14.4
-6.03060e-03 | -14.2 | 13.6
-6.03040e-03 | -14.2 | 14.4
-6.03020e-03 | -13.8 | 14
-6.03000e-03 | -14.2 | 14
-6.02980e-03 | -14.6 | 14
-6.02960e-03 | -14.6 | 14
-6.02940e-03 | -15 | 14
-6.02920e-03 | -14.2 | 14.4
-6.02900e-03 | -14.2 | 14.4
-6.02880e-03 | -14.6 | 13.6
-6.02860e-03 | -14.6 | 14.4
-6.02840e-03 | -14.6 | 13.6
-6.02820e-03 | -14.2 | 14
-6.02800e-03 | -14.6 | 13.6
-6.02780e-03 | -14.2 | 13.2
-6.02760e-03 | -14.2 | 13.6
-6.02740e-03 | -14.6 | 13.6
-6.02720e-03 | -14.6 | 13.6
-6.02700e-03 | -14.6 | 14.4
-6.02680e-03 | -15 | 13.6
-6.02660e-03 | -15 | 13.6
-6.02640e-03 | -14.6 | 14.4
-6.02620e-03 | -14.6 | 13.6
-6.02600e-03 | -15 | 14.4
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
