NickPham01/ES100/FinalPresentationReport/SNR_calc_results.png

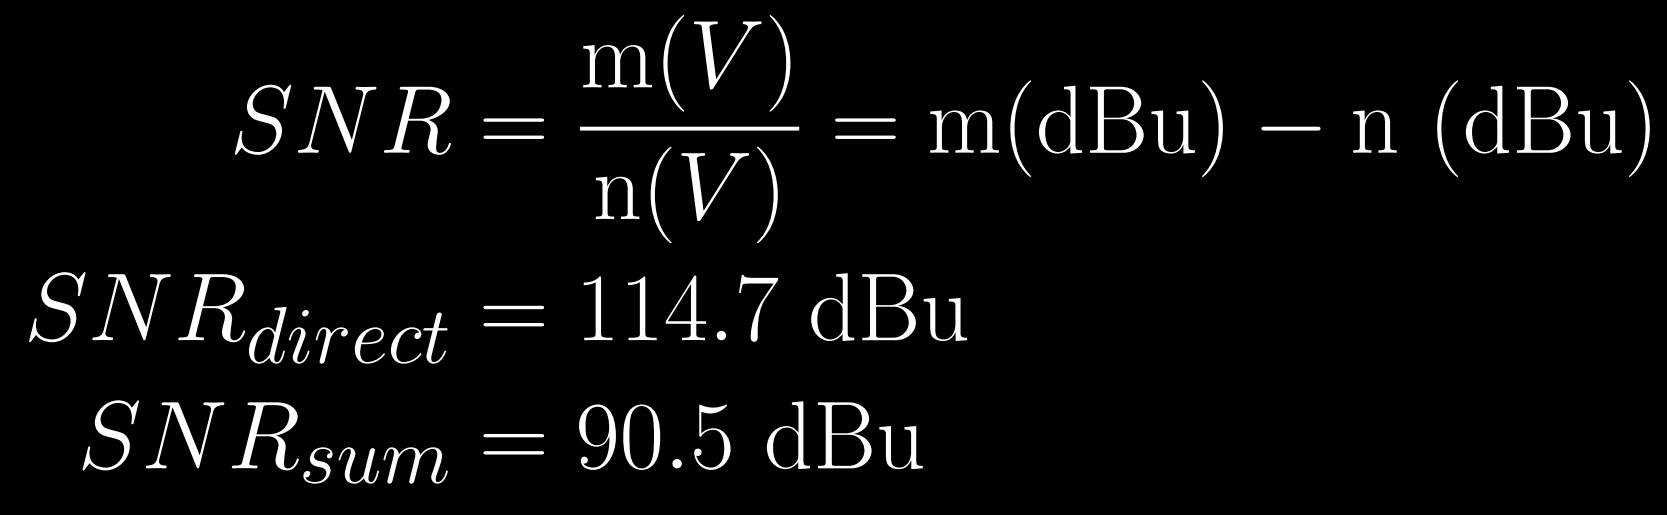
FinalPresentationReport/SNR_calc_results.png
