NickPham01/ES100/FinalTekMeasurements/NickPham/bench_relay_switching_td.png

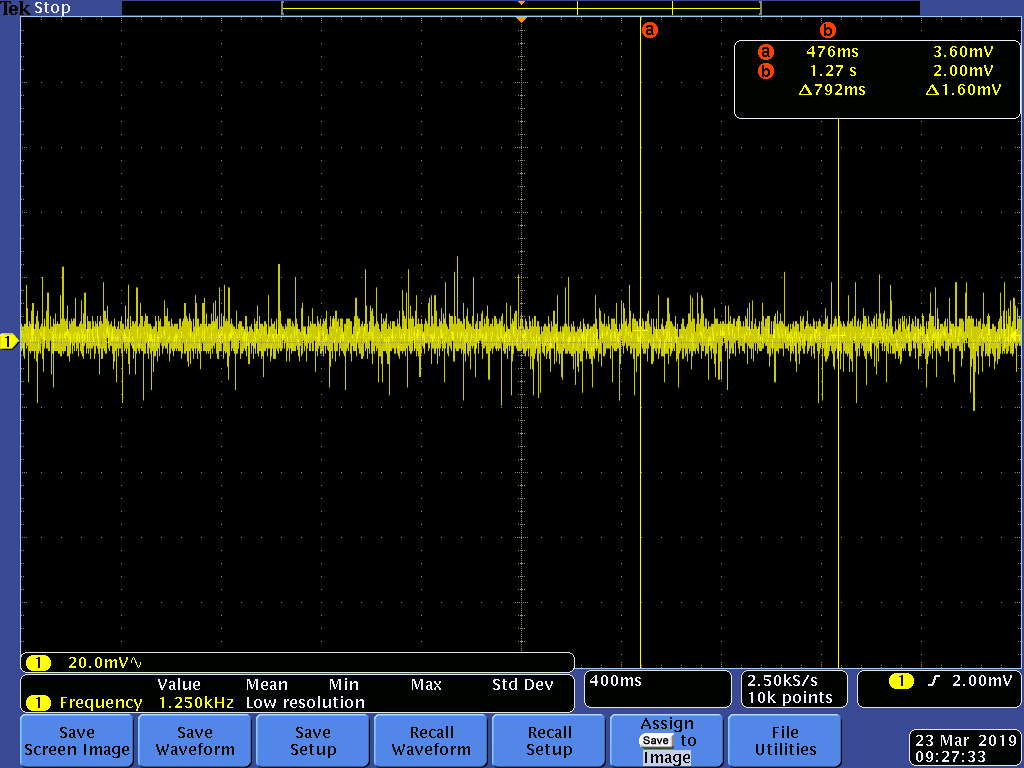
FinalTekMeasurements/NickPham/bench_relay_switching_td.png
