NickPham01/ES100/FinalTekMeasurements/NickPham/benchsupply_td.png

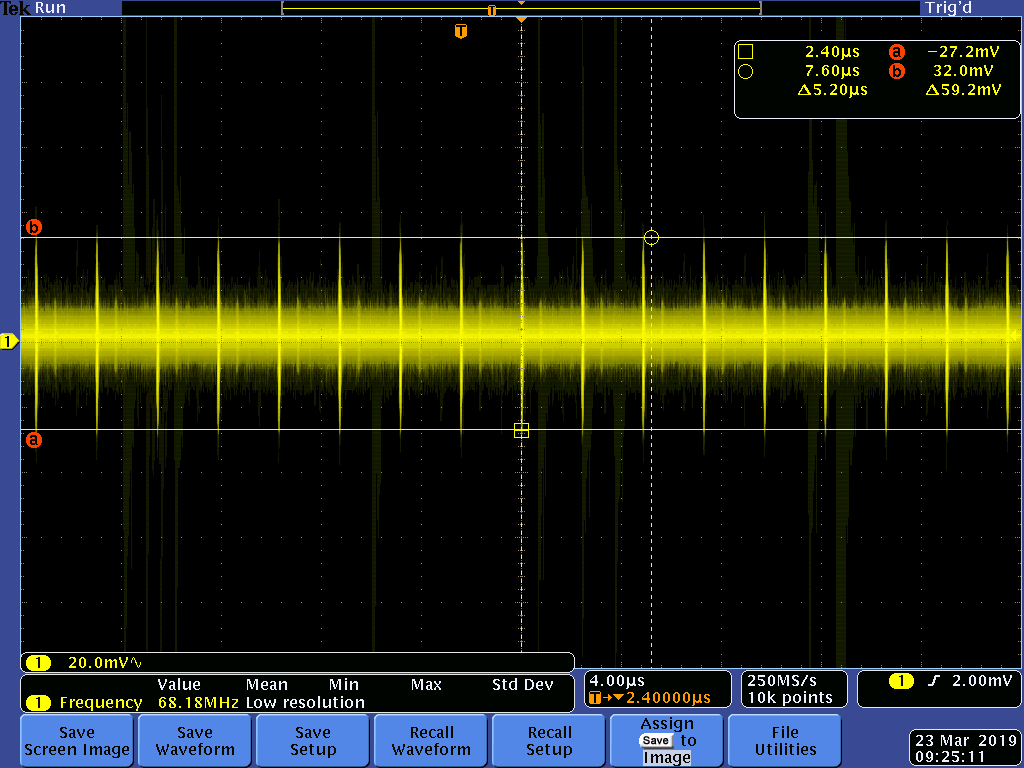
FinalTekMeasurements/NickPham/benchsupply_td.png
