NickPham01/ES100/FinalTekMeasurements/NickPham/current_during_relay.png

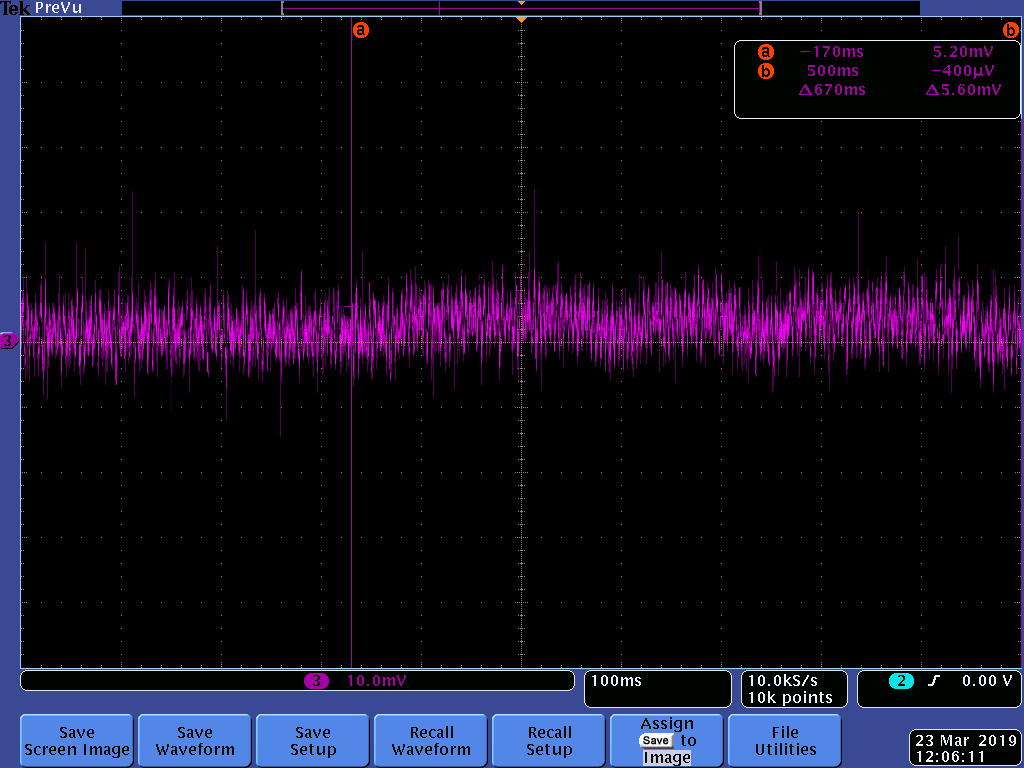
FinalTekMeasurements/NickPham/current_during_relay.png
