NickPham01/ES100/FinalTekMeasurements/NickPham/sumingamp_td.png

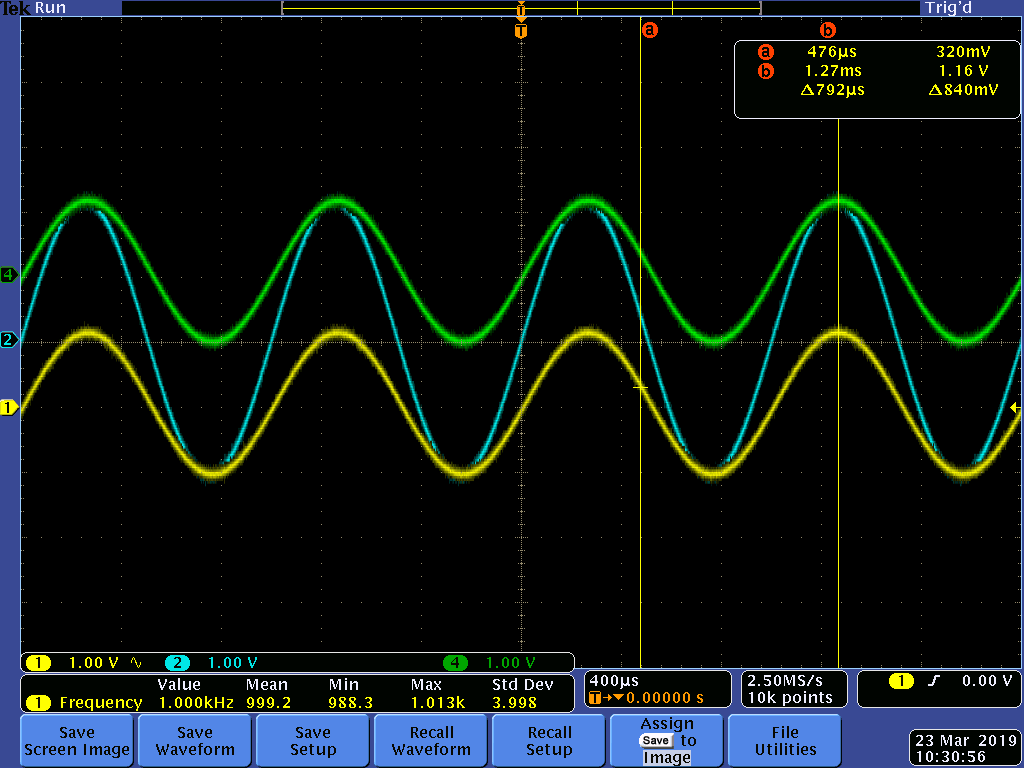
FinalTekMeasurements/NickPham/sumingamp_td.png
