NickPham01/ES100/FinalTekMeasurements/NickPham/summingamp_fft.png

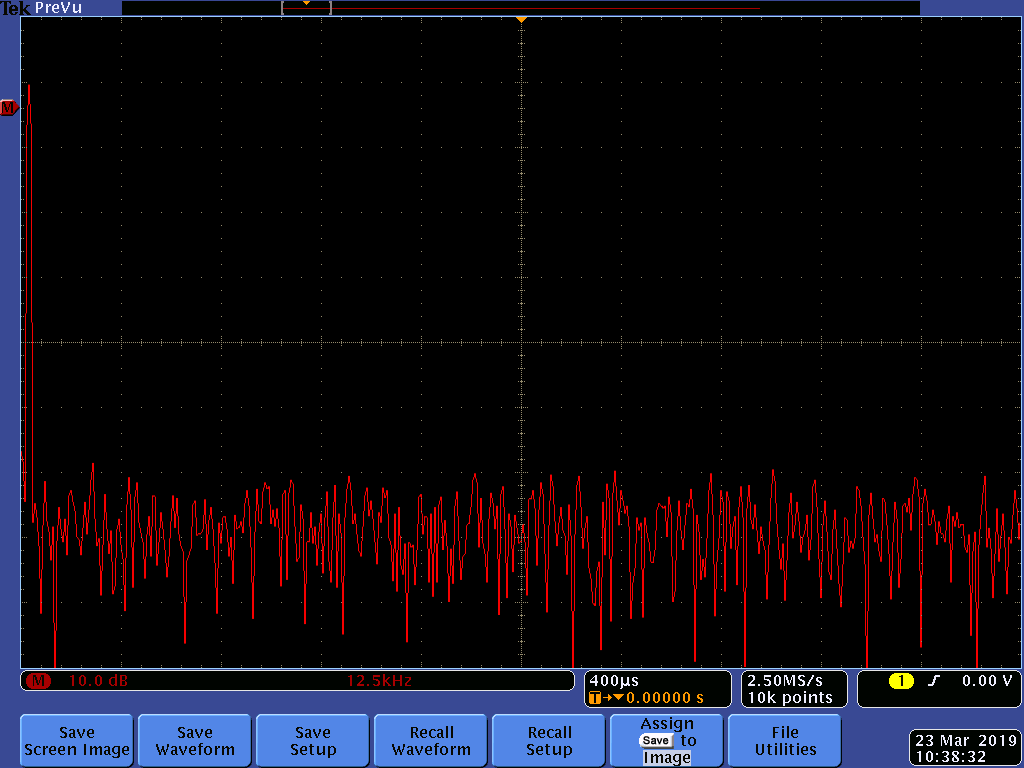
FinalTekMeasurements/NickPham/summingamp_fft.png
