NickPham01/ES100/FinalTekMeasurements/NickPham/switch_event_td.png

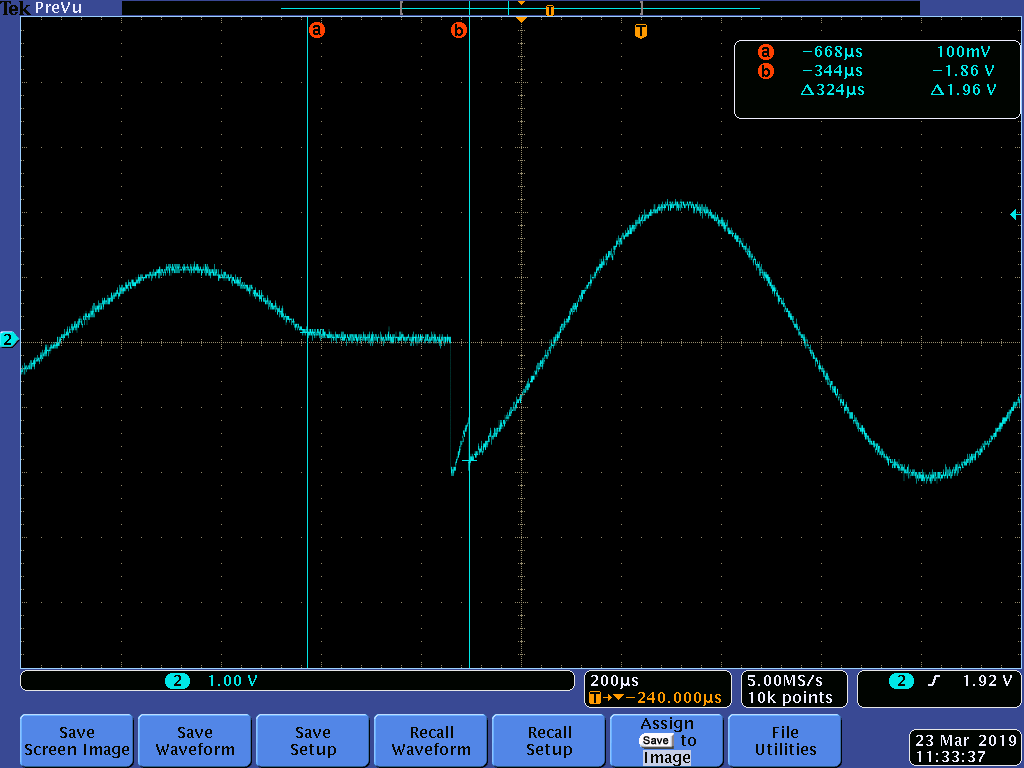
FinalTekMeasurements/NickPham/switch_event_td.png
