NickPham01/ES100/FinalTekMeasurements/NickPham/switchfromsum.png

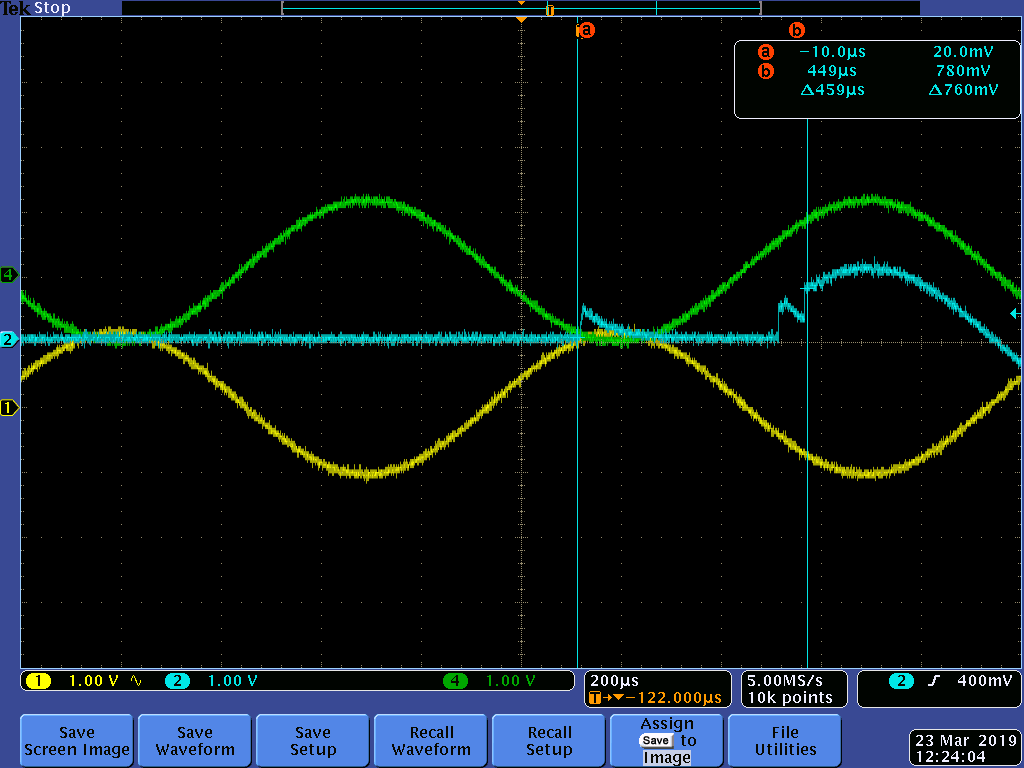
FinalTekMeasurements/NickPham/switchfromsum.png
