NickPham01/ES100/FinalTekMeasurements/NickPham/tek00000.png

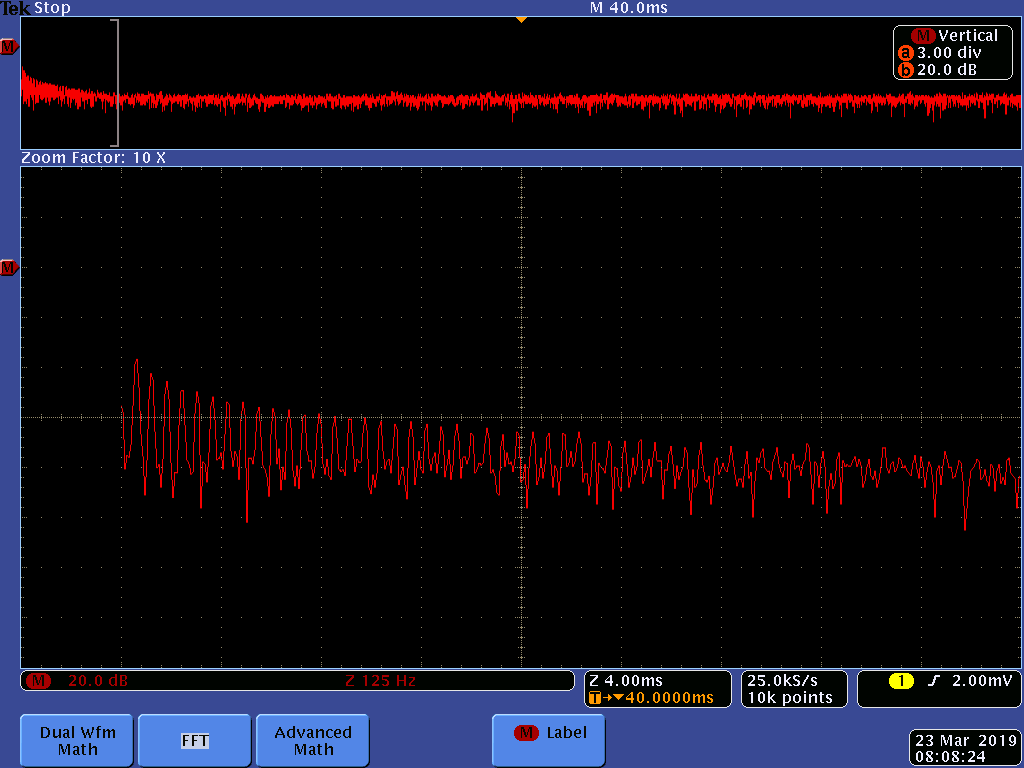
FinalTekMeasurements/NickPham/tek00000.png
