NickPham01/ES100/FinalTekMeasurements/NickPham/tek00001.png

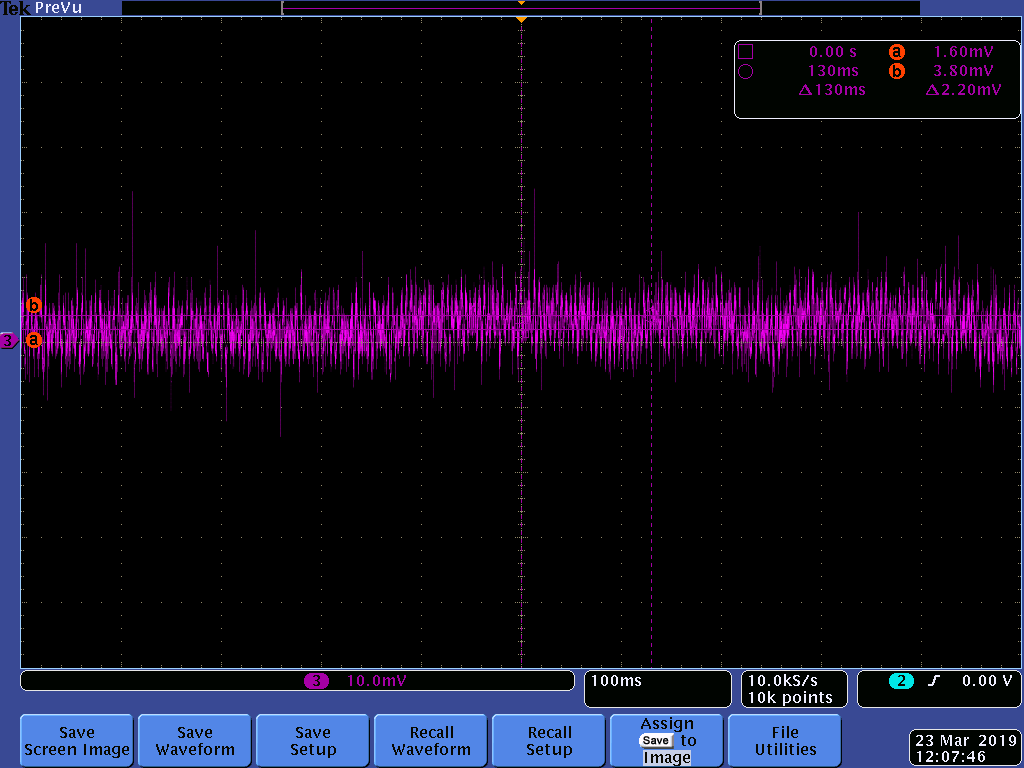
FinalTekMeasurements/NickPham/tek00001.png
