NickPham01/ES100/FinalTekMeasurements/NickPham/vdc_choke&caps_fft.png

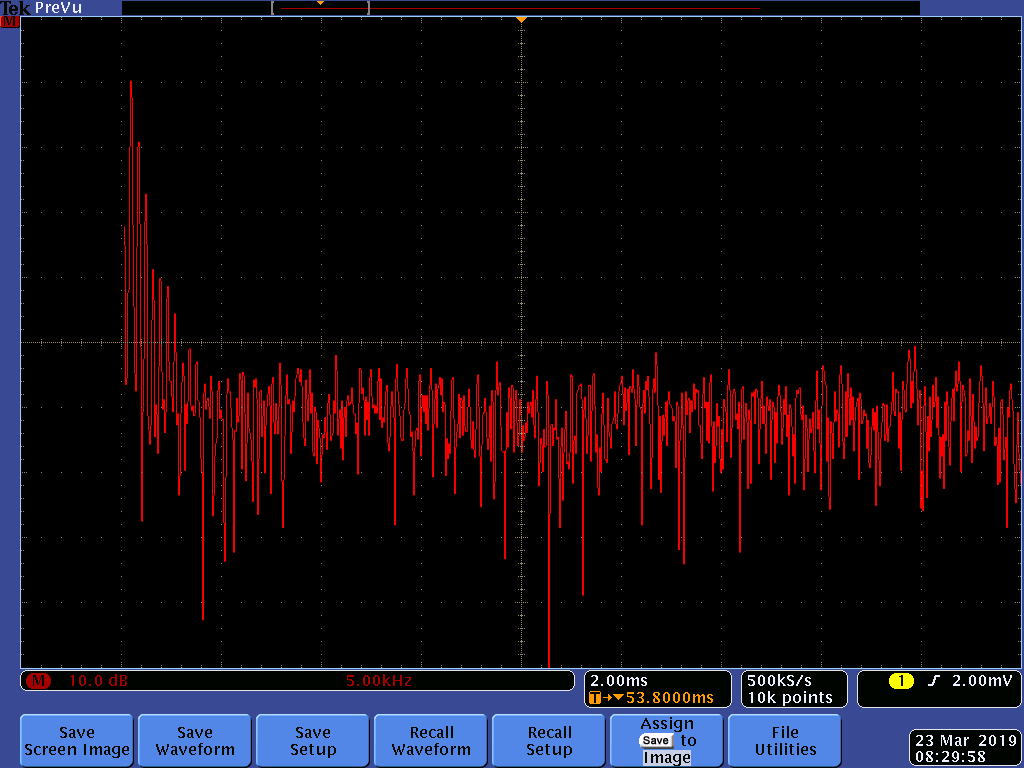
FinalTekMeasurements/NickPham/vdc_choke&caps_fft.png
