NickPham01/ES100/FinalTekMeasurements/NickPham/vdc_choke&caps_td.png

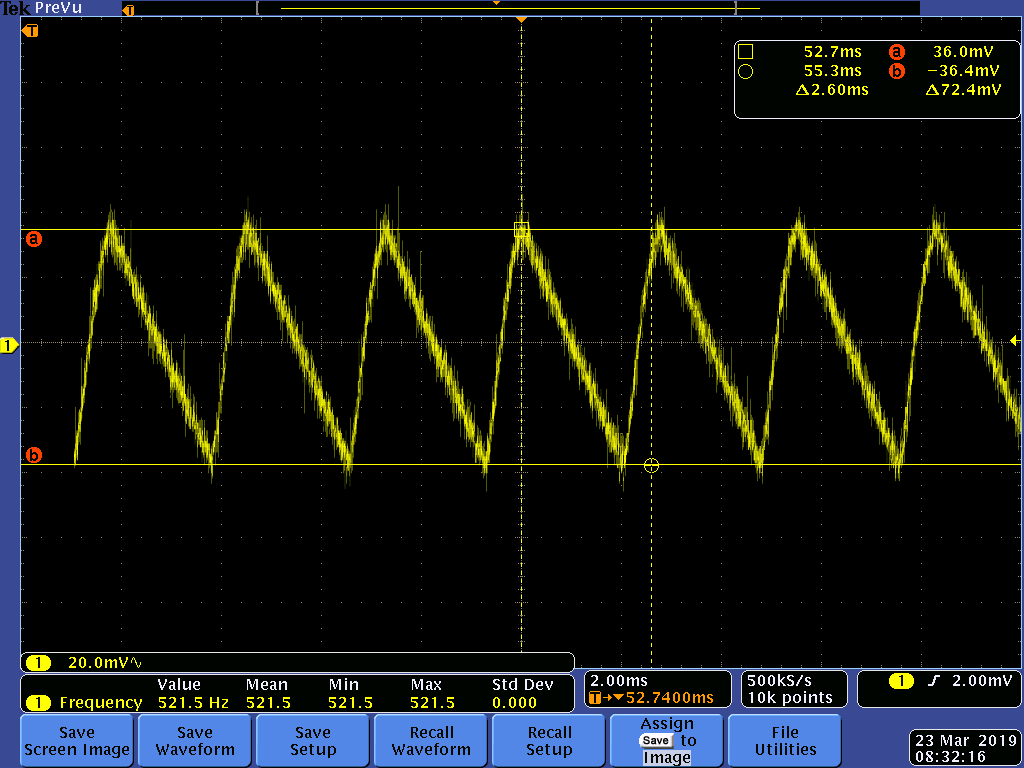
FinalTekMeasurements/NickPham/vdc_choke&caps_td.png
