NickPham01/ES100/FinalTekMeasurements/NickPham/vdc_choke_td.png

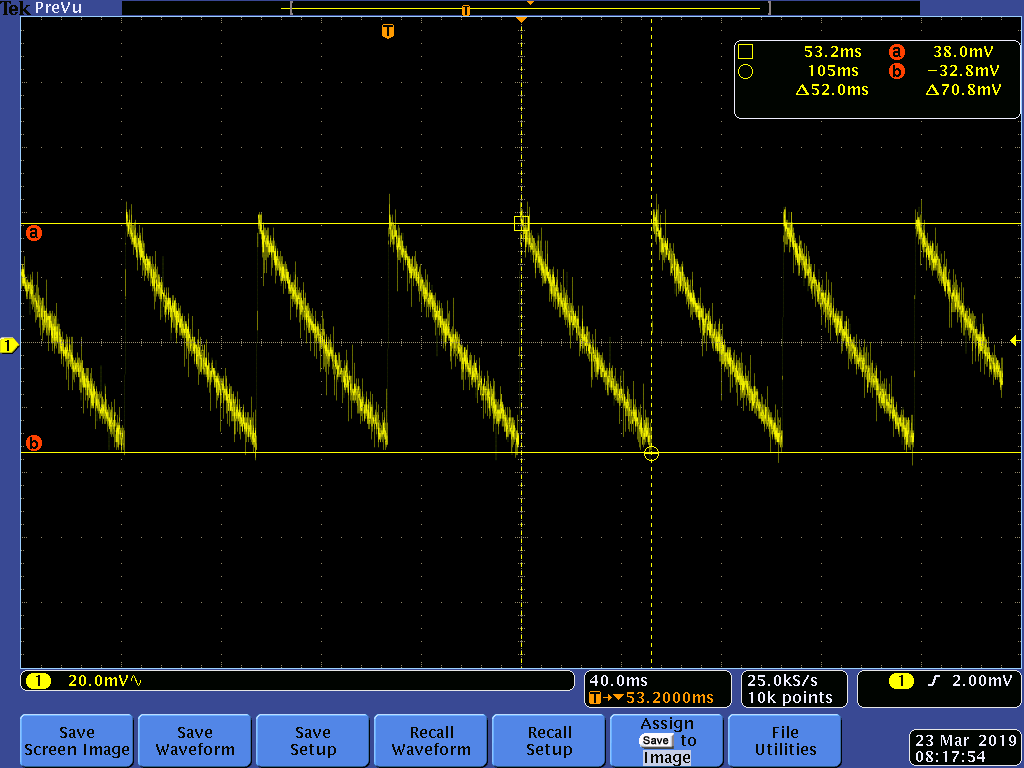
FinalTekMeasurements/NickPham/vdc_choke_td.png
