NickPham01/ES100/FinalTekMeasurements/NickPham/vdc_raw_fft.png

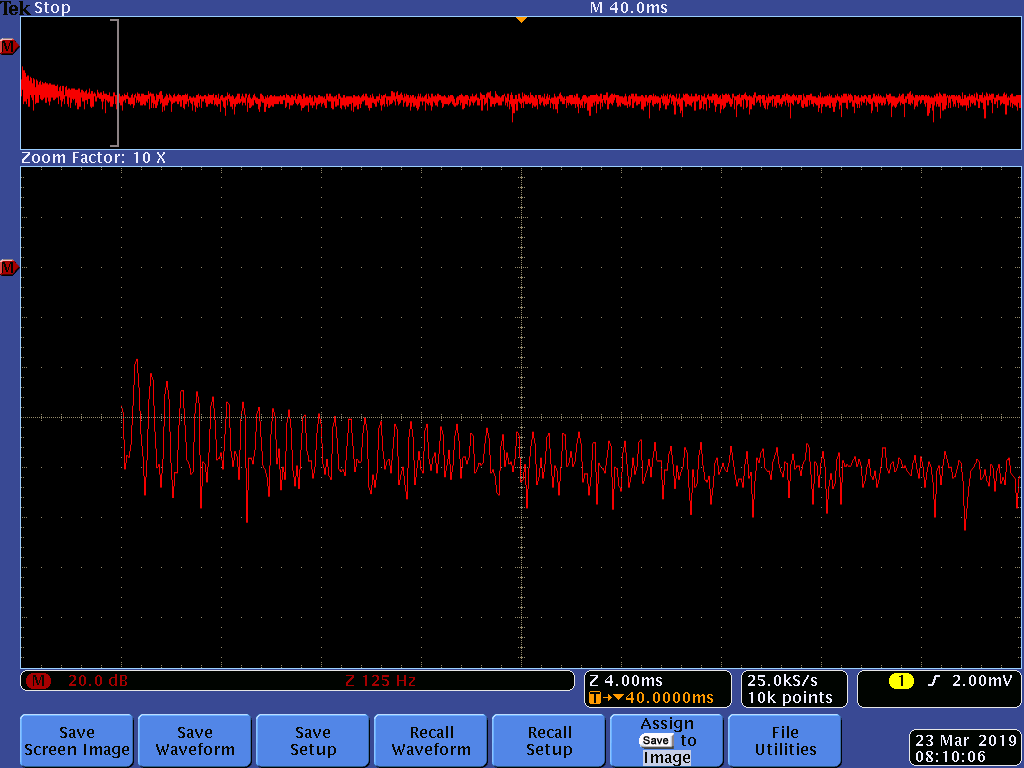
FinalTekMeasurements/NickPham/vdc_raw_fft.png
