NickPham01/ES100/FinalTekMeasurements/NickPham/vdc_raw_timedomain.png

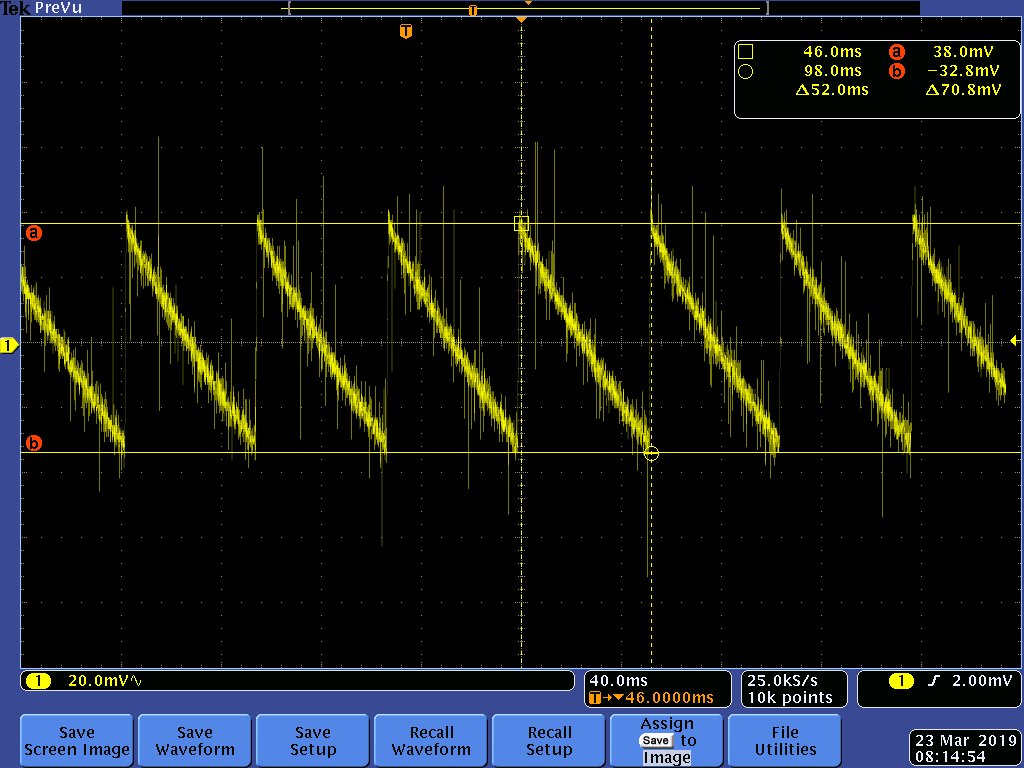
FinalTekMeasurements/NickPham/vdc_raw_timedomain.png
