NickPham01/ES100/PR4/NickPhamAPMeasurements/FR_settings.PNG

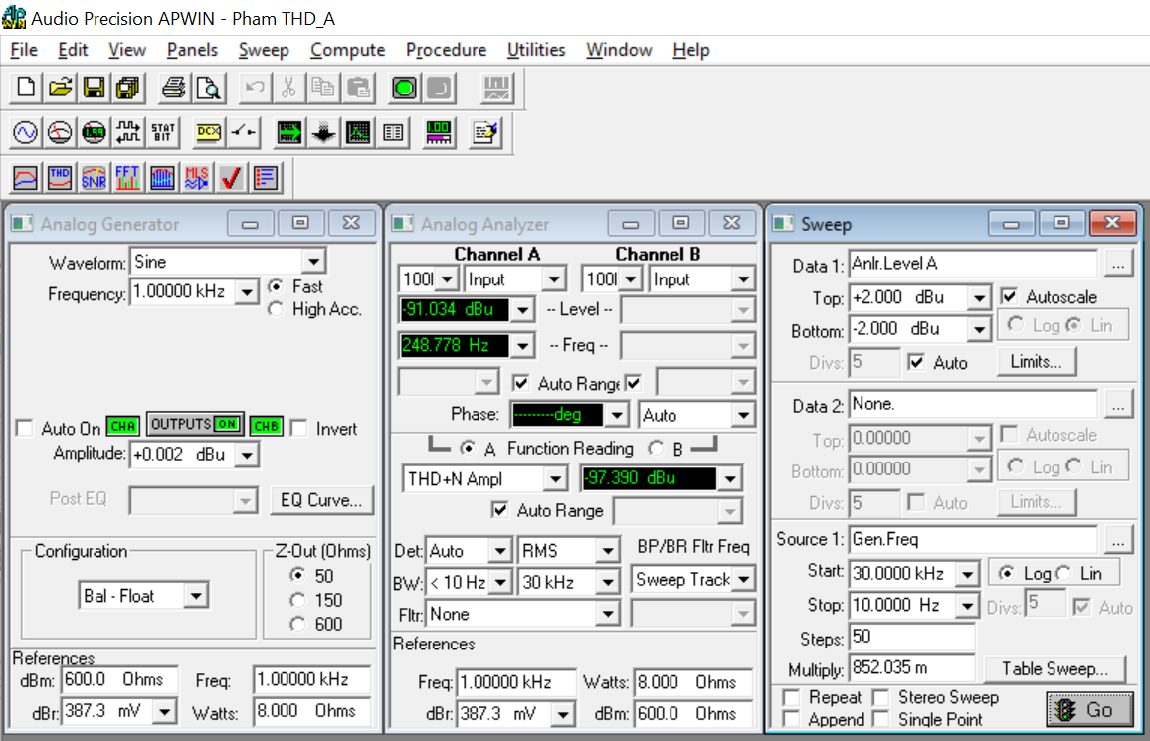
PR4/NickPhamAPMeasurements/FR_settings.PNG
