NickPham01/ES100/PR4/tekmeasurements/tek0000.png

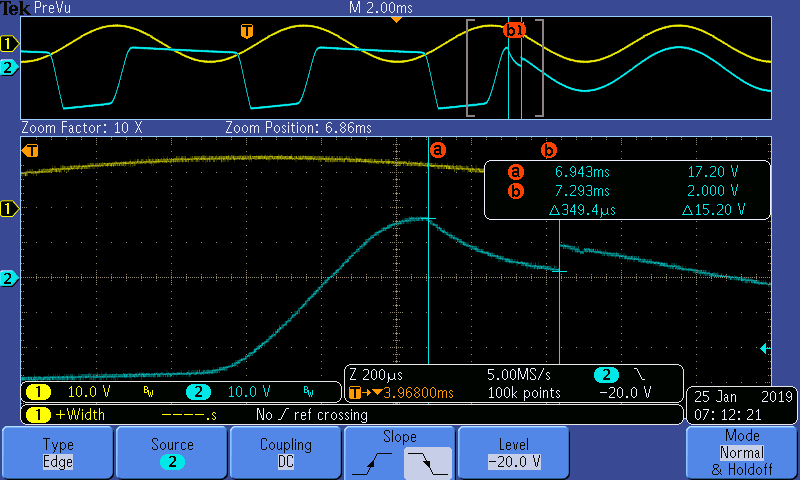
PR4/tekmeasurements/tek0000.png
