NickPham01/ES100/PR4/tekmeasurements/tek0001.png

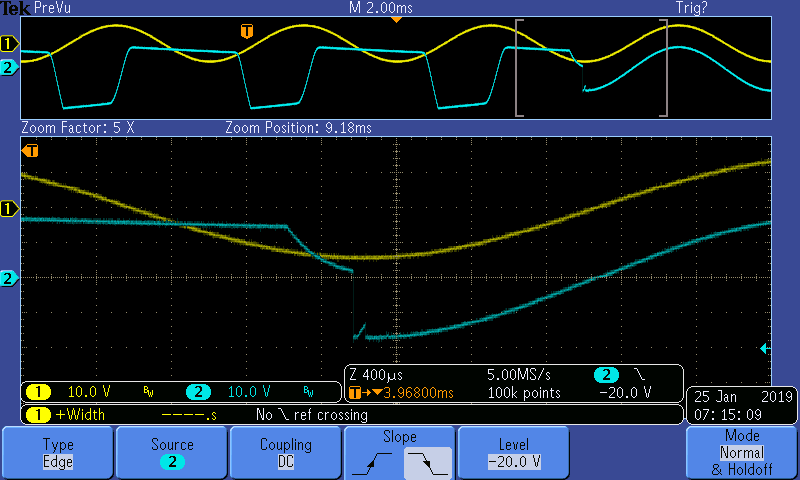
PR4/tekmeasurements/tek0001.png
