NickPham01/ES100/PR4/tekmeasurements/tek0002.png

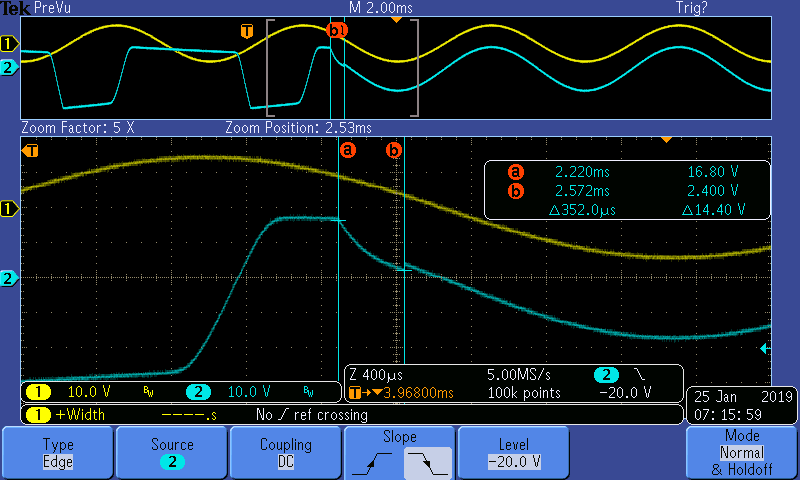
PR4/tekmeasurements/tek0002.png
