NickPham01/ES100/PR4/tekmeasurements/tek0003.png

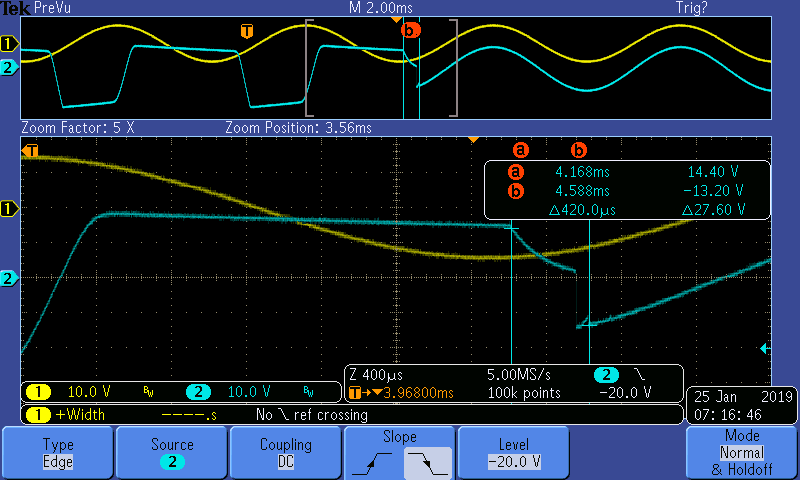
PR4/tekmeasurements/tek0003.png
