NickPham01/ES100/FinalReport/FinalBudget.pdf

## BOM (Bill of Materials)

Designator(s) | Value | Description | Manufacturer | Manufacturer Part No. Supplier | Supplier Part No. | QTY (1 Module) QTY(4 Modules) Price (Unit) Units Total Cost Link | Notes
C1, C2, C3, C4, C5, C6, C7, C10, C11, C12, C13, C14, C16, C18, C19, C21, C23, C24, C27, C28, C29, C15a, C15b, C31a, C31b, C32a, C32b 0.1uF | CAP CER 0.1UF 50V X7R 0805 Samsung Electro-Mechanics CL21B104KBCWPNCDigikey | 1276-6557-1-ND | 27 | 108 | $0.03 | 100 | $3.23 https://www.digikey.com/product-detail/en/samsung-electro-mechanics/CL21B104KBCWPNC/1276-6557-1-ND/5961416 Buy two sets of 200?
R1, R2, R33, R35 | 4.7K | RES SMD 4.7K OHM 1% 1/8W 0805 Yageo | RC0805FR-074K7LDigikey | 311-4.70KCRCT-ND | 4 | 10 | $0.10 | 1 | $1.00 https://www.digikey.com/product-detail/en/yageo/RC0805FR-074K7L/311-4.70KCRCT-ND/730876 I2C pullups: only populate one module
U2, U4, U5 | LV8548MC | IC MOTOR DRIVER PAR MFP10S ON Semiconductor | LV8548MC-AH | Digikey | 869-1287-1-ND | 3 | 12 | $1.33 | 1 | $15.96 https://www.digikey.com/product-detail/en/on-semiconductor/LV8548MC-AH/869-1287-1-ND/2651531
U1 | ATMEGA3209 | IC MCU 8BIT 32KB FLASH 48TQFP Microchip Technology ATMEGA3209-AFRDigikey | ATMEGA3209-AFRCT-ND | 1 | 4 | $1.47 | 1 | $5.88 https://www.digikey.com/product-detail/en/microchip-technology/ATMEGA3209-AFR/ATMEGA3209-AFRCT-ND/9342200
R18, R19, R25, R26, R30, R31, R39, R40 16K | RES 16K OHM 5% 1/8W 0805 Stackpole Electronics RMCF0805JT16K0Digikey | RMCF0805JT16K0CT-ND | 8 | 32 | $0.02 | 10 | $0.64 https://www.digikey.com/product-detail/en/stackpole-electronics-inc/RMCF0805JT16K0/RMCF0805JT16K0CT-ND/5049818
R3, R4, R5, R6, R8, R11, R16, R20, R27, R28, R36, R37, R41, R42 10K | RES 10K OHM 1% 1/8W 0805 Stackpole Electronics RMCF0805FT10K0CT-ND Digikey | RMCF0805FT10K0 | 14 | 56 | $0.03 | 10 | $1.51 https://www.digikey.com/product-detail/en/stackpole-electronics-inc/RMCF0805FT10K0/RMCF0805FT10K0CT-ND/1942435
R17, R21, R29, R22, R38, R23, R43, R24 75R | RES 75 OHM 1% 1/4W 0805 Stackpole Electronics RNCP0805FTD75R0Digikey | RNCP0805FTD75R0CT-ND | 8 | 32 | $0.10 | 1 | $3.20 https://www.digikey.com/product-detail/en/stackpole-electronics-inc/RNCP0805FTD75R0/RNCP0805FTD75R0CT-ND/2240546
Q3, Q4, Q5, Q6, Q7, Q8, Q9, Q10 2N3904 | TRANS NPN 40V 0.2A SOT23 Stackpole Electronics MMBT3904-TP | Digikey | MMBT3904TPMSCT-ND | 8 | 32 | $0.10 | 1 | $3.20 https://www.digikey.com/product-detail/en/micro-commercial-co/MMBT3904-TP/MMBT3904TPMSCT-ND/717395
C17, C20 C22, C25, C30 10uF | CAP ALUM 10UF 20% 50V RADIAL Wurth Electronics Inc | 860020672010 Digikey | 732-8856-1-ND | 5 | 20 | $0.10 | 1 | $2.00 https://www.digikey.com/product-detail/en/wurth-electronics-inc/860020672010/732-8856-1-ND/5728801
U7 | LM2931 | IC REG LIN POS ADJ 100MA 8SOIC ON Semiconductor | LM2931CDR2GOSCT-ND Digikey | LM2931CDR2GOSCT-ND | 1 | 4 | $0.64 | 1 | $2.56 https://www.digikey.com/product-detail/en/on-semiconductor/LM2931CDR2G/LM2931CDR2GOSCT-ND/917935
R32 | 27K | RES SMD 27K OHM 1% 1/8W 0805 Yageo | RC0805FR-0727KLDigikey | 311-27.0KCRCT-ND | 1 | 4 | $0.10 | 1 | $0.40 https://www.digikey.com/product-detail/en/yageo/RC0805FR-0727KL/311-27.0KCRCT-ND/730727
R34 | 487K | RES SMD 487K OHM 1% 1/8W 0805 Yageo | RC0805FR-07487KLDigikey | 311-487KCRCT-ND | 1 | 4 | $0.10 | 1 | $0.40 https://www.digikey.com/product-detail/en/yageo/RC0805FR-07487KL/311-487KCRCT-ND/730930
U8 | L7805CV | IC REG LINEAR 5V 1.5A TO220AB STMicroelecronics | L7805CV | Digikey | 497-1443-5-ND | 1 | 4 | $0.52 | 1 | $2.08 https://www.digikey.com/product-detail/en/stmicroelectronics/L7805CV/497-1443-5-ND/585964
C8, C9, C26 | 0.022uF | CAP FILM 0.022UF 10% 100VDC RAD KEMET | R82EC2220AA50KDigikey | 399-19328-ND | 3 | 12 | $0.24 | 1 | $2.88 https://www.digikey.com/product-detail/en/kemet/R82EC2220AA50K/399-19328-ND/9685232
R7, R9, R10 | 1M | RES SMD 1M OHM 1% 1/8W 0805 Yageo | RT0805FRE071MLDigikey | YAG3361CT-ND | 3 | 12 | $0.11 | 1 | $1.32 https://www.digikey.com/product-detail/en/yageo/RT0805FRE071ML/YAG3361CT-ND/5418066
U3 | OPA1679 | IC AUDIO AMP 4 CIRCUIT 14SOIC Texas Instruments | OPA1679IDR | Digikey | 296-46621-1-ND | 1 | 4 | $1.20 | 1 | $4.80 https://www.digikey.com/product-detail/en/texas-instruments/OPA1679IDR/296-46621-1-ND/7219057
Q1, Q2 | | 7002 MOSFET N-CH 60V TO-236AB Nexperia | NX7002AK,215 | Digikey | 1727-1289-1-ND | 2 | 8 | $0.16 | 1 | $1.28 https://www.digikey.com/product-detail/en/nexperia-usa-inc/NX7002AK215/1727-1289-1-ND/4386095
R12 | 240R | RES 240 OHM 5% 1/8W 0805 Stackpole Electronics RMCF0805JT240RDigikey | RMCF0805JT240RCT-ND | 2 | 8 | $0.10 | 1 | $0.80 https://www.digikey.com/product-detail/en/stackpole-electronics-inc/RMCF0805JT240R/RMCF0805JT240RCT-ND/1942545
R13 | 2.8K | RES SMD 2.8K OHM 1% 1/8W 0805 Yageo | RC0805FR-072K8LDigikey | 311-2.80KCRCT-ND | 2 | 8 | $0.10 | 1 | $0.80 https://www.digikey.com/product-detail/en/yageo/RC0805FR-072K8L/311-2.80KCRCT-ND/730658
R14 | 5.6K | RES 5.6K OHM 5% 1/8W 0805 Stackpole Electronics RMCF0805JT5K60Digikey | RMCF0805JT5K60DKR-ND | 2 | 8 | $0.10 | 1 | $0.80 https://www.digikey.com/product-detail/en/stackpole-electronics-inc/RMCF0805JT5K60/RMCF0805JT5K60DKR-ND/1943478
R15 | 3.3K | RES 3.3K OHM 1% 1/8W 0805 Stackpole Electronics RMCF0805FT3K30Digikey | RMCF0805FT3K30CT-ND | 2 | 8 | $0.10 | 1 | $0.80 https://www.digikey.com/product-detail/en/stackpole-electronics-inc/RMCF0805FT3K30/RMCF0805FT3K30CT-ND/1942399
U6 | LM317 | IC REG LIN POS ADJ 1.5A TO220-3 Texas Instruments | LM317KCT | Digikey | 296-35739-5-ND | 2 | 8 | $0.58 | 1 | $4.64 https://www.digikey.com/product-detail/en/texas-instruments/LM317KCT/296-35739-5-ND/3929530
Pogo Pin | CONTACT SPRING LOADED T/H GOLD, Standard Stroke Mill Max Manufacturing Corp. 0906-1-15-20-75-14-11-0 Digikey | ED8181-ND | 10 | 60 | $0.52 | 10 | $31.02 https://www.digikey.com/product-detail/en/mill-max-manufacturing-corp/0906-1-15-20-75-14-11-0/ED8181-ND/1147049 Need 6 sets for 6 receivers
DIP SW 2 | SWITCH SLIDE DIP SPST 100MA 20V CTS Electrocomponents210-2MS | Digikey | CT2102MS-ND | 1 | 10 | $0.43 | 10 | $4.26 https://www.digikey.com/product-detail/en/cts-electrocomponents/210-2MS/CT2102MS-ND/2503779 Need 10 sets for 10 plates
Terminal Block Screw Connector TERM BLK 2POS SIDE ENTRY 5MM PCB Pheonix Contact | 1935161 Digikey | 277-1667-ND | 5 | 50 | $0.39 | 50 | $19.64 https://www.digikey.com/product-detail/en/phoenix-contact/1935161/277-1667-ND/568614 Need minimum 3 each for 10 plates, though 5 will allow for greater flexibility
K1, K2, K3, K4, K5a, K5b DPDT Relay | KEMET | UD2 5SNU | 6 | 25 | $1.84 | 25 | $46.00
Mini Butt Hinge | HOODDEAL 30pcs Mini Cabinet Drawer Butt Hinges Multifuction Accessories,18 x15 mm HOODDEAL | Amazon Prime | 1 | 1 | $5.98 | 30 | $5.98 https://www.amazon.com/dp/B00GTNTIPK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 (https://www.amazon.com/dp/B00GTNTIPK?rnid=2470954011&rps=1&s=industrial) Comes in a set of 30

## Please do your best to fill in the following details on your budget

| Total $ | Exact or estimated? | | If you had

## to use CNS space and equipment please answer the following quesitons:

Total Development cost: everything that was spent on your project including prototypes, transportation to research locations, renting of equipment, orders from a lab you worked at, your own money etc...?etc...

What is the minimum cost to make one prototype of your project ($0 is an option)? | $223.85
$223.85 + $50 for final build, plus about $100 for the prototype and power supply. Atmel ICE programmer was another $50. Total ~$425 Estimated | Why did your project require the use of CNS facilites?

Listed is exact cost, but likely an additional $50 brings total cost closer to $275 Roughly much time did you spend using CNS facilities?

## [specify hours or days]

## Total cost of items purchased through the

Active Learning Labs (ALL),

## if any

Same as total development cost. | Estimated | What equipment did you need to use?

## Total cost covered by the Harvard Research Lab(s) you are affiliated with, if any

0 | Exact | Who did you interact with at CNS
| | and how?

## Total cost of items purchase personally, if any

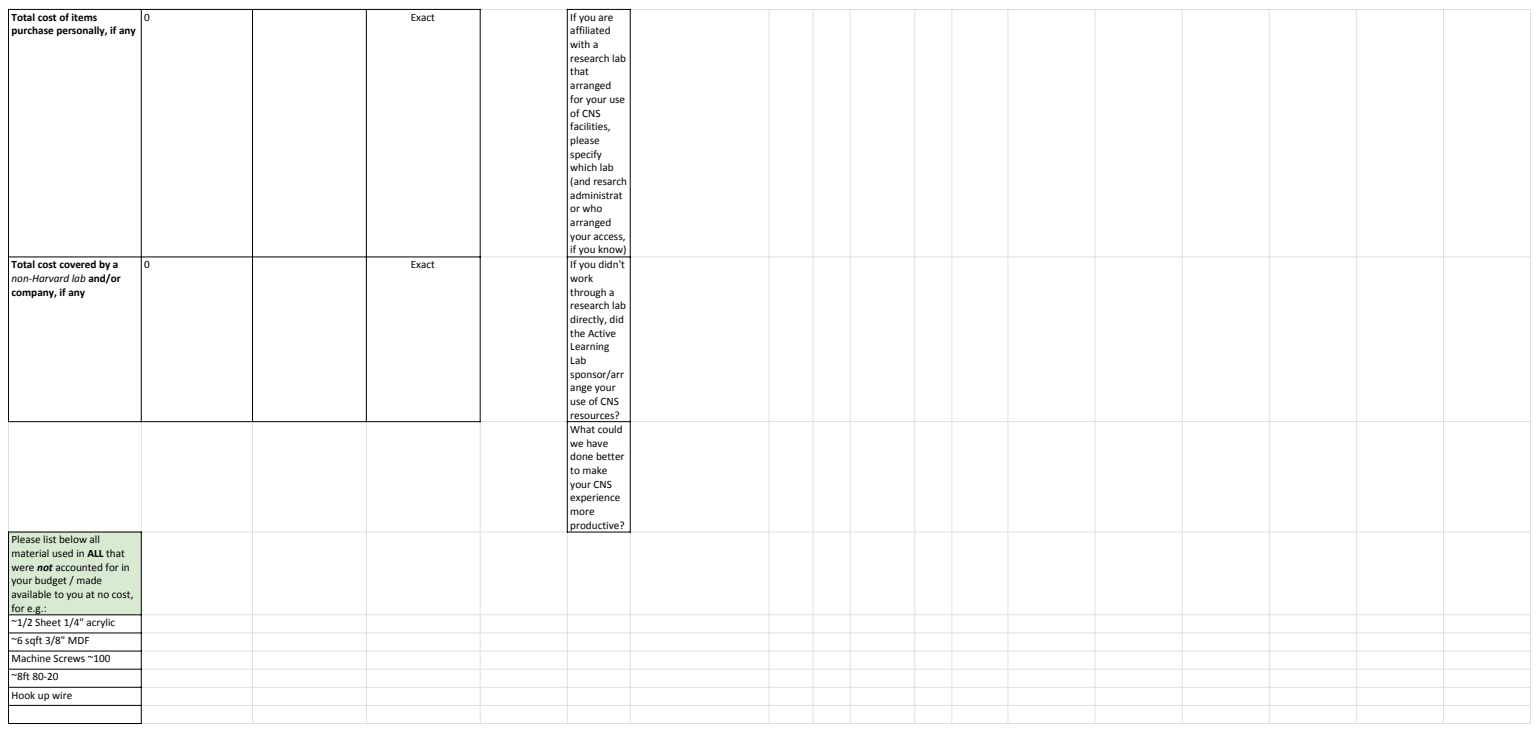
[picture p184: page 2]
Exact; If you are; affiliated with a; If you didn't work; done better to make your CNS experience more; productive?

research lab
that
arranged
for your use
of CNS
facilities,
please
specify which lab

(and resarch
administrat
or who
your access,
if you know)

Total cost covered by a
non-Harvard lab and/or
company, if any

through a
directly, did
the Active
Learning
Lab
sponsor/arr
ange your
use of CNS
resources? What could we have

Please list below all material used in ALL that were not accounted for in

your budget / made
available to you at no cost,
for e.g.:
~1/2 Sheet 1/4" acrylic
~6 sqft 3/8" MDF Machine Screws ~100

Hook up wire
