NickPham01/ES100/FinalReport/ReceiverBoardRev2.pdf

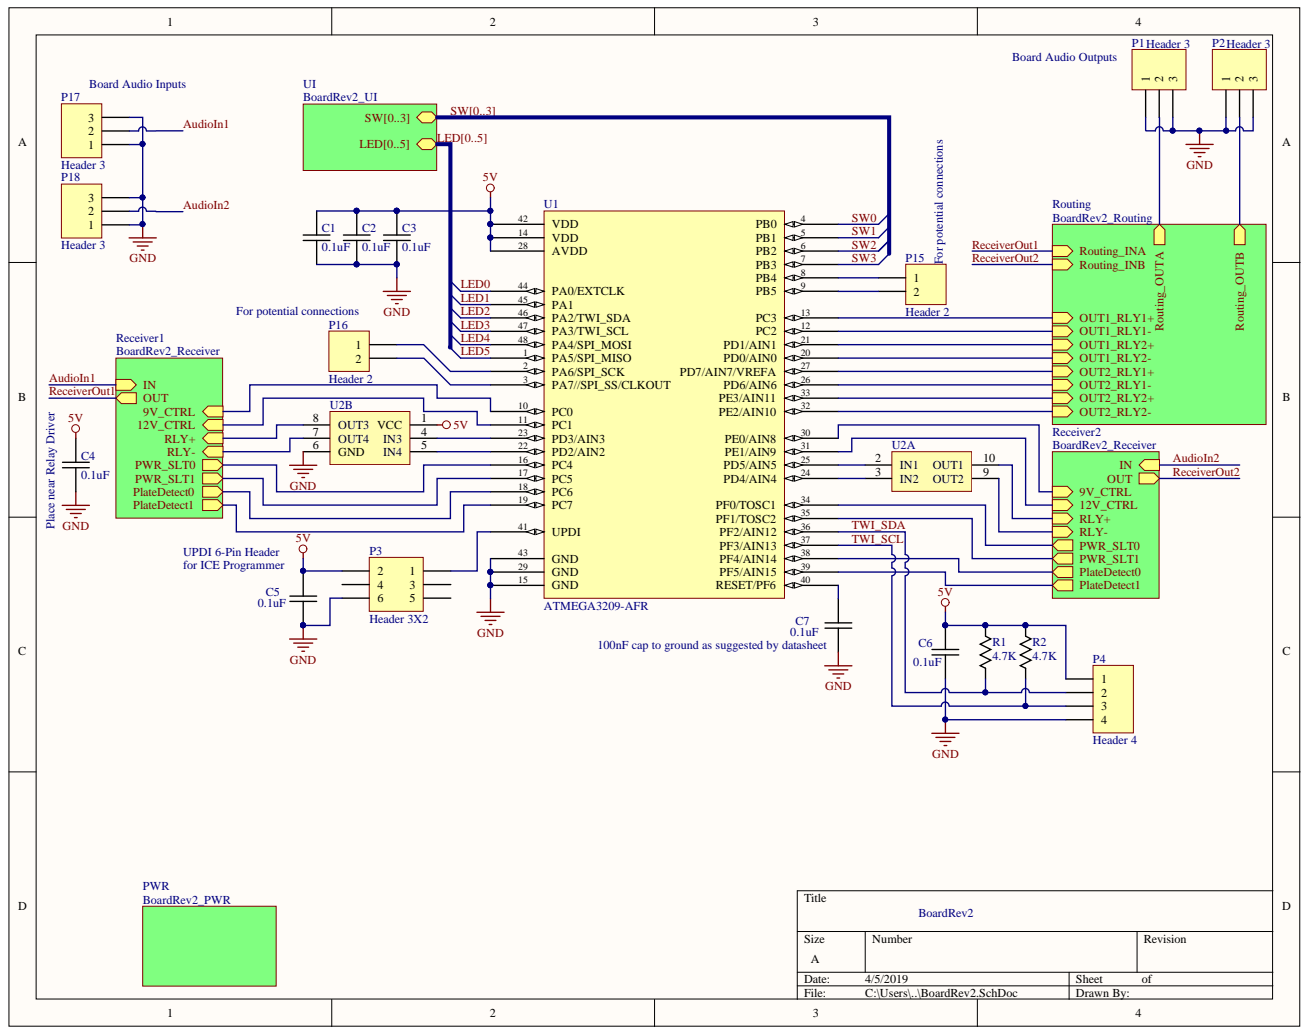
[picture p185: page 1]

Place near Relay Driver

O U T 3 VCC O U T 4 G N D IN 4 | 1

T WI_S D A
T WI_SCL

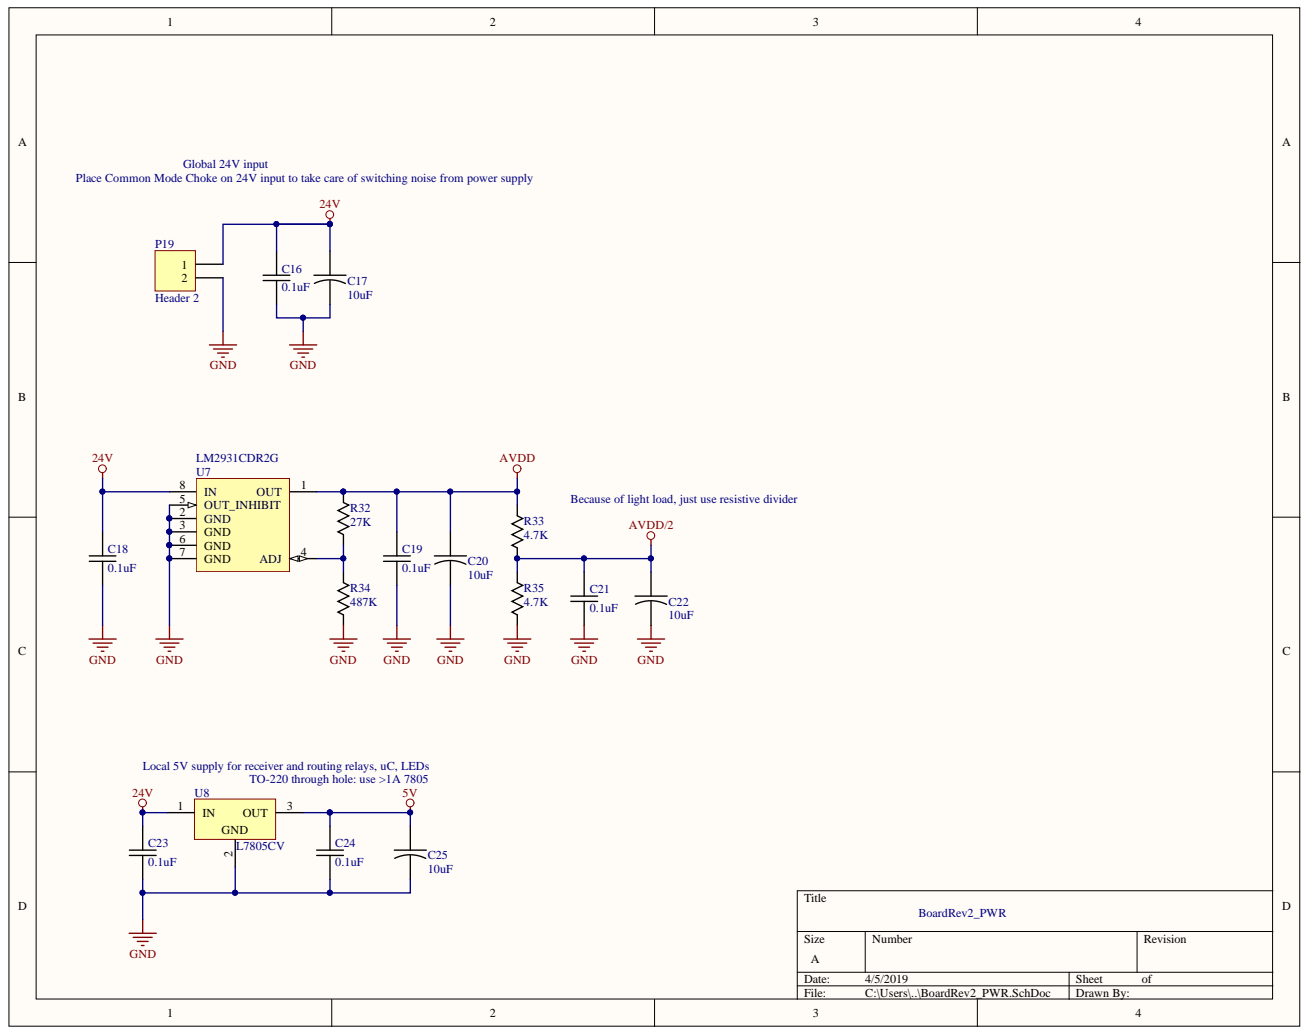
[picture p186: page 2]

Place Common Mode Choke on 24V input to take care of switching noise from power supply

Because of light load, just use resistive divider

Local 5V supply for receiver and routing relays, uC, LEDs

TO-220 through hole: use >1A 7805

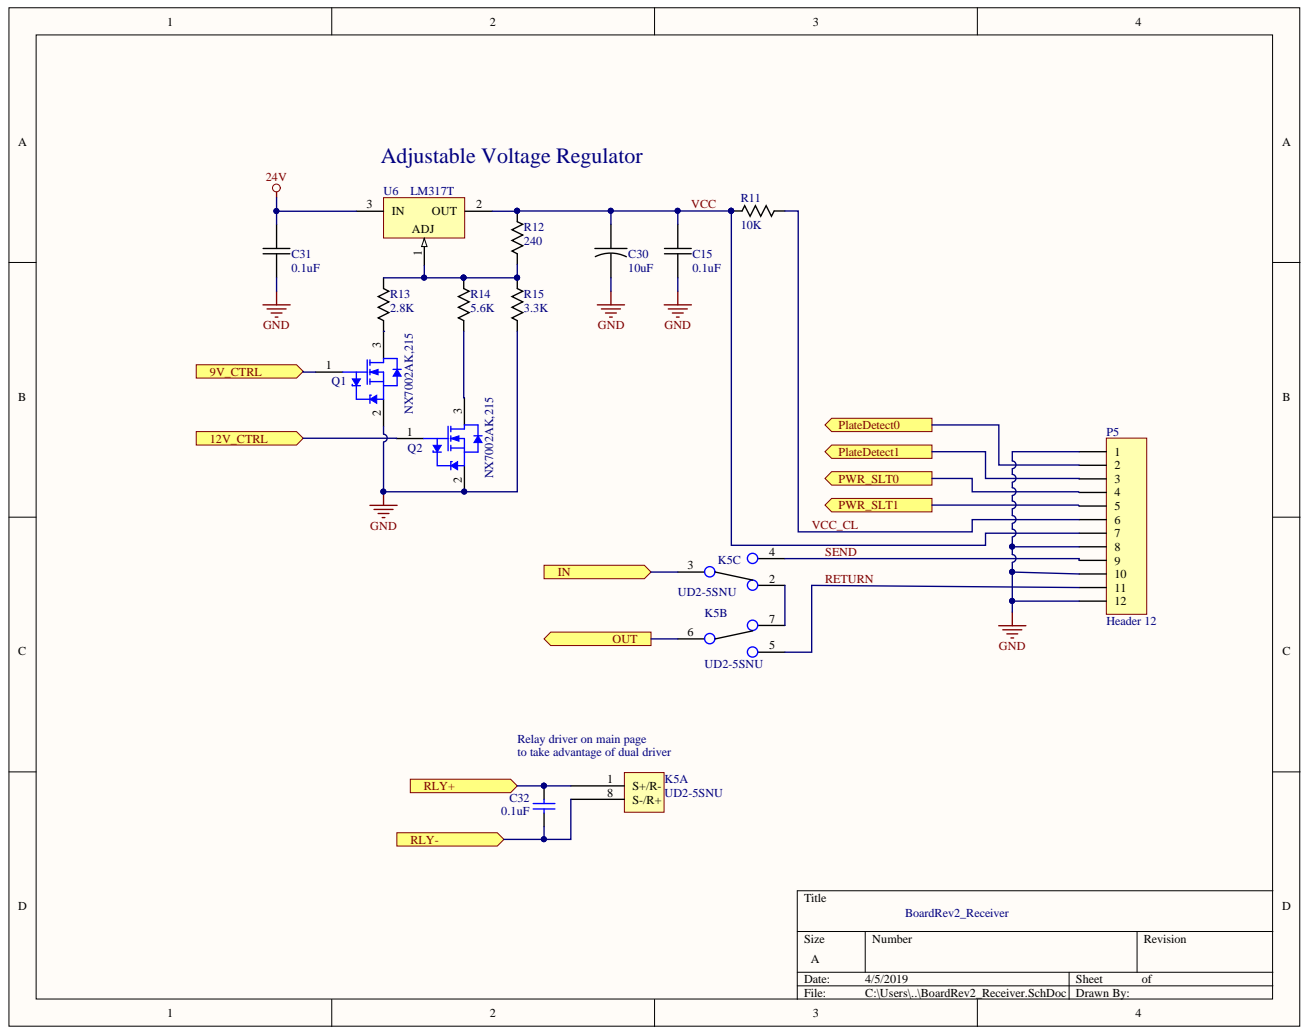
[picture p187: page 3]

Relay driver on main page
to take advantage of dual driver

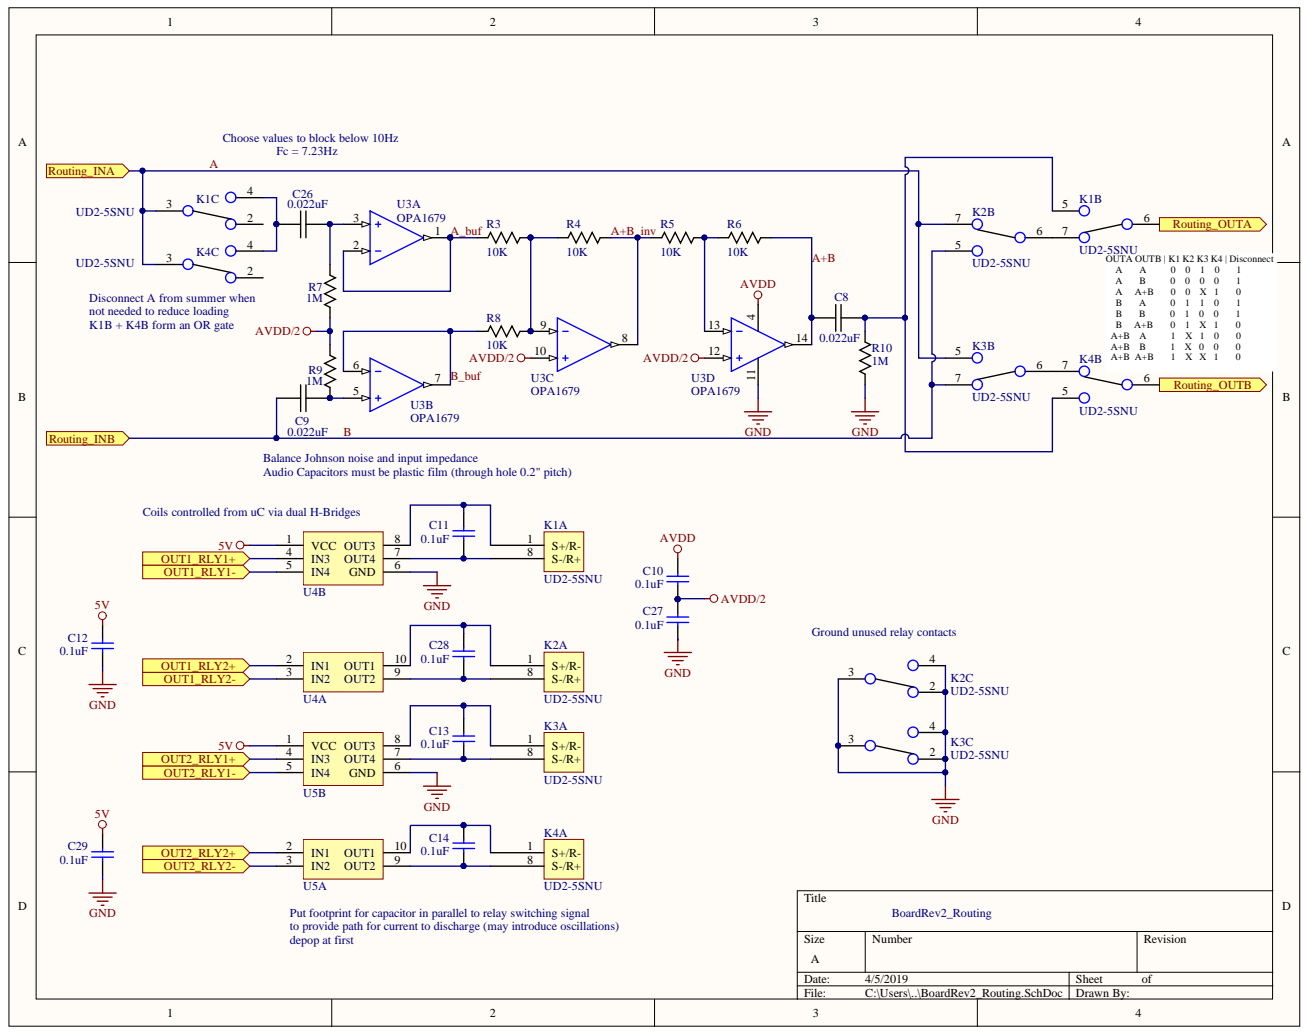
[picture p188: page 4]

Choose values to block below 10Hz

Disconnect A from summer when
not needed to reduce loading
K1B + K4B form an OR gate

Balance Johnson noise and input impedance
Audio Capacitors must be plastic film (through hole 0.2" pitch)

Coils controlled from uC via dual H-Bridges

Ground unused relay contacts

Put footprint for capacitor in parallel to relay switching signal
to provide path for current to discharge (may introduce oscillations)
depop at first

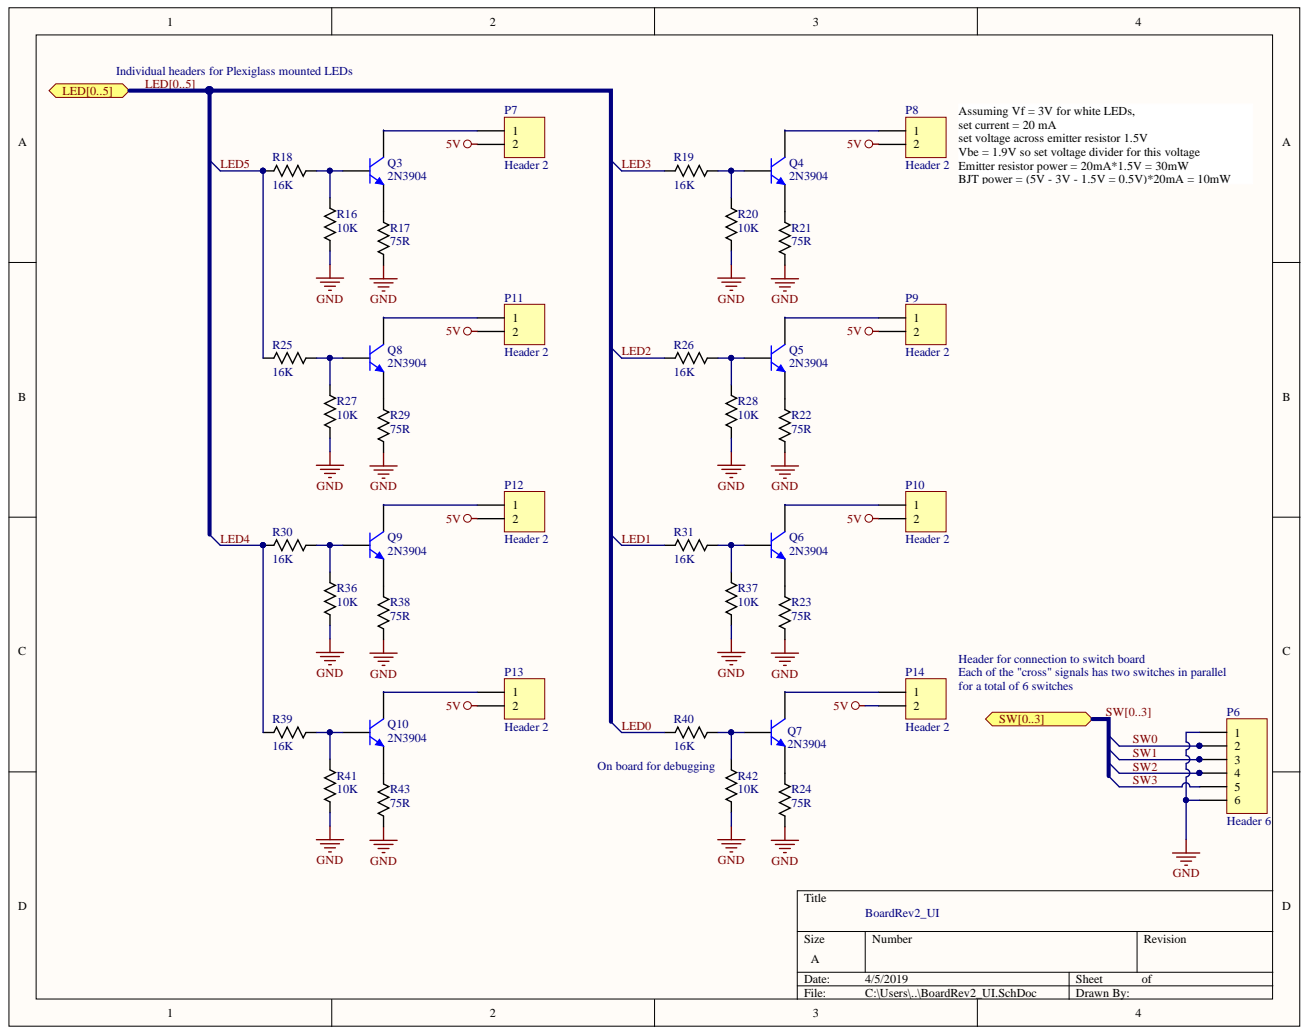
[picture p189: page 5]

On board for debugging

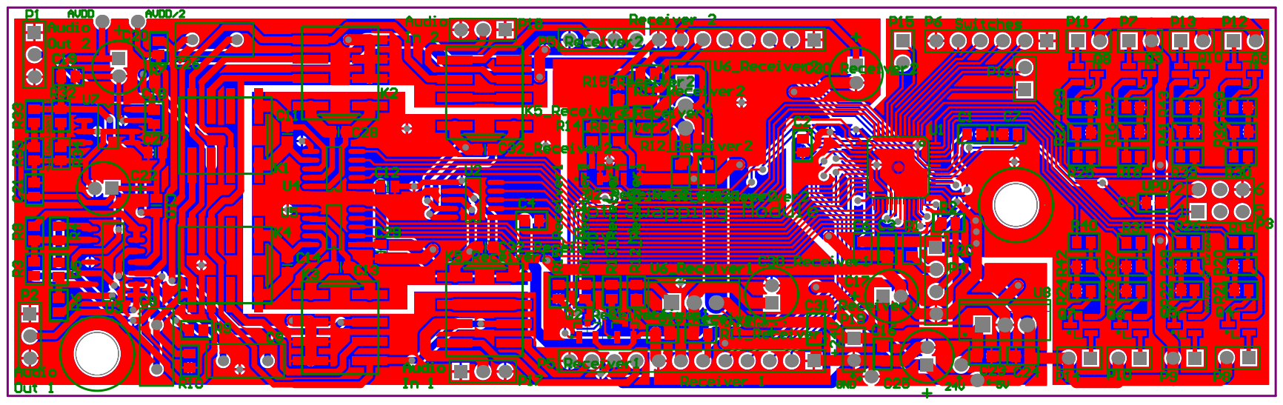
[picture p190: page 6]

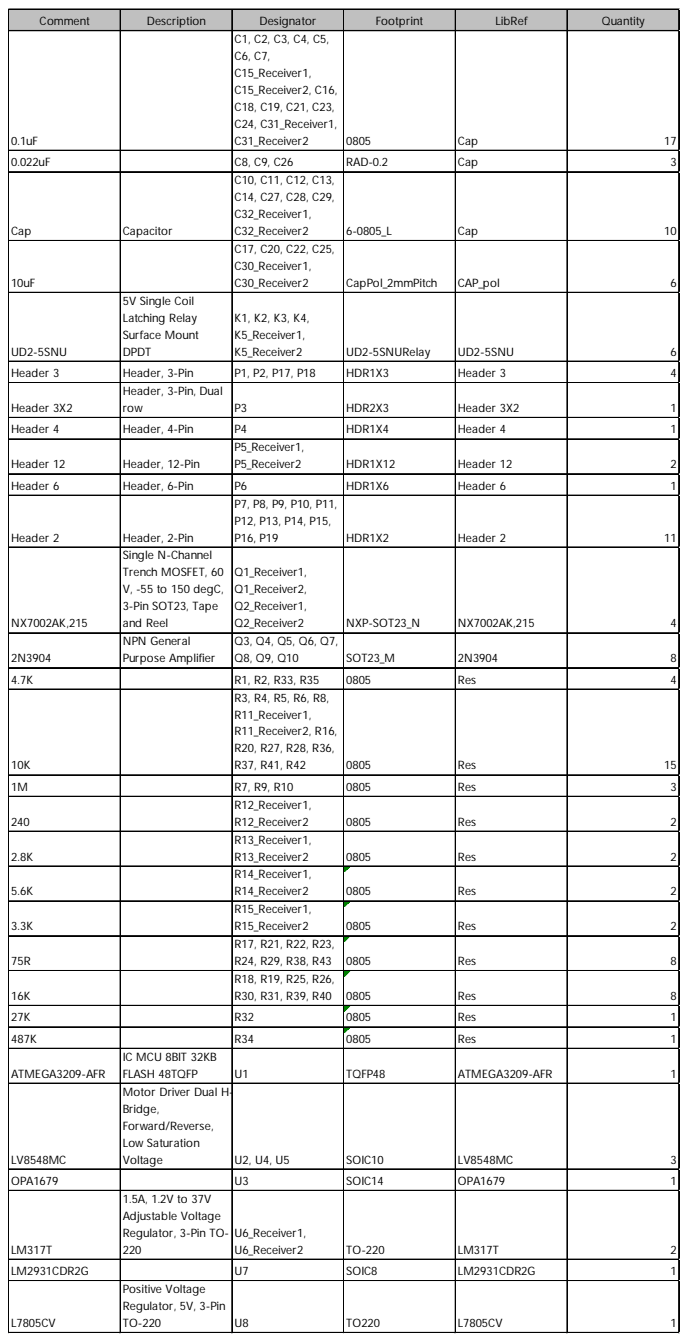
[picture p191: page 7]

Comment | Description | Designator | Footprint | LibRef | Quantity
0.1uF | | C1, C2, C3, C4, C5, C6, C7, C15_Receiver1, C15_Receiver2, C16, C18, C19, C21, C23, C24, C31_Receiver1, C31_Receiver2 | 0805 | Cap | 17

0.022uF | | C8, C9, C26 | RAD-0.2 | Cap | 3
Cap | Capacitor | C10, C11, C12, C13, C14, C27, C28, C29, C32_Receiver1, C32_Receiver2 | 6-0805_L | Cap | 10

10uF | | C17, C20, C22, C25, C30_Receiver1, C30_Receiver2 | CapPol_2mmPitch | CAP_pol | 6

UD2-5SNU | 5V Single Coil Latching Relay Surface Mount DPDT | K1, K2, K3, K4, K5_Receiver1, K5_Receiver2 | UD2-5SNURelay | UD2-5SNU | 6

Header 3 | Header, 3-Pin | P1, P2, P17, P18 | HDR1X3 | Header 3 | 4
Header 3X2 | Header, 3-Pin, Dual row | P3 | HDR2X3 | Header 3X2 | 1

Header 4 | Header, 4-Pin | P4 | HDR1X4 | Header 4 | 1
Header 12 | Header, 12-Pin | P5_Receiver1, P5_Receiver2 | HDR1X12 | Header 12 | 2

Header 6 | Header, 6-Pin | P6 | HDR1X6 | Header 6 | 1
Header 2 | Header, 2-Pin | P7, P8, P9, P10, P11, P12, P13, P14, P15, P16, P19 | HDR1X2 | Header 2 | 11

NX7002AK,215 | Single N-Channel Trench MOSFET, 60 V, -55 to 150 degC, 3-Pin SOT23, Tape and Reel | Q1_Receiver1, Q1_Receiver2, Q2_Receiver1, Q2_Receiver2 | NXP-SOT23_N | NX7002AK,215 | 4

2N3904 | NPN General Purpose Amplifier | Q3, Q4, Q5, Q6, Q7, Q8, Q9, Q10 | SOT23_M | 2N3904 | 8

4.7K | | R1, R2, R33, R35 | 0805 | Res | 4
10K | | R3, R4, R5, R6, R8, R11_Receiver1, R11_Receiver2, R16, R20, R27, R28, R36, R37, R41, R42 | 0805 | Res | 15

1M | | R7, R9, R10 | 0805 | Res | 3
240 | | R12_Receiver1, R12_Receiver2 | 0805 | Res | 2

2.8K | | R13_Receiver1, R13_Receiver2 | 0805 | Res | 2

5.6K | | R14_Receiver1, R14_Receiver2 | 0805 | Res | 2

3.3K | | R15_Receiver1, R15_Receiver2 | 0805 | Res | 2

75R | | R17, R21, R22, R23, R24, R29, R38, R43 | 0805 | Res | 8

16K | | R18, R19, R25, R26, R30, R31, R39, R40 | 0805 | Res | 8

27K | | R32 | 0805 | Res | 1

487K | | R34 | 0805 | Res | 1
ATMEGA3209-AFR | IC MCU 8BIT 32KB FLASH 48TQFP | U1 | TQFP48 | ATMEGA3209-AFR | 1

LV8548MC | Motor Driver Dual H-Bridge, Forward/Reverse, Low Saturation Voltage | U2, U4, U5 | SOIC10 | LV8548MC | 3

OPA1679 | | U3 | SOIC14 | OPA1679 | 1
LM317T | 1.5A, 1.2V to 37V Adjustable Voltage Regulator, 3-Pin TO- | U6_Receiver1, U6_Receiver2 | TO-220 | LM317T | 2

LM2931CDR2G | | U7 | SOIC8 | LM2931CDR2G | 1
L7805CV | Positive Voltage Regulator, 5V, 3-Pin TO-220 | U8 | TO220 | L7805CV | 1
