NickPham01/ES100/ProgressReport4/FullDesignV2_1SchemPrints.pdf

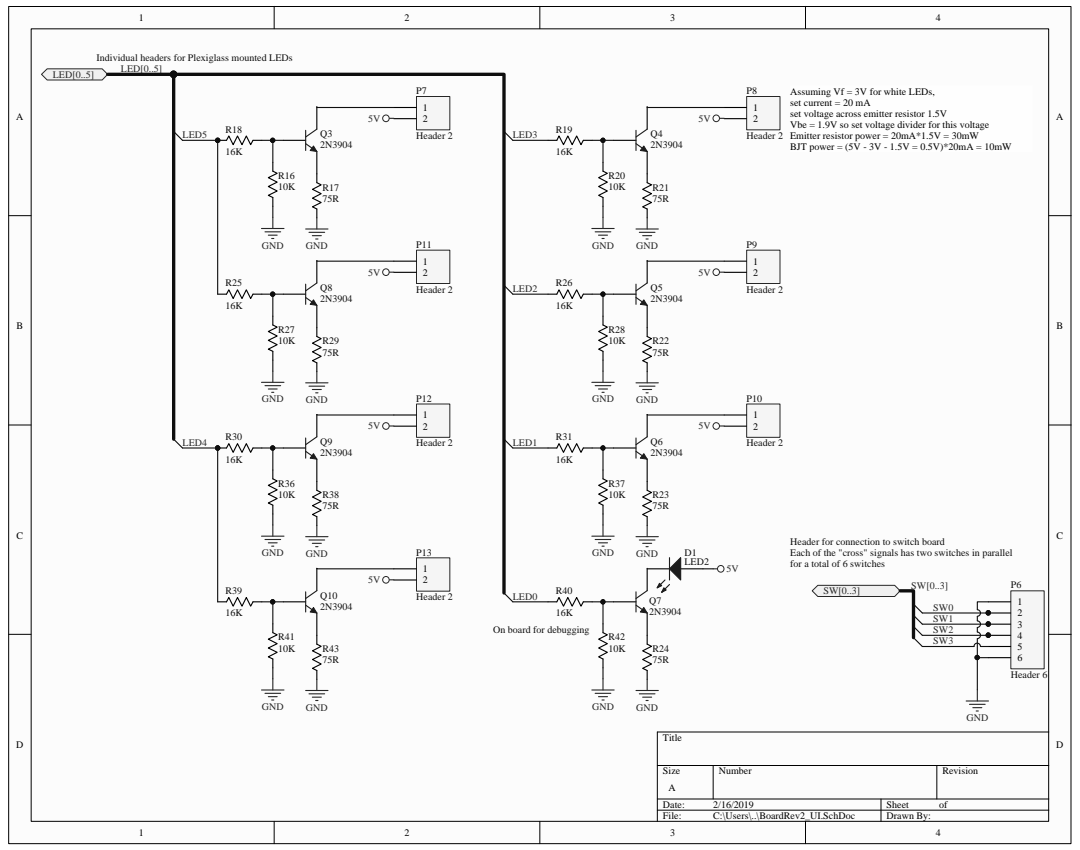
[picture p192: page 1]

Individual headers for Plexiglass mounted LEDs
LED[0..5]

Assuming Vf = 3V for white LEDs,
set current = 20 mA
set voltage across emitter resistor 1.5V
Vbe = 1.9V so set voltage divider for this voltage
Emitter resistor power = 20mA*1.5V = 30mW
BJT power = (5V - 3V - 1.5V = 0.5V)*20mA = 10mW

Header for connection to switch board
Each of the "cross" signals has two switches in parallel
for a total of 6 switches

On board for debugging
