NickPham01/ES100/ProgressReport4/FullImplementationV2_1.pdf

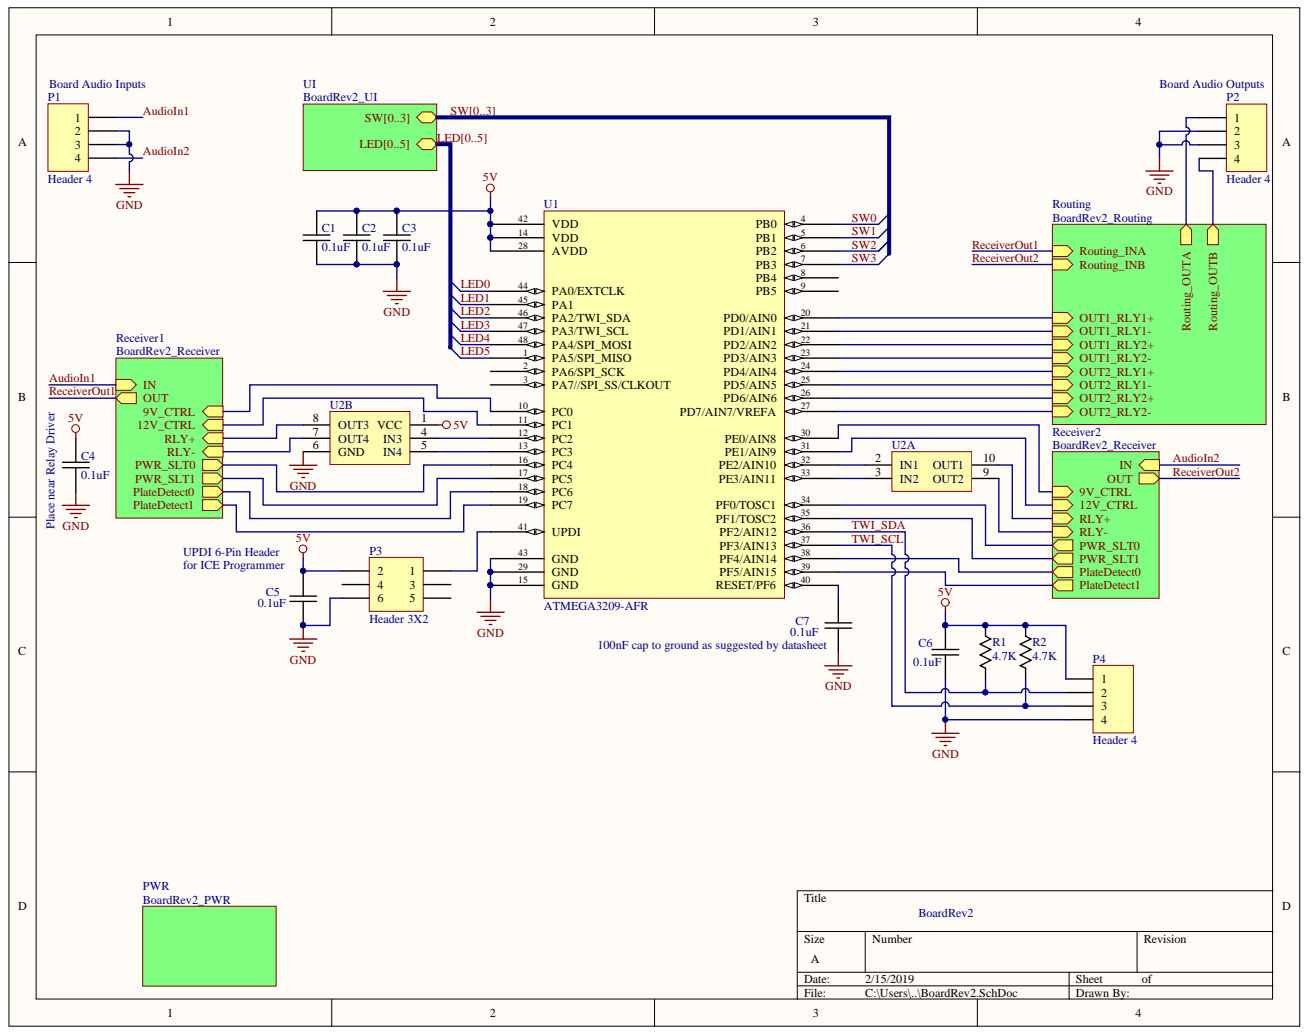
[picture p193: page 1]

Place near Relay Driver

O U T 3 VCC O U T 4 G N D IN 4 | 1

T WI_S D A
T WI_SCL

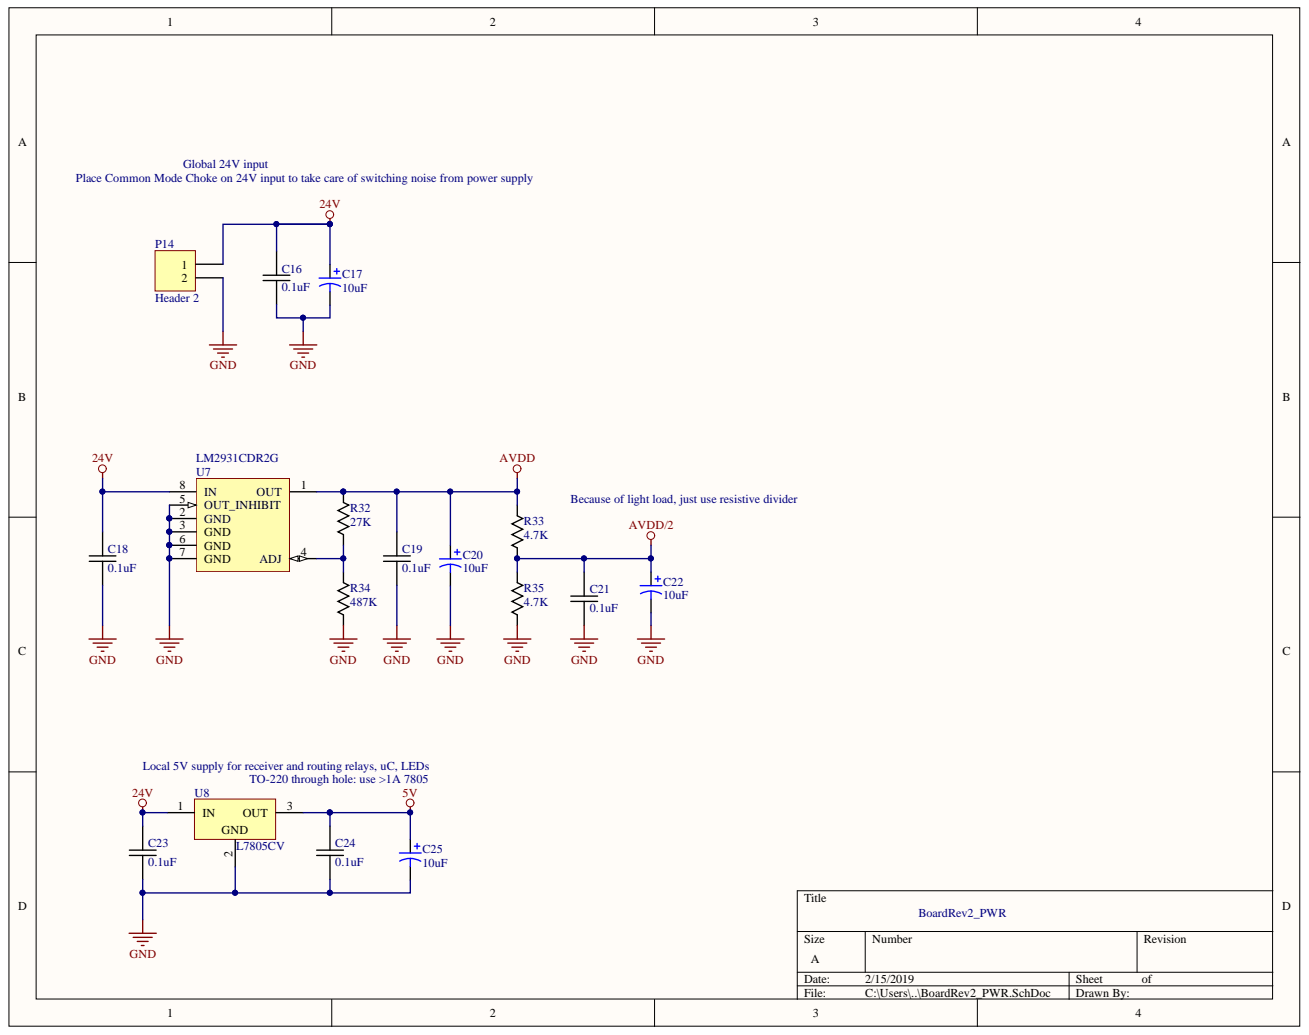
[picture p194: page 2]

Place Common Mode Choke on 24V input to take care of switching noise from power supply

Because of light load, just use resistive divider

Local 5V supply for receiver and routing relays, uC, LEDs

TO-220 through hole: use >1A 7805

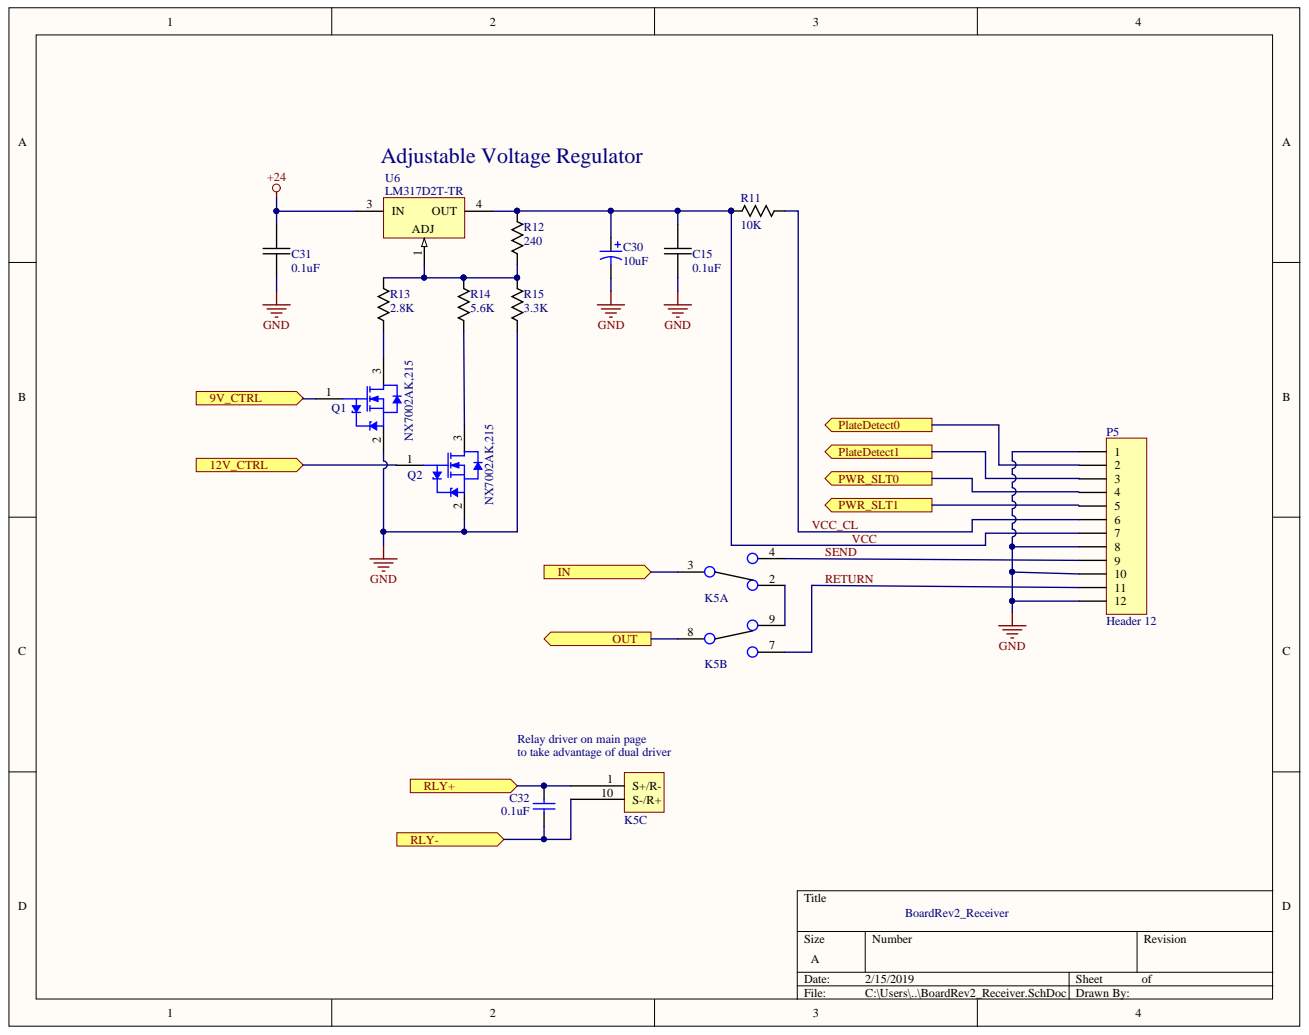
[picture p195: page 3]

Relay driver on main page
to take advantage of dual driver

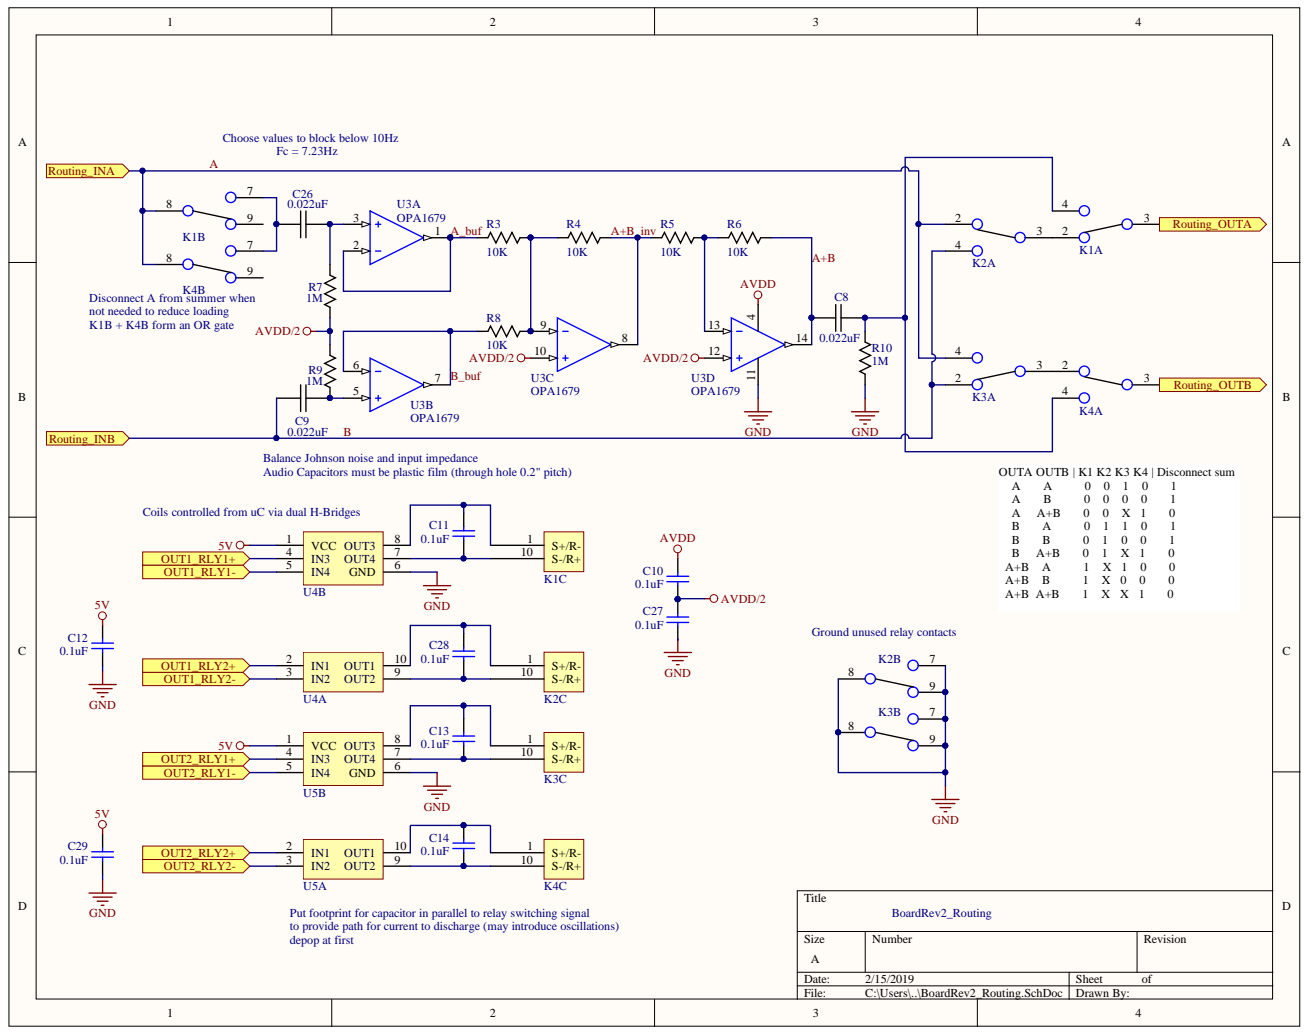
[picture p196: page 4]

Choose values to block below 10Hz

Disconnect A from summer when
not needed to reduce loading
K1B + K4B form an OR gate

Balance Johnson noise and input impedance
Audio Capacitors must be plastic film (through hole 0.2" pitch)

OUTA OUTB | K1 K2 K3 K4 | Disconnect sum

Coils controlled from uC via dual H-Bridges

Ground unused relay contacts

Put footprint for capacitor in parallel to relay switching signal
to provide path for current to discharge (may introduce oscillations)
depop at first

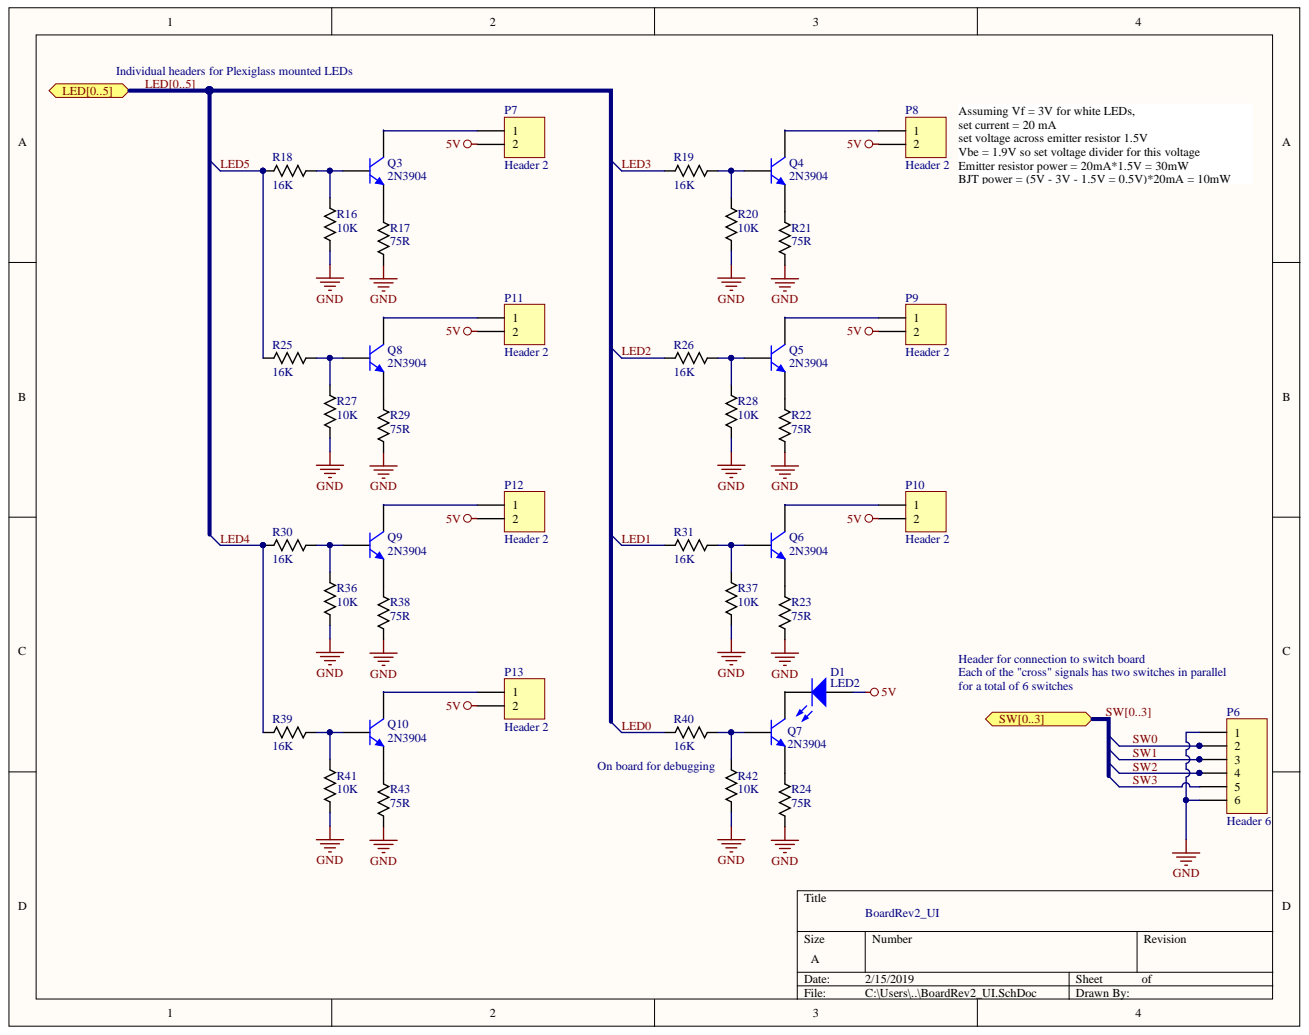
[picture p197: page 5]

On board for debugging

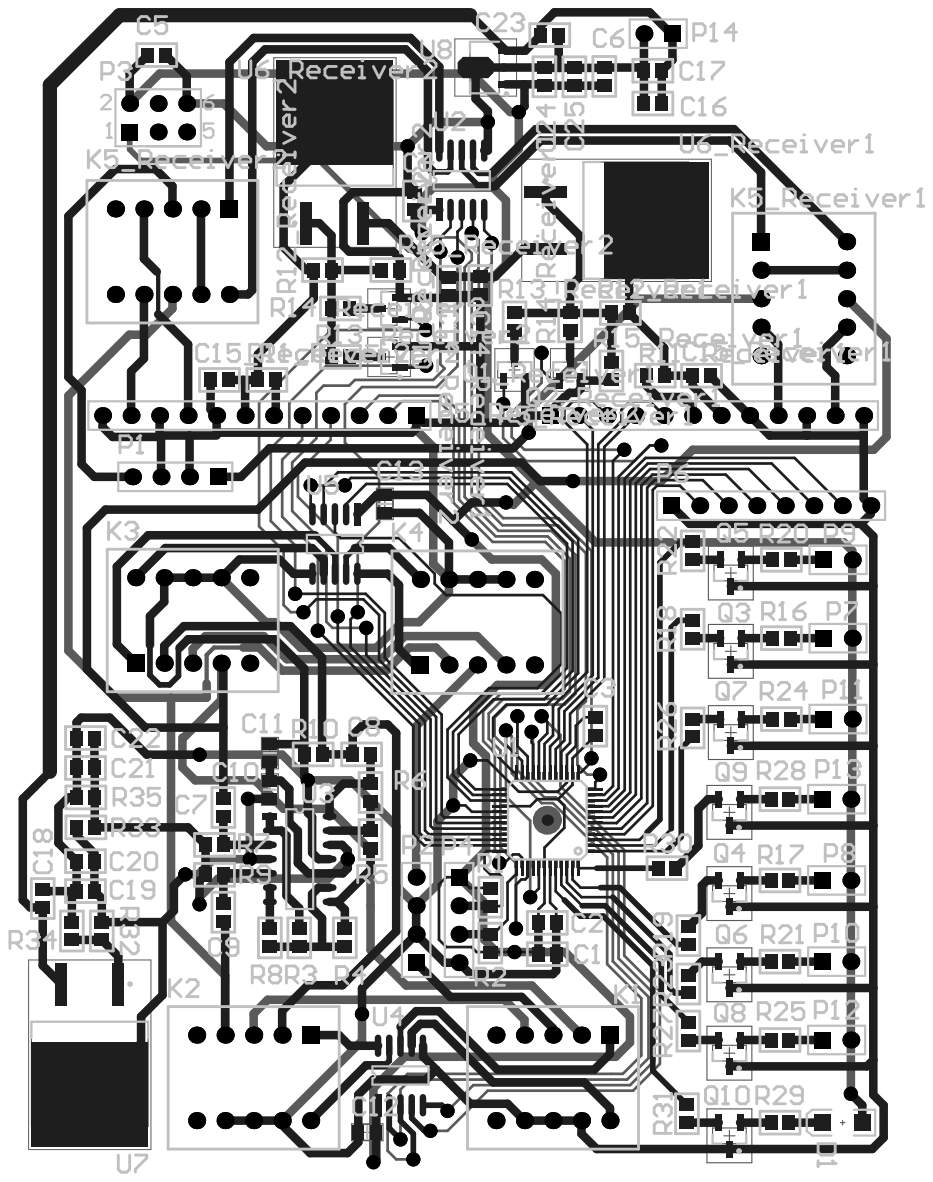
[picture p198: page 6]
