NickPham01/ES100/FinalReport/PR2Images/Sheet2.pdf

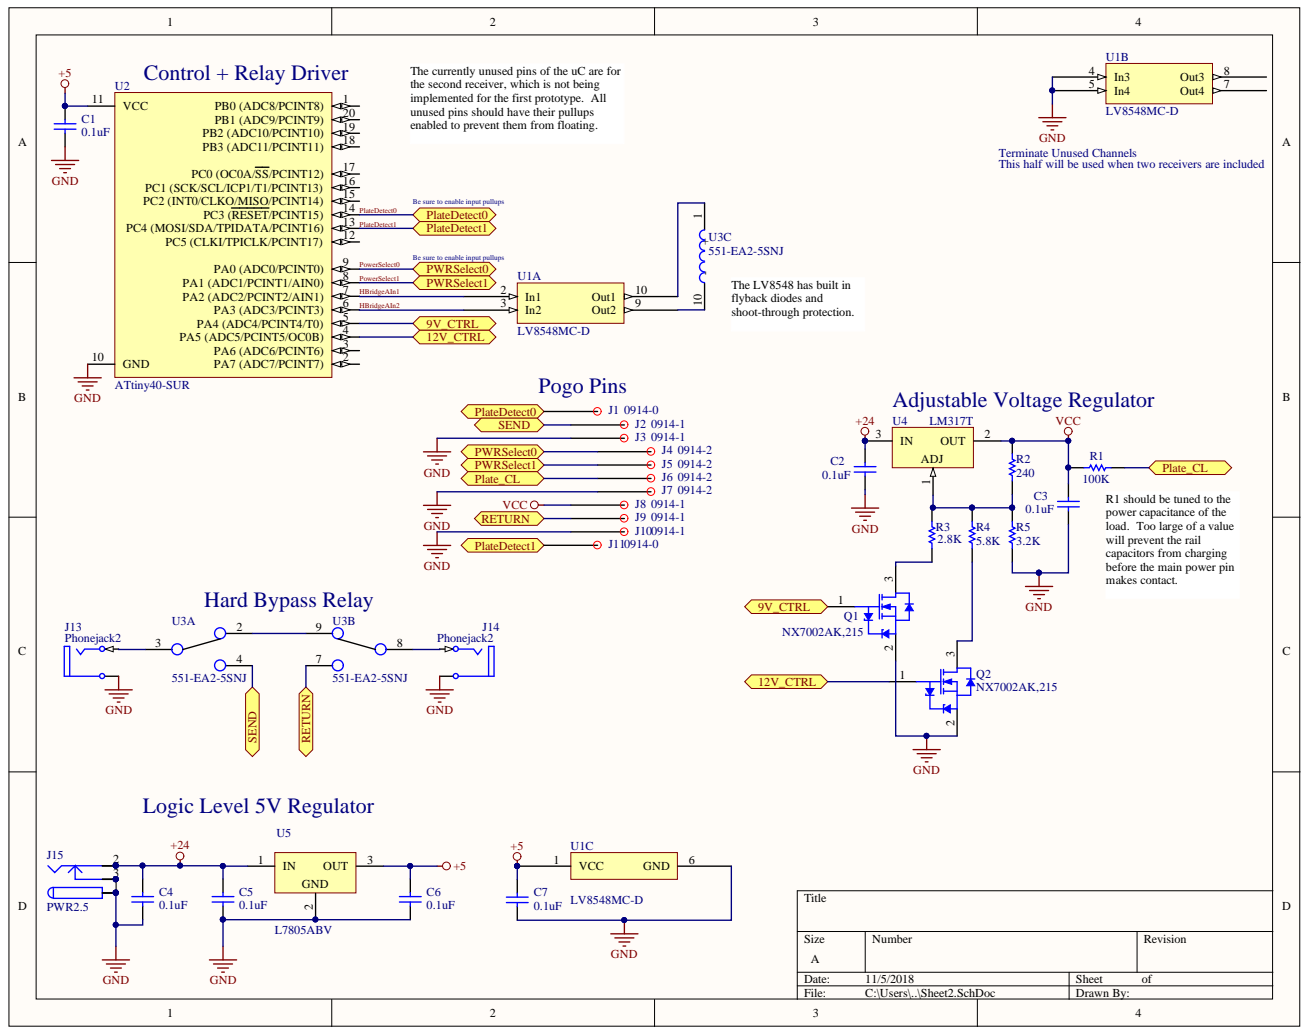
[picture p201: page 1]

The currently unused pins of the uC are for
the second receiver, which is not being
implemented for the first prototype. All
unused pins should have their pullups
enabled to prevent them from floating.

Terminate Unused Channels This half will be used when two receivers are included

Be sure to enable input pullups
PlateDetect0
PlateDetect1

PWRSelect0
PWRSelect1

The LV8548 has built in
flyback diodes and
shoot-through protection.

R1 should be tuned to the
power capacitance of the
load. Too large of a value
will prevent the rail
capacitors from charging
before the main power pin
makes contact.

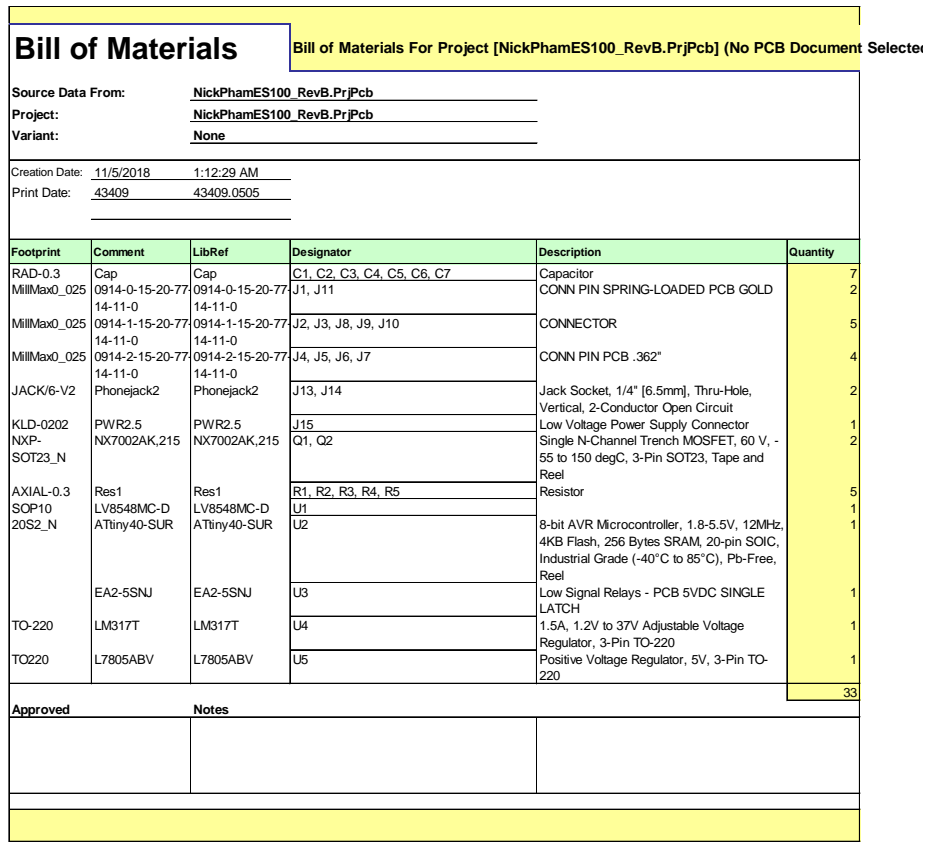
[picture p202: page 2]

Vertical, 2-Conductor Open Circuit

55 to 150 degC, 3-Pin SOT23, Tape and
Reel

4KB Flash, 256 Bytes SRAM, 20-pin SOIC,
Industrial Grade (-40°C to 85°C), Pb-Free,
