NickPham01/ES100/FinalReport/SMDLEDFixture.pdf

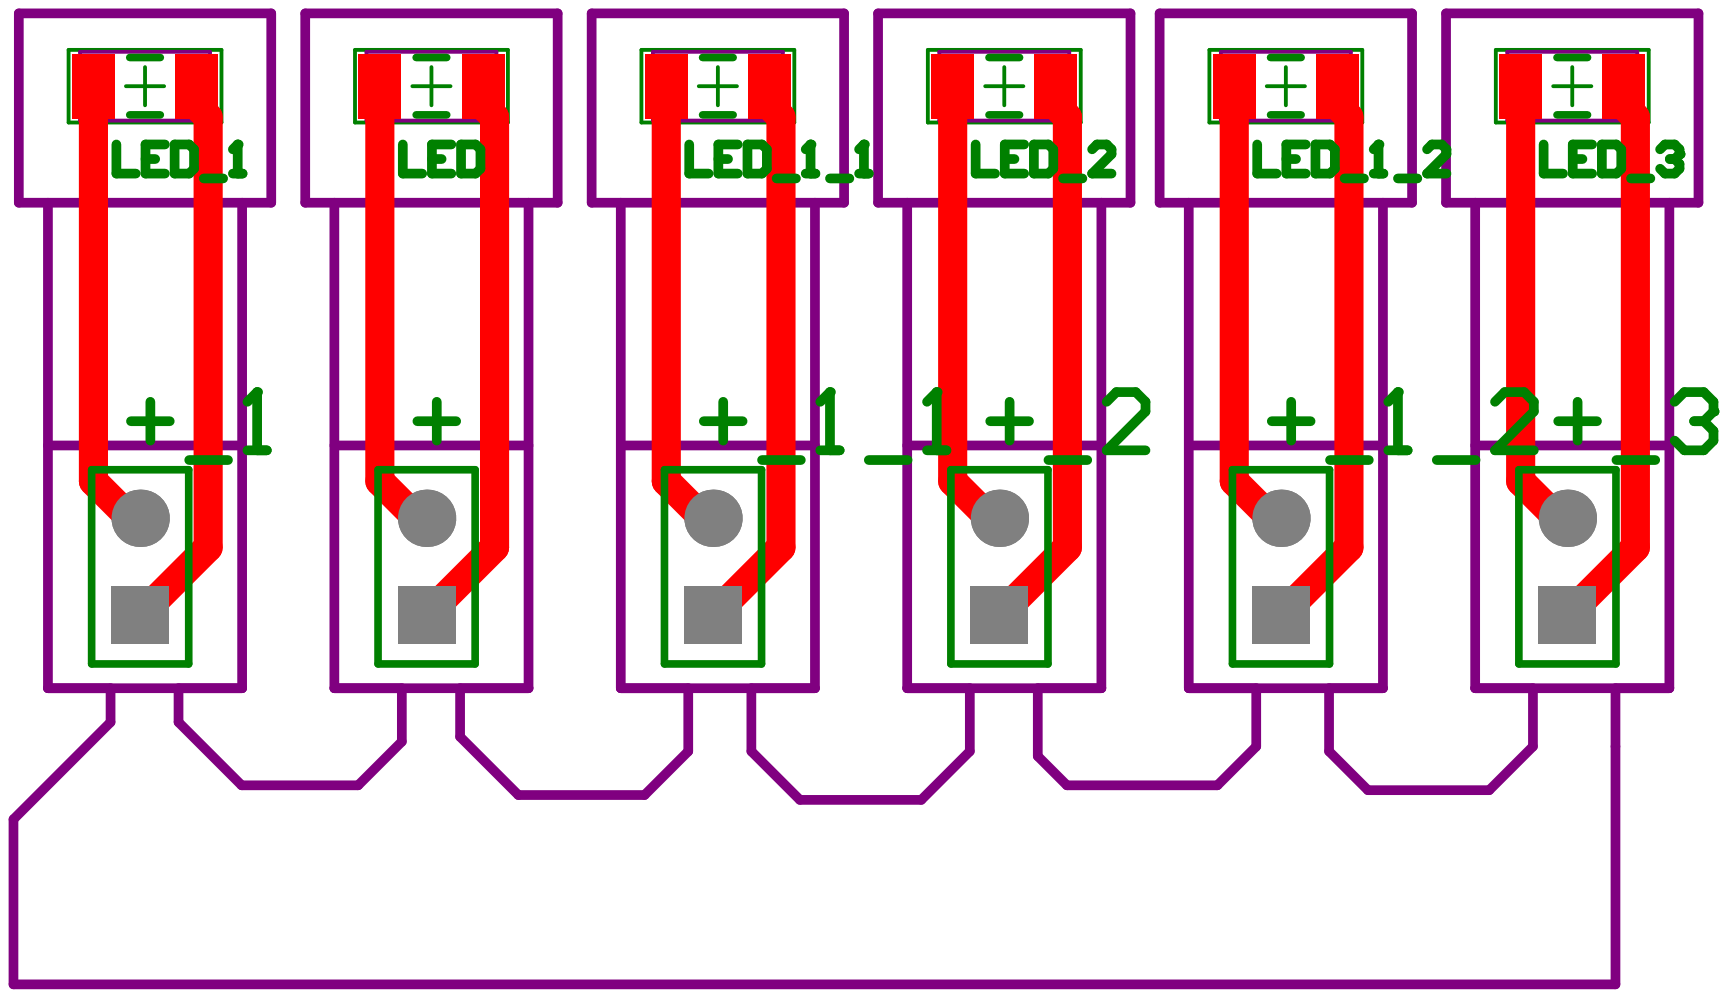
[picture p203: page 1]
