NickPham01/ES100/(commit log)

2018-10-09 adding existing files
    [Popular Guitar Pedals_ Characteristics - DimensionData.csv, Popular Guitar Pedals_ Characteristics.xlsx]
2018-10-11 Add Solidworks files of pedal footprint blanks
    [BossCompact.SLDPRT, BossDual.SLDPRT, EHXLarge.SLDPRT, EHXMed.SLDPRT, EHXSmall.SLDPRT, TCMini.SLDPRT, TCStandard.SLDPRT]
2018-10-11 "First plate prototype, ready to laser cut"
    [PlatePrototype_small1.SLDPRT]
2018-10-11 Uploading files from printed blanks
    [BossCompact.DXF, EHXSmall.DXF, PlatePrototype_small1.DXF]
2018-10-11 pushing PlatePrototype Folder
    [BossCompact.SLDPRT, BossDual.SLDPRT, EHXLarge.SLDPRT, EHXMed.SLDPRT, EHXSmall.SLDPRT, EQLarge.SLDPRT, EQStandard.SLDPRT, JHSStandard.SLDPRT]
2018-10-11 cleaning up PlatePrototype folder
    [PlatePrototype_small01.SLDPRT, PlatePrototype_small1.SLDPRT]
2018-10-12 Pedal Blanks Done with thru holes for 6-32 screws. EQLarge doesn't work because screw dimensions are too large.
    [BossCompact.SLDPRT, BossDual.SLDPRT, EHXLarge.SLDPRT, EHXMed.SLDPRT, EHXSmall.SLDPRT]
2018-10-18 Plate Prototype 2 with reciever outline
    [BossDual.DXF, BossDual.SLDPRT, EHXLarge.DXF, EHXMed.DXF, EQStandard.DXF, JHSStandard.DXF, KeeleyStandard.DXF, KeeleyStandard.SLDPRT]
2018-11-06 All graphics should be done for PR2
    [PlatePrototype_PCBshape.DXF, PlatePrototype_PCBshape.SLDPRT, PlatePrototype_PCBshape.STEP, ReceiverPCB.SLDPRT, ReceiverPlate_asm.SLDASM, mill-max-0914-0-15-20-77-14-11-0.SLDPRT, mill-max-0914-1-15-20-77-14-11-0.SLDPRT, mill-max-0914-2-15-20-77-14-11-0.SLDPRT]
2019-01-25 Adding measurement files from scope
    [10PogoPins.SLDASM, 10PogoPins.STEP, 10PogoPinsPart.SLDASM, ACJS-MHOM.stp, BossCompact.DXF, BossCompact.SLDPRT, BossDual.DXF, BossDual.SLDPRT]
2019-02-04 adding measurements of prototype
    [APSystemFR.xls, APSystemTHD.xls, APSystemTHD_00.xls, APSystemTHD_01.xls, APSystemTHD_02.xls, DeviceActiveChoke.xls, DeviceActiveChoke_FR.xls, DeviceBypassChoke.xls]
2019-02-13 PR4 images from schematic
2019-02-15 PR4 in progress...
    [APSystemFR.xls, APSystemTHD.xls, APSystemTHD_00.xls, APSystemTHD_01.csv, APSystemTHD_01.xls, APSystemTHD_02.xls, DeviceActiveChoke.xls, DeviceActiveChoke_FR.csv]
2019-02-16 PR4 writing complete
    [tek0000.csv, tek0001.csv, tek0002.csv, tek0003.csv, tek0004.csv]
2019-03-23 Tek measurements for Module Board
2019-04-03 Working on Final Report
    [APSystemFR.xls, APSystemTHD.xls, APSystemTHD_00.xls, APSystemTHD_01.csv, APSystemTHD_01.xls, APSystemTHD_02.xls, DeviceActiveChoke.xls, DeviceActiveChoke_FR.csv]
